NEFSC/PEMAD-ESB-IchthystickII/Documentation/WorkingDrafts/ManufacturingManual/pics/20210115_140601.jpg

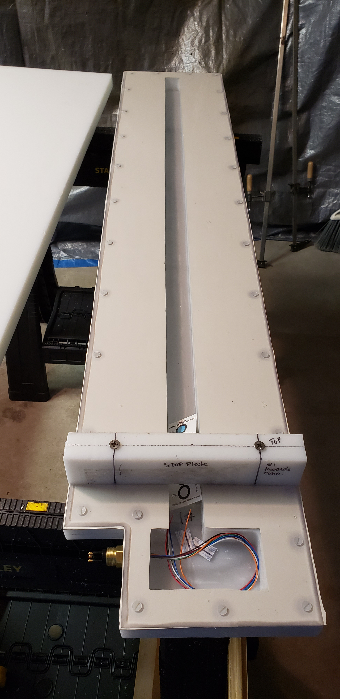
Documentation/WorkingDrafts/ManufacturingManual/pics/20210115_140601.jpg
