NEFSC/PEMAD-ESB-IchthystickII/Documentation/WorkingDrafts/ManufacturingManual/pics/20201014_175649.jpg

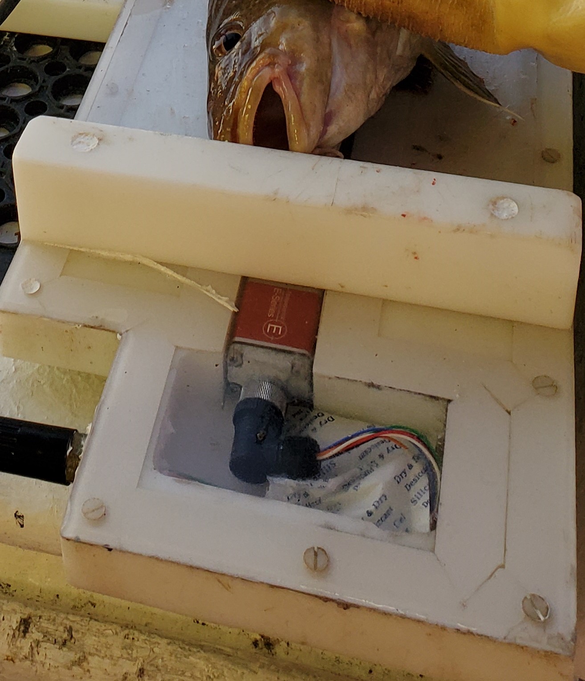
Documentation/WorkingDrafts/ManufacturingManual/pics/20201014_175649.jpg
