NEFSC/PEMAD-ESB-IchthystickII/Schematics/CircuitBoard_Design/!readme1st.md

These designs were done with ExpressPCB Plus Layout and Schematic software.
https://www.expresspcb.com/
