NEFSC/PEMAD-ESB-IchthystickII/Schematics/DisplayDesign_files/CableAssy_IFMB-10406RevB.pdf

# CABLE ASSY IFMB-10406

# Ichthystick II Electronic Fish Measuring Board Case

### D (Generation 3) linear utput connector to onnector. Revision B es the mating connector P-FW07-R connector M12 (D84) receptacle

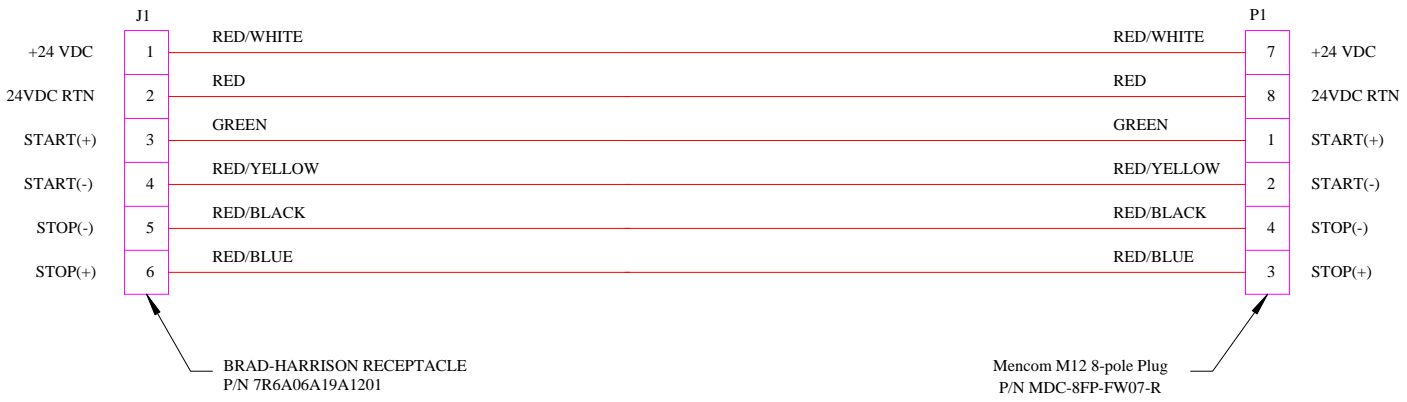
[picture p3: figure]
BRAD-HARRISON RECEPTACLE P/N 7R6A06A19A1201; RED/WHITE; RED; +24 VDC; 24VDC RTN; GREEN; RED/YELLOW; RED/BLACK; RED/BLUE; STOP(-); STOP(+); START(-); START(+); Mencom M12 8-pole Plug P/N MDC-8FP-FW07-R
