NEFSC/PEMAD-ESB-IchthystickII/Schematics/FMB_Display_PartsList.xls

Icthystick Electronic Fish Measuring Board: Parts List
Part ID | Part Type | Description | Qty | Cost | Total | Source P/N | Part Source | Notes
FMB Circuit Board A1 Parts:
A1 |  | Lengthboard Circuit Card (PCB) | 1 | $67.28 | $67.28 |  | Express PCB | Production Service (Qty=4) = $269.11.. (Qty = 10, $308.50)
C1 | 0.01uF | Tantalum, +/- 10% | 1 | $0.17 | $0.17 | 490-3812-ND | Digikey
C2 | 1uF | Tantalum, +/- 10% | 1 | $0.46 | $0.46 | 478-1835-ND | Digikey
C3 | 0.1uF | Tantalum, +/- 10% | 1 | $0.46 | $0.46 | 478-1831-ND | Digikey
C4 | 0.1uF | Tantalum, +/- 10% | 1 | $0.46 | $0.46 | 478-1831-ND | Digikey
C5 | 0.1uF | Tantalum, +/- 10% | 1 | $0.46 | $0.46 | 478-1831-ND | Digikey
C6 | 0.1uF | Tantalum, +/- 10% | 1 | $0.46 | $0.46 | 478-1831-ND | Digikey
C7 | 100uF | Tantalum, +/- 10% | 1 | $2.59 | $2.59 | 478-1844-ND | Digikey
C8 | 10uF | Tantalum, +/- 10% | 1 | $0.71 | $0.71 | 478-1841-ND | Digikey
D1 |  | Red LED, radial, 3 mm, T-1 | 1 | $0.53 | $0.53 | 511-1190-ND | Digikey
A1J1 |  | Molex P/N 22-23-2101 | 1 | $1.31 | $1.31 | WM4208-ND | Digikey | Power and RS-232 Input Header (10-Pin)
A1J2 |  | Molex P/N 22-23-2031 | 1 | $0.66 | $0.66 | WM4201-ND | Digikey | LCD Display Header (3-Pin)
A1J3 |  | Molex P/N 22-23-2101 | 1 | $1.31 | $1.31 | WM4208-ND | Digikey | Interface Control (10-Pin)
A1J4 |  | Sullins P/N PPTC071LFBN-RC, (Single Row, 7 Pins) | 1 | $0.63 | $0.63 | S7005-ND |  | SparkFun Micro SD Header
A1J5 |  | Molex P/N 22-23-2061 | 1 | $1.03 | $1.03 | WM4204-ND | Digikey | Length Sensor Header (6-Pin)
A1J6 |  | Sullins P/N PPTC062LFBN-RC, (Dual Row, 12 Pins) | 1 | $1.14 | $1.14 | S7074-ND | Digikey | Mate for Sena Parani ESD110 12-Pin connector
A1P1 |  | Molex P/N 22-01-3107 | 1 | $0.73 | $0.73 | WM2008-ND | Digikey | Input Power and RS 232 10-Pin Connector.
A1P2 |  | Molex P/N 22-01-3037 | 1 | $0.22 | $0.22 | WM2001-ND | Digikey | LCD Display 3-Pin Connector
A1P3 |  | Molex P/N 22-01-3107 | 1 | $0.73 | $0.73 | WM2008-ND | Digikey | Interface Control 10-Pin Connector
A1P4 |  | optional | 0 |  |  |  |  | SparkFun Micro SD Connector
A1P5 |  | Molex P/N 22-01-3067 | 1 | $0.44 | $0.44 | WM2004-ND | Digikey | Length Sensor 6-Pin Connector.
 | Sockets | Molex P/N 08-55-0102 | 100 | $0.28 | $28.00 | WM2312-ND | Digikey | Contact terminals (female) for connectors.
R1 | 10K | 0.25 W, carbon composite resistor, +/- 5% | 1 | $0.42 | $0.42 | OD103JE-ND | Digikey
R2 | 10K | 0.25 W, carbon composite resistor, +/- 5% | 1 | $0.42 | $0.42 | OD103JE-ND | Digikey
R3 | 10K | 0.25 W, carbon composite resistor, +/- 5% | 1 | $0.42 | $0.42 | OD103JE-ND | Digikey
R4 | 4.7K | 0.25 W, carbon composite resistor, +/- 5% | 1 | $0.42 | $0.42 | OD472JE-ND | Digikey
R5 | 4.7K | 0.25 W, carbon composite resistor, +/- 5% | 1 | $0.42 | $0.42 | OD472JE-ND | Digikey
R6 | 4.7K | 0.25 W, carbon composite resistor, +/- 5% | 1 | $0.42 | $0.42 | OD472JE-ND | Digikey
R7 | 4.7K | 0.25 W, carbon composite resistor, +/- 5% | 1 | $0.42 | $0.42 | OD472JE-ND | Digikey
R8 | 1.2k | 0.25 W, carbon composite resistor, +/- 5% | 1 | $0.42 | $0.42 | OD122JE-ND | Digikey
R11 | 100 | 0.25 W, carbon composite resistor, +/- 5% | 1 | $0.42 | $0.42 | OD101JE-ND | Digikey
R12 | 20K | 0.25 W, carbon composite resistor, +/- 5% | 1 | $0.42 | $0.42 | OD203JE-ND | Digikey
R13 | 20K | 0.25 W, carbon composite resistor, +/- 5% | 1 | $0.42 | $0.42 | OD203JE-ND | Digikey
R14 | 100 | 0.25 W, carbon composite resistor, +/- 5% | 1 | $0.42 | $0.42 | OD101JE-ND | Digikey
R15 | 20K | 0.25 W, carbon composite resistor, +/- 5% | 1 | $0.42 | $0.42 | OD203JE-ND | Digikey
R16 | 20K | 0.25 W, carbon composite resistor, +/- 5% | 1 | $0.42 | $0.42 | OD203JE-ND | Digikey
R18 | 20K | 0.25 W, carbon composite resistor, +/- 5% | 1 | $0.42 | $0.42 | OD203JE-ND | Digikey
R19 | 20K | 0.25 W, carbon composite resistor, +/- 5% | 1 | $0.42 | $0.42 | OD203JE-ND | Digikey
R20 | 20K | 0.25 W, carbon composite resistor, +/- 5% | 1 | $0.42 | $0.42 | OD203JE-ND | Digikey
R21 | 20K | 0.25 W, carbon composite resistor, +/- 5% | 1 | $0.42 | $0.42 | OD203JE-ND | Digikey
U1 | P8X32A-D40 | Parallax Propeller Microcontroller | 1 | $12.95 | $12.95 |  | Parallax | www.parallax.com
U2 | MAX3232 | MAX3232ECPE+-ND, RS232 Driver by MAXIM | 1 | $3.87 | $3.87 | 99K3240 | Newark
U3 | 24LC256 | 24LC256-E/P 256K EEPROM by MICROCHIP | 1 | $1.02 | $1.02 | 54K2864 | Newark | Newark only sells -I/P Type. I indicates Temp range -45 to 85 C. E = -45 to 125 C.
U4 | 24LC256 | 24LC256-E/P 256K EEPROM by MICROCHIP | 1 | $1.02 | $1.02 | 54K2864 | Newark | Newark only sells -I/P Type. I indicates Temp range -45 to 85 C. E = -45 to 125 C.
U5 | LM1086-3.3 | LM1086CT-3.3-NOPB by National Semiconductor | 1 | $2.44 | $2.44 | 41K3395 | Newark
U6 | PT78H205 | PT78HT205H-ND by Texas Instruments | 1 | $13.45 | $13.45 | 75C7141 | Newark | Integrated Switching Regulator, Vin=9V min.
U7 | SN75179B | RS 422 Line Driver by Texas Instruments | 1 | $1.29 | $1.29 | 60K6930 | Newark | Have 4 already…
U9 | CC3-1212DFE | Lambda Ultra Compact 3W Dual-Output DC-DC converter | 1 | $11.10 | $11.10 | 05M6992 | Newark
 | ESD110V2 | ESD110V2 Bluetooth Transceiver, Sena Technologies | 1 | $62.00 | $62.00 | ESD110V2-01 | Sena Tech | www.lemosint.com
SP1 | BRP1408 | ICC Inc. Audio Alarm P/N BRP1408P-12-CS | 1 | $0.50 | $0.50 | 623-2004 | Allied | Audio Alarm
Q1 | 2N3904 | 2N3904G Bipolar Transistor NPN, ON Semiconductor | 10 | $0.05 | $0.50 | 45J2473 | Newark
X1 | 5MHz | ECS-50-20-4 5.0 MHz Crystal Oscillator by ECS | 1 | $0.58 | $0.58 | X410-ND | Digikey | This is a 5.0000 MHz crystal
 |  | DIP Socket, 8-Pin, SPC P/N SPC15494 | 2 | $0.06 | $0.12 | 82K7786 | Newark
 |  | DIP Socket, 16-Pin, SPC P/N SPC15498 | 1 | $0.12 | $0.12 | 82K7788 | Newark
 |  | DIP Socket, 40-Pin, SPC P/N SPC15505 | 1 | $0.30 | $0.30 | 82K7793 | Newark
Display Case Parts:
 | LCD | Parallax Serial LCD display, 4 x 20 | 1 | $39.99 | $39.99 | 27979 | Parallax | www.parallax.com
 |  | Display Case (P/O Fiberglass Display Case price..) | 1 | $50.79 | $50.79 | 39C8379 | Newark
S1 | Power Switch | SAIA-Burgess TH25 Push button P/N 511015 | 1 | $6.63 | $6.63 | 804-4504 | Allied | IP67 Rated Switch, Maintained
S2 | Menu Switch | Bulgin P/N MP0042/3 | 1 | $4.72 | $4.72 | 95M9941 | Newark | IP67 Rated Switch, Momentary
S3 | Prev Switch | Bulgin P/N MP0042/3 | 1 | $4.72 | $4.72 | 95M9941 | Newark | IP67 Rated Switch, Momentary
S4 | Next Switch | Bulgin P/N MP0042/3 | 1 | $4.72 | $4.72 | 95M9941 | Newark | IP67 Rated Switch, Momentary
S5 | Enter Switch | Bulgin P/N MP0042/3 | 1 | $4.72 | $4.72 | 95M9941 | Newark | IP67 Rated Switch, Momentary
 | Green Lens | SAIA-Burgess TH25 Flat Lens P/N 561211 | 1 | $1.22 | $1.22 | 804-4522 | Allied | Green lens for Power push button
 | Contact Blocks | SAIA-Burgess TH25 Contact Blocks P/N 593566-000 | 2 | $6.57 | $13.14 | 804-1100 | Allied | Contact Blocks, 1N.O./N.C. quick connect
 | Lamp/LED | T 1-3/4 " Midget Groove Green LED, P/N 1512135UG3 | 1 | $4.45 | $4.45 | 234-3125 | Allied | 24 VDC LED for Power Switch S1
 | LED Indicator | SloanLED 5/16" Low-Profile Water Resistant LED Ind, P/N 253-21 | 1 | $15.43 | $15.43 | 265-1611 | Allied | 2 VDC LED, panel mounted, for Display Assy.
 | Receptacle | Brad-Harrison P/N 7R6A06A19A1201, Micro-Change 6 Pin Male | 1 | $21.33 | $21.33 |  | Brad-Harrison | Receptacle for Fishboard Case
 | Receptacle | Brad-Harrison P/N 7R6A00A19A1201, Micro-Change 6 Pole Female | 1 | $22.64 | $22.64 |  | Brad-Harrison | Receptacle for Display Case
 | Cable Assy | Brad-Harrison P/N 776030D02F1201, Micro-Change 6 Pole Male/Female | 1 | $44.25 | $44.25 |  | Brad-Harrison | Cable Assy between Fishboard and Display (12 foot.)
 | Closure Cap | Brad-Harrison P/N 70015, Micro-Change Male Thread Cap | 2 | $5.85 | $11.70 |  | Brad-Harrison
 | Closure Cap | Brad-Harrison P/N 70010, Micro-Change Female Thread Cap | 2 | $6.06 | $12.12 |  | Brad-Harrison
 | Receptacle | Bulgin Circular Connector P/N PX0738/S | 1 | $14.83 | $14.83 | 48F2460 | Newark | Receptacle for Display Case
 |  |  | TOTAL: |  | $506.00
S1 | PowerSwitch Alternate | NKK P/N YB16WRKW01-5F24-JF-R0 |  | $21.96 |  | YB16WRKW01-5F24-JF-ND | Digikey
 | Menu - Alternate | NKK P/N YB15WRKW01-GB-R0 |  | $13.66 |  | YB15WRKW01-GB-ND | Digikey
