NEFSC/PEMAD-ESB-IchthystickII/Documentation/WorkingDrafts/ManufacturingManual/pics/20201223_102427.jpg

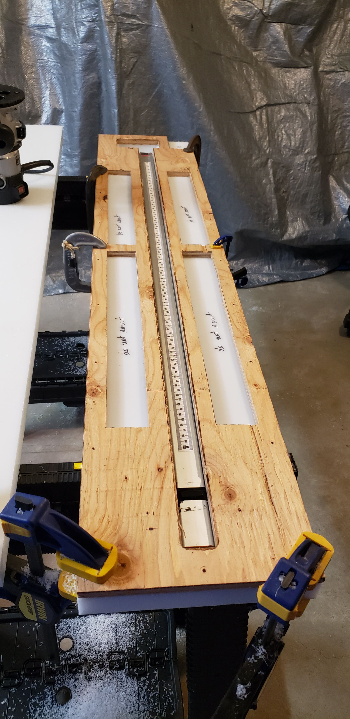
Documentation/WorkingDrafts/ManufacturingManual/pics/20201223_102427.jpg
