NEFSC/PEMAD-ESB-IchthystickII/Documentation/WorkingDrafts/ManufacturingManual/pics/20201223_102439.jpg

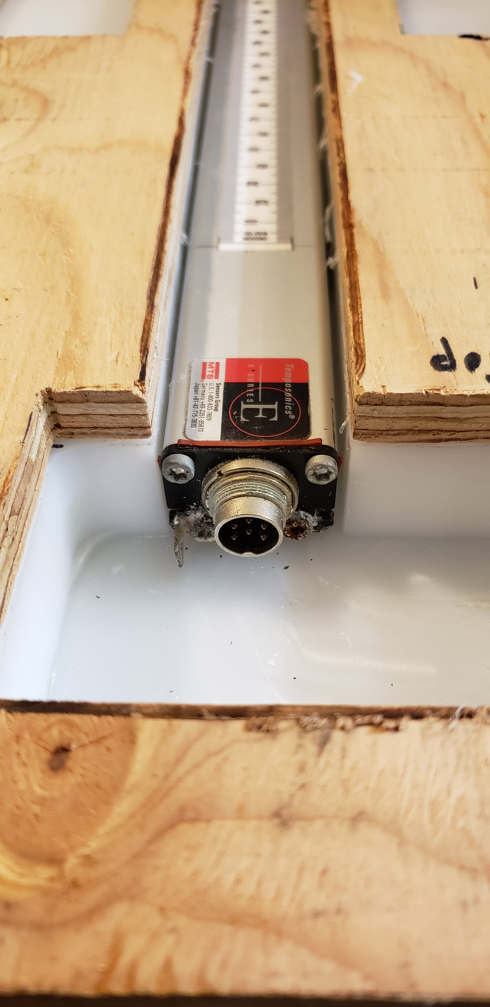
Documentation/WorkingDrafts/ManufacturingManual/pics/20201223_102439.jpg
