NEFSC/PEMAD-ESB-IchthystickII/Documentation/WorkingDrafts/ManufacturingManual/pics/20201223_105548.jpg

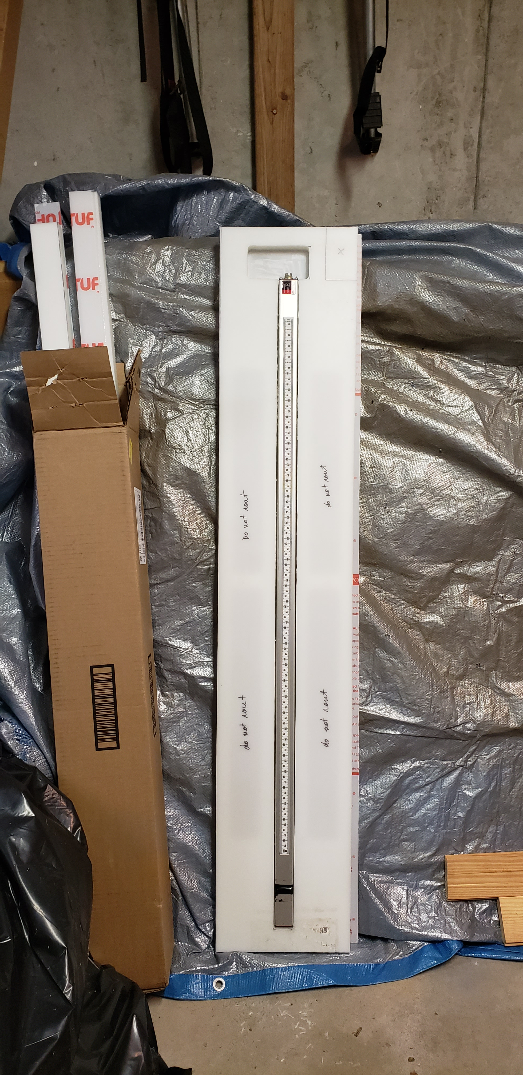
Documentation/WorkingDrafts/ManufacturingManual/pics/20201223_105548.jpg
