NEFSC/PEMAD-ESB-IchthystickII/Documentation/WorkingDrafts/ManufacturingManual/pics/20210114_083233.jpg

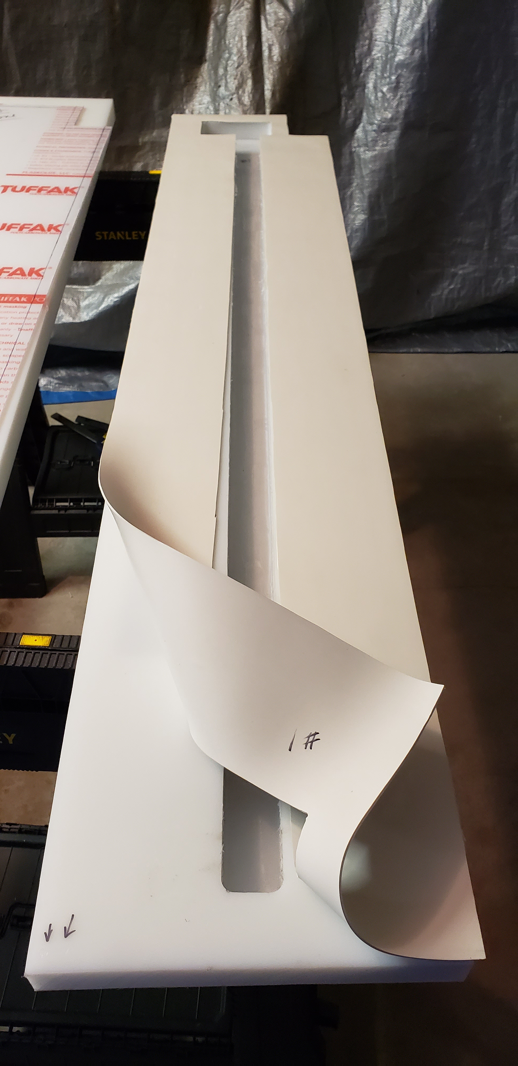
Documentation/WorkingDrafts/ManufacturingManual/pics/20210114_083233.jpg
