NEFSC/PEMAD-ESB-IchthystickII/Documentation/WorkingDrafts/ManufacturingManual/pics/20210114_083544.jpg

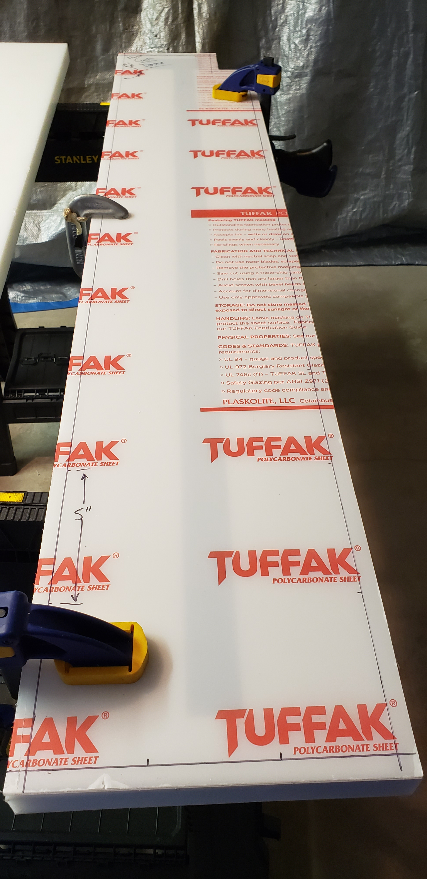
Documentation/WorkingDrafts/ManufacturingManual/pics/20210114_083544.jpg
