NEFSC/PEMAD-ESB-IchthystickII/Documentation/WorkingDrafts/ManufacturingManual/pics/20210114_085543.jpg

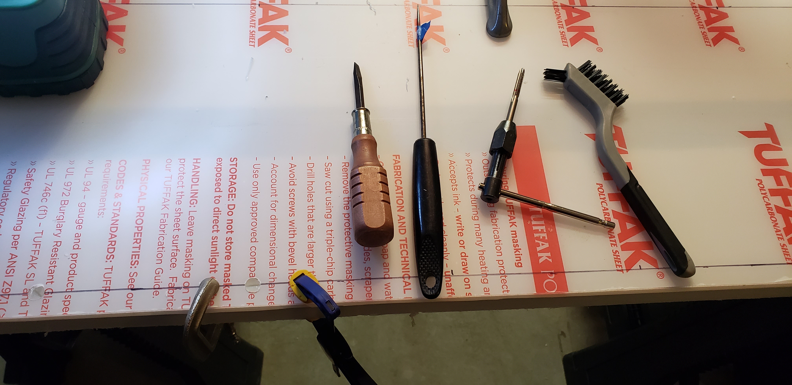
Documentation/WorkingDrafts/ManufacturingManual/pics/20210114_085543.jpg
