NEFSC/PEMAD-ESB-IchthystickII/Documentation/WorkingDrafts/ManufacturingManual/pics/20210115_090856.jpg

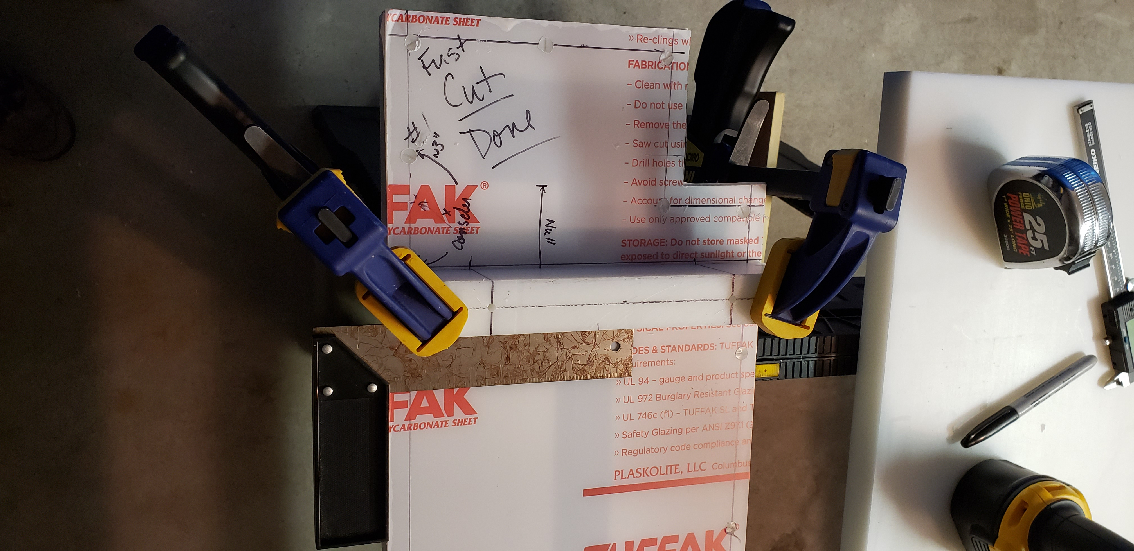
Documentation/WorkingDrafts/ManufacturingManual/pics/20210115_090856.jpg
