NEFSC/PEMAD-ESB-IchthystickII/Documentation/WorkingDrafts/ManufacturingManual/pics/20210115_140612.jpg

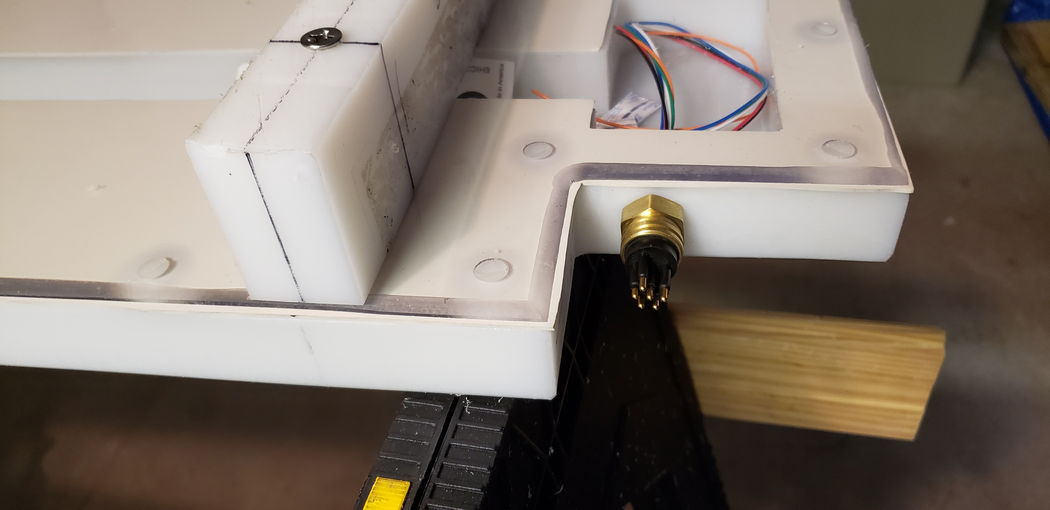
Documentation/WorkingDrafts/ManufacturingManual/pics/20210115_140612.jpg
