NEFSC/PEMAD-ESB-IchthystickII/Documentation/WorkingDrafts/ManufacturingManual/pics/20210115_141240.jpg

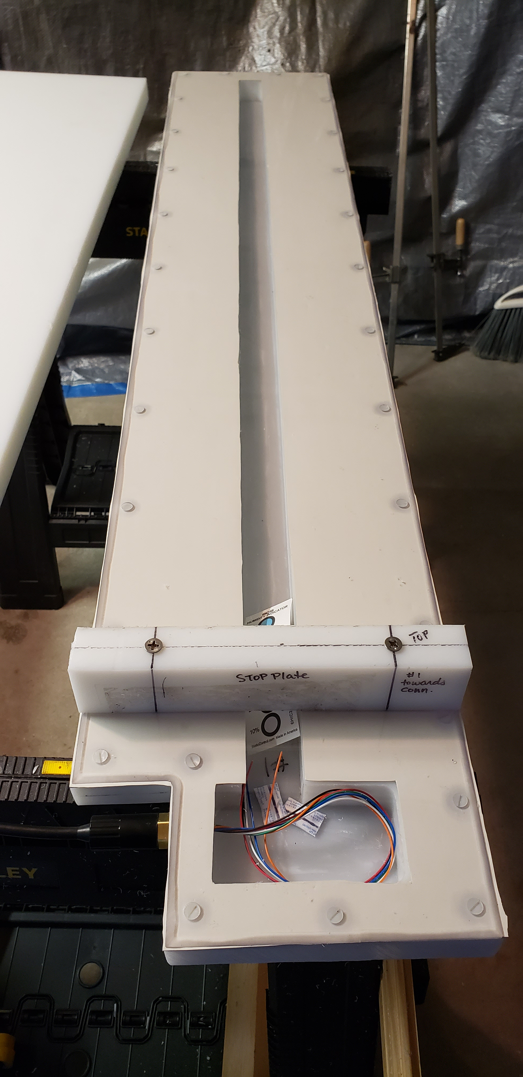
Documentation/WorkingDrafts/ManufacturingManual/pics/20210115_141240.jpg
