NEFSC/PEMAD-ESB-IchthystickII/Documentation/WorkingDrafts/ManufacturingManual/pics/20210115_141254.jpg

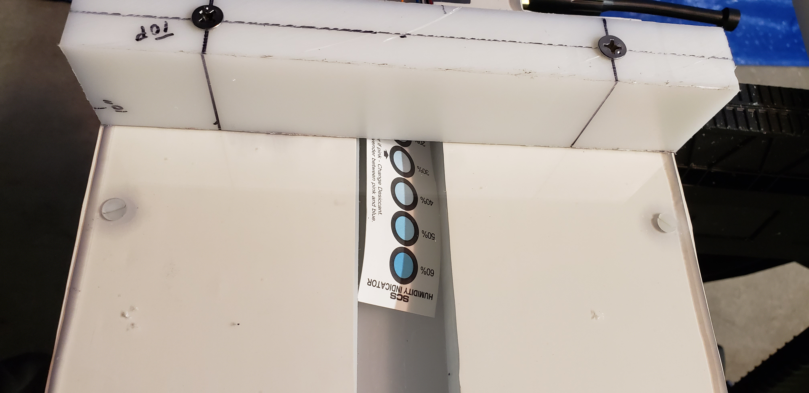
Documentation/WorkingDrafts/ManufacturingManual/pics/20210115_141254.jpg
