NEFSC/PEMAD-ESB-IchthystickII/Documentation/WorkingDrafts/ManufacturingManual/pics/20210115_141303.jpg

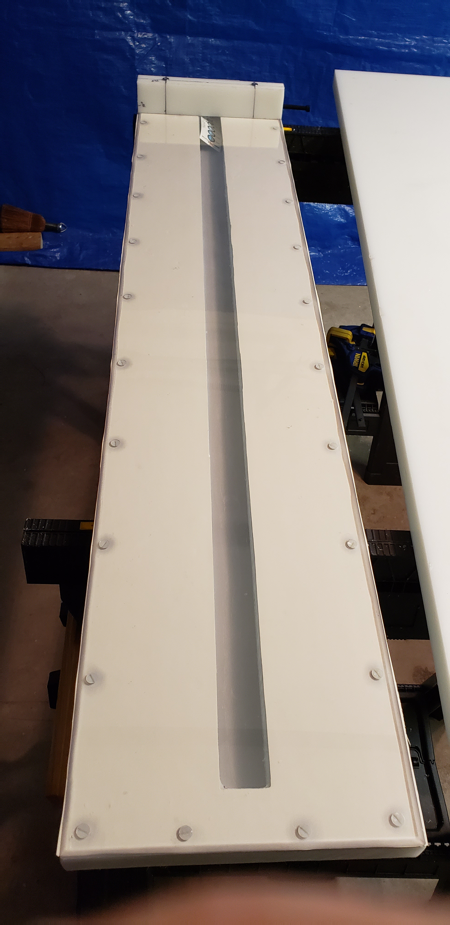
Documentation/WorkingDrafts/ManufacturingManual/pics/20210115_141303.jpg
