NEFSC/PEMAD-ESB-IchthystickII/Documentation/WorkingDrafts/ManufacturingManual/pics/20210115_141323.jpg

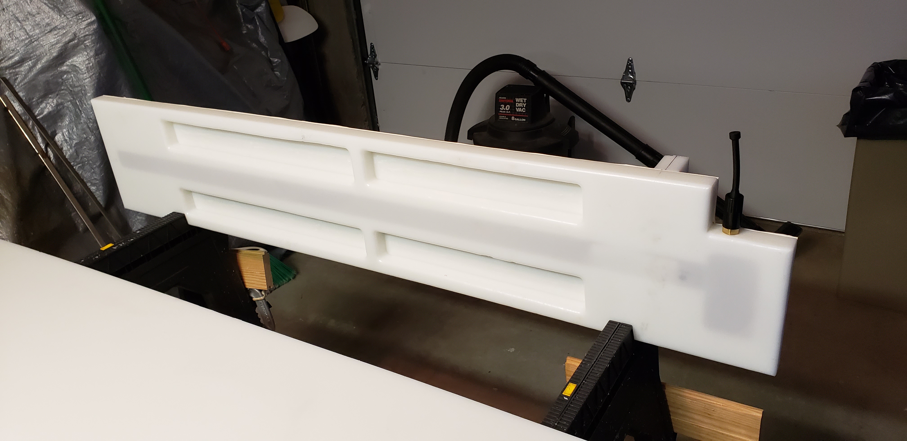
Documentation/WorkingDrafts/ManufacturingManual/pics/20210115_141323.jpg
