NEFSC/PEMAD-ESB-IchthystickII/Documentation/WorkingDrafts/ManufacturingManual/pics/20210115_142032.jpg

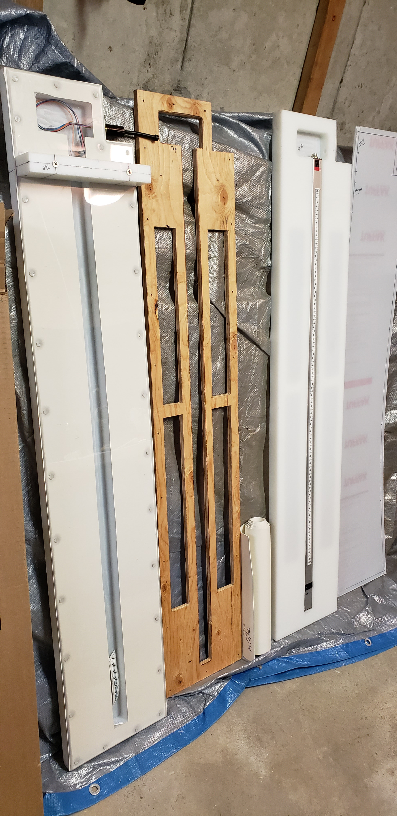
Documentation/WorkingDrafts/ManufacturingManual/pics/20210115_142032.jpg
