NEFSC/PEMAD-ESB-IchthystickII/Documentation/WorkingDrafts/ManufacturingManual/pics/20210115_144513.jpg

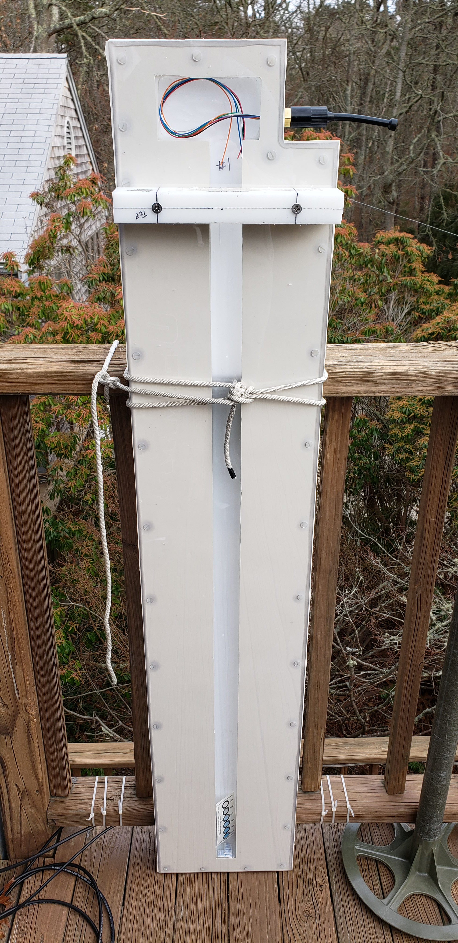
Documentation/WorkingDrafts/ManufacturingManual/pics/20210115_144513.jpg
