NEFSC/PEMAD-ESB-IchthystickII/Documentation/WorkingDrafts/ManufacturingManual/pics/20210115_144519.jpg

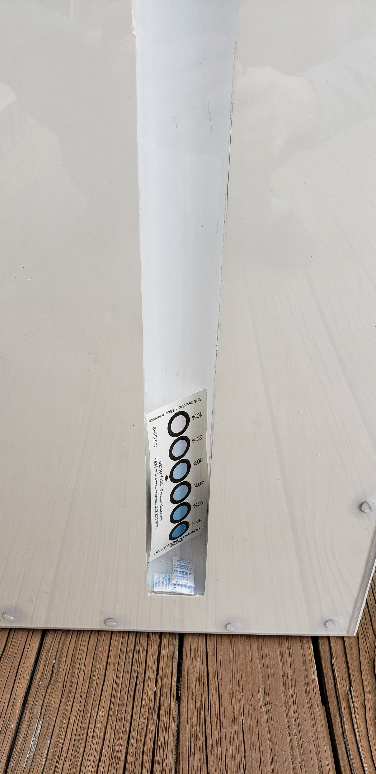
Documentation/WorkingDrafts/ManufacturingManual/pics/20210115_144519.jpg
