NEFSC/PEMAD-ESB-IchthystickII/Documentation/WorkingDrafts/ManufacturingManual/pics/20210116_084024.jpg

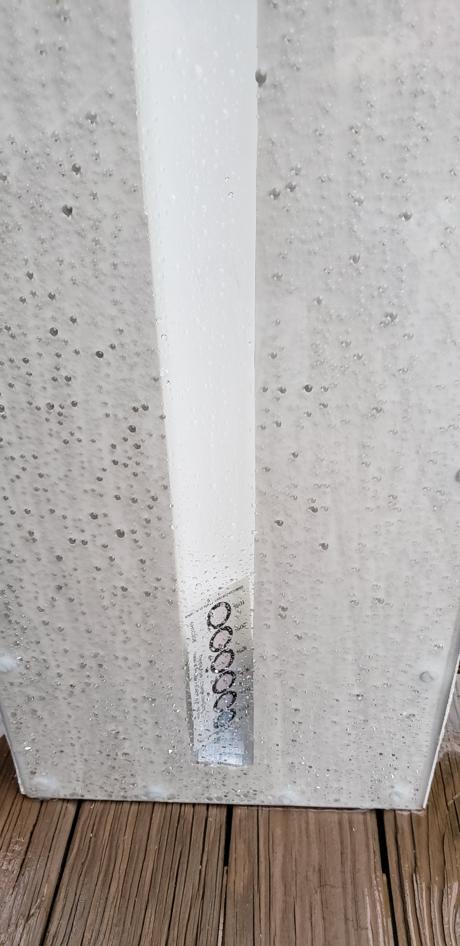
Documentation/WorkingDrafts/ManufacturingManual/pics/20210116_084024.jpg
