NEFSC/PEMAD-ESB-IchthystickII/Documentation/WorkingDrafts/ManufacturingManual/pics/20210116_084037.jpg

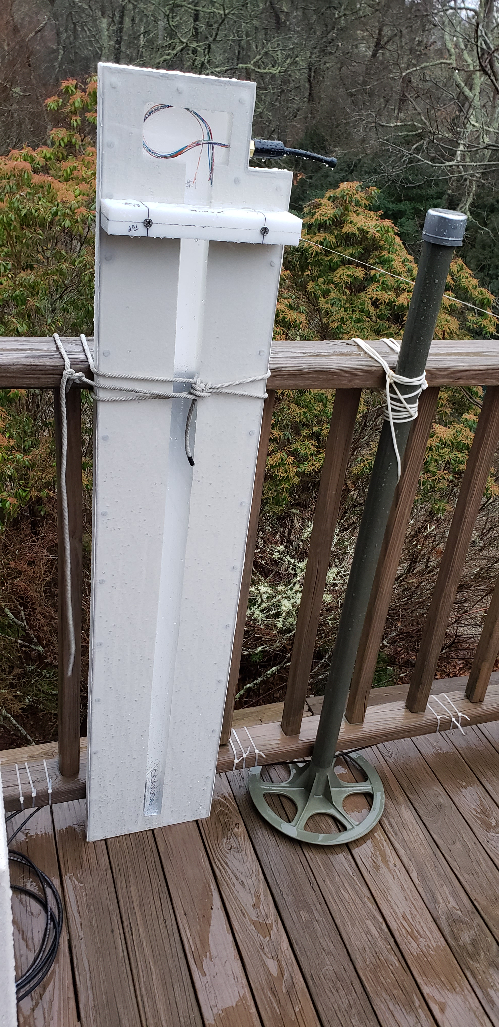
Documentation/WorkingDrafts/ManufacturingManual/pics/20210116_084037.jpg
