NEFSC/PEMAD-ESB-IchthystickII/Documentation/WorkingDrafts/ManufacturingManual/pics/20210116_132902.jpg

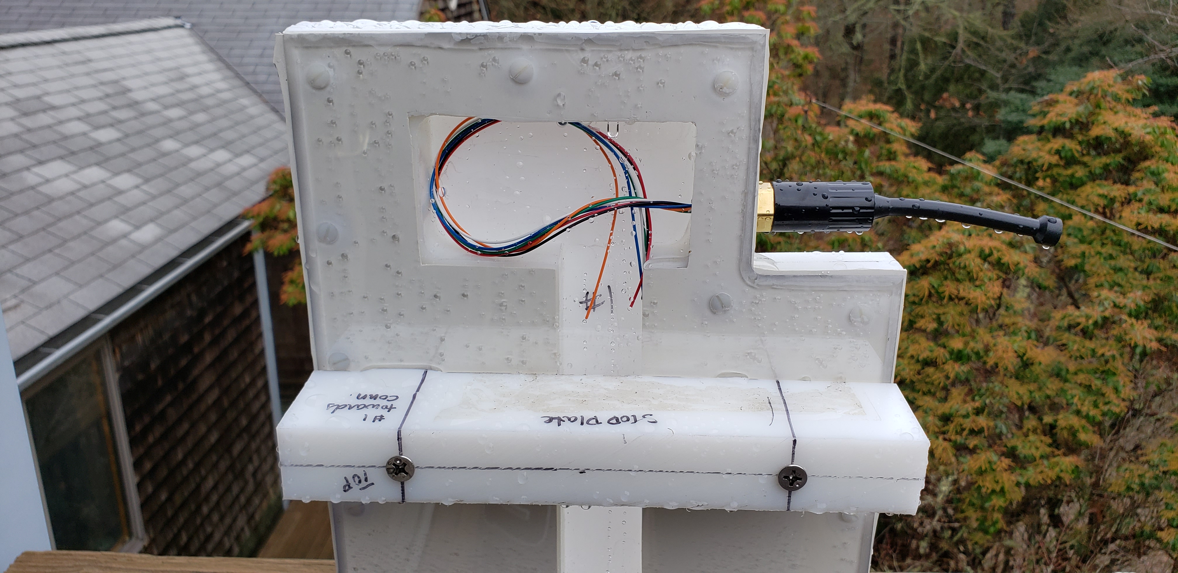
Documentation/WorkingDrafts/ManufacturingManual/pics/20210116_132902.jpg
