NEFSC/PEMAD-ESB-IchthystickII/Documentation/WorkingDrafts/ManufacturingManual/pics/20210116_132914.jpg

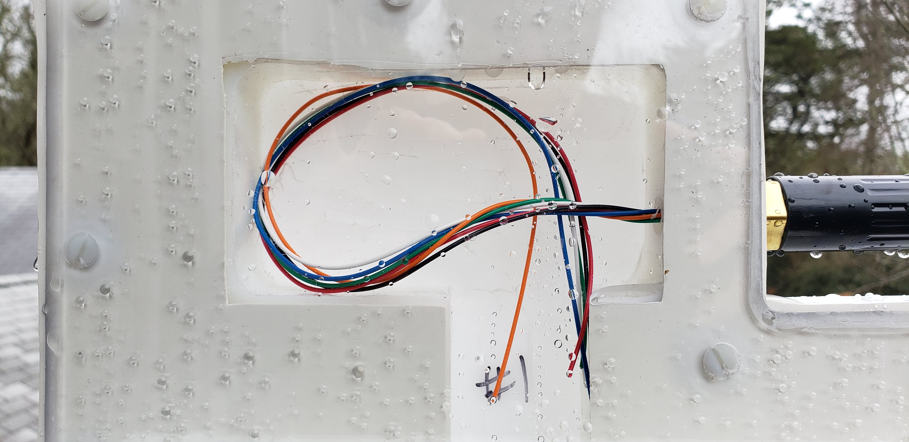
Documentation/WorkingDrafts/ManufacturingManual/pics/20210116_132914.jpg
