NEFSC/PEMAD-ESB-IchthystickII/Documentation/WorkingDrafts/ManufacturingManual/pics/20210122_075511.jpg

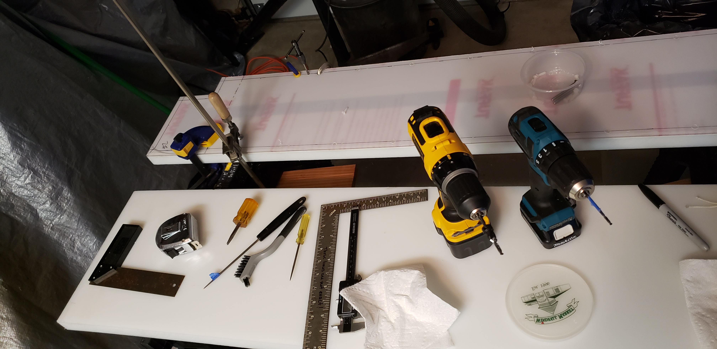
Documentation/WorkingDrafts/ManufacturingManual/pics/20210122_075511.jpg
