NEFSC/PEMAD-ESB-IchthystickII/Documentation/WorkingDrafts/ManufacturingManual/pics/20210125_084636.jpg

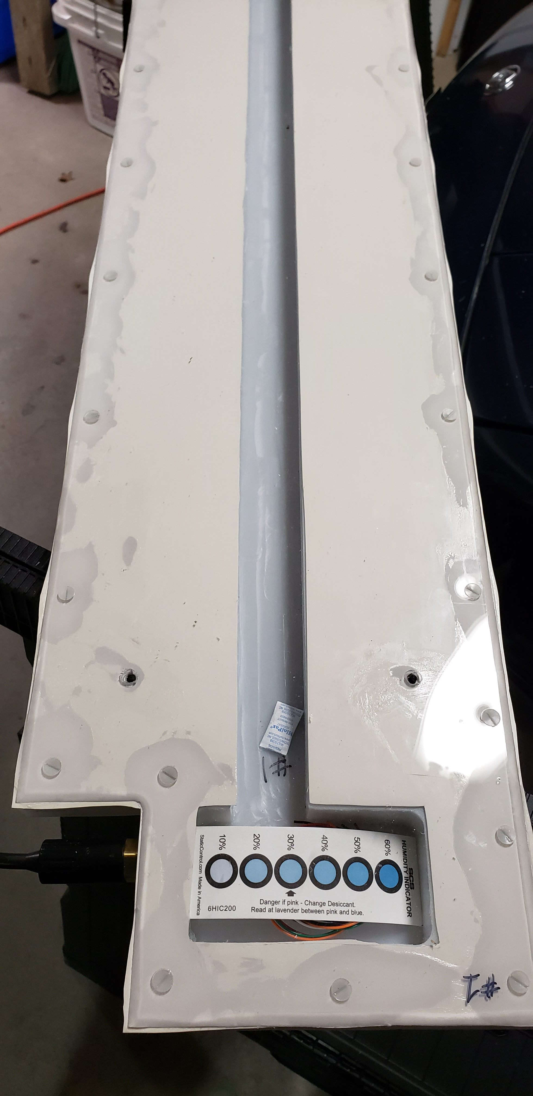
Documentation/WorkingDrafts/ManufacturingManual/pics/20210125_084636.jpg
