NEFSC/PEMAD-ESB-IchthystickII/Documentation/WorkingDrafts/ManufacturingManual/pics/20210125_084650.jpg

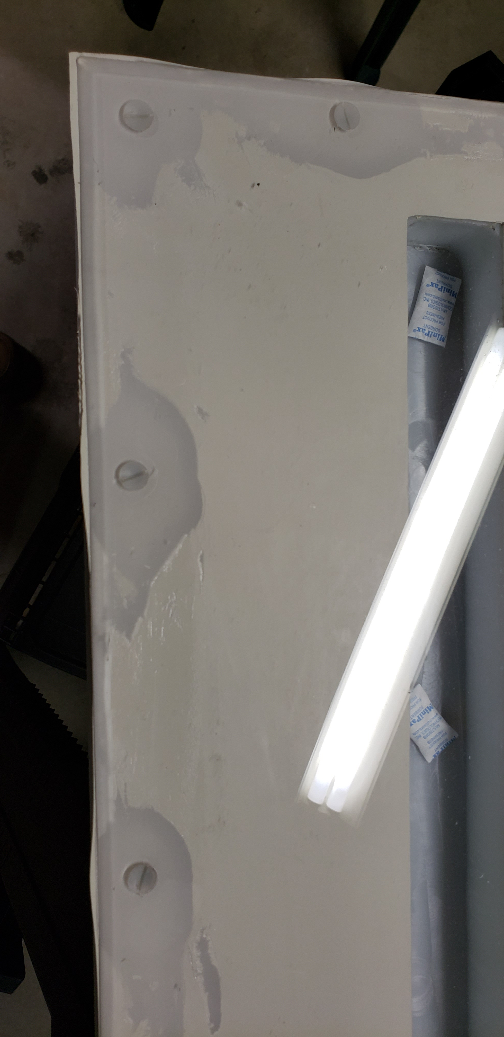
Documentation/WorkingDrafts/ManufacturingManual/pics/20210125_084650.jpg
