NEFSC/PEMAD-ESB-IchthystickII/Documentation/WorkingDrafts/ManufacturingManual/pics/20210125_084740.jpg

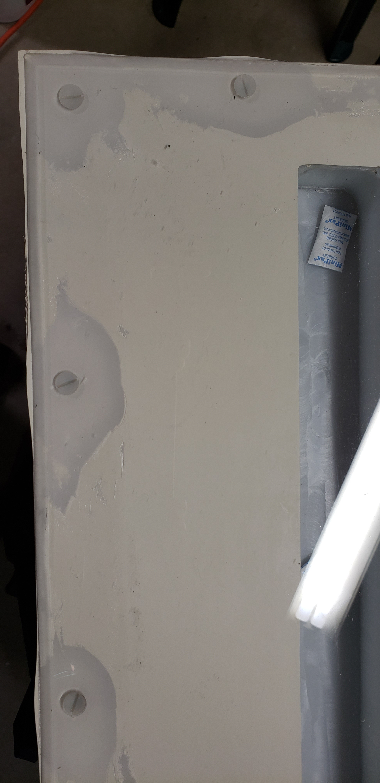
Documentation/WorkingDrafts/ManufacturingManual/pics/20210125_084740.jpg
