NEFSC/PEMAD-ESB-IchthystickII/Documentation/WorkingDrafts/ManufacturingManual/pics/20210125_084823.jpg

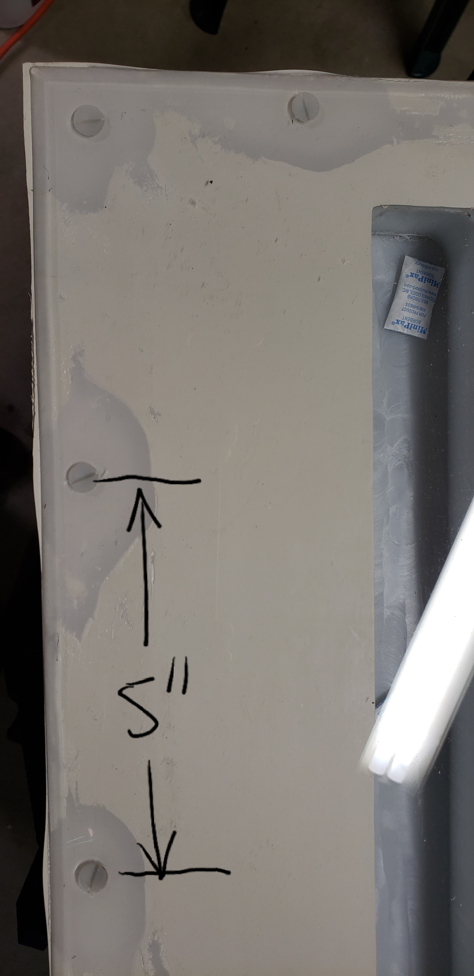
Documentation/WorkingDrafts/ManufacturingManual/pics/20210125_084823.jpg
