NEFSC/PEMAD-ESB-IchthystickII/Documentation/WorkingDrafts/ManufacturingManual/pics/FB001-000Assy-20210114.png

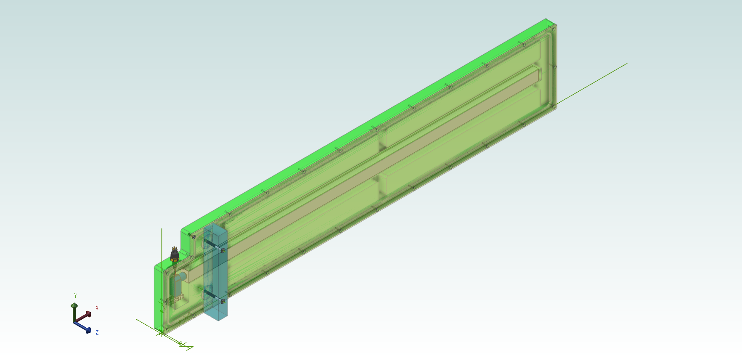
Documentation/WorkingDrafts/ManufacturingManual/pics/FB001-000Assy-20210114.png
