NEFSC/PEMAD-ESB-IchthystickII/Schematics/IFMB_PowerCable.pdf

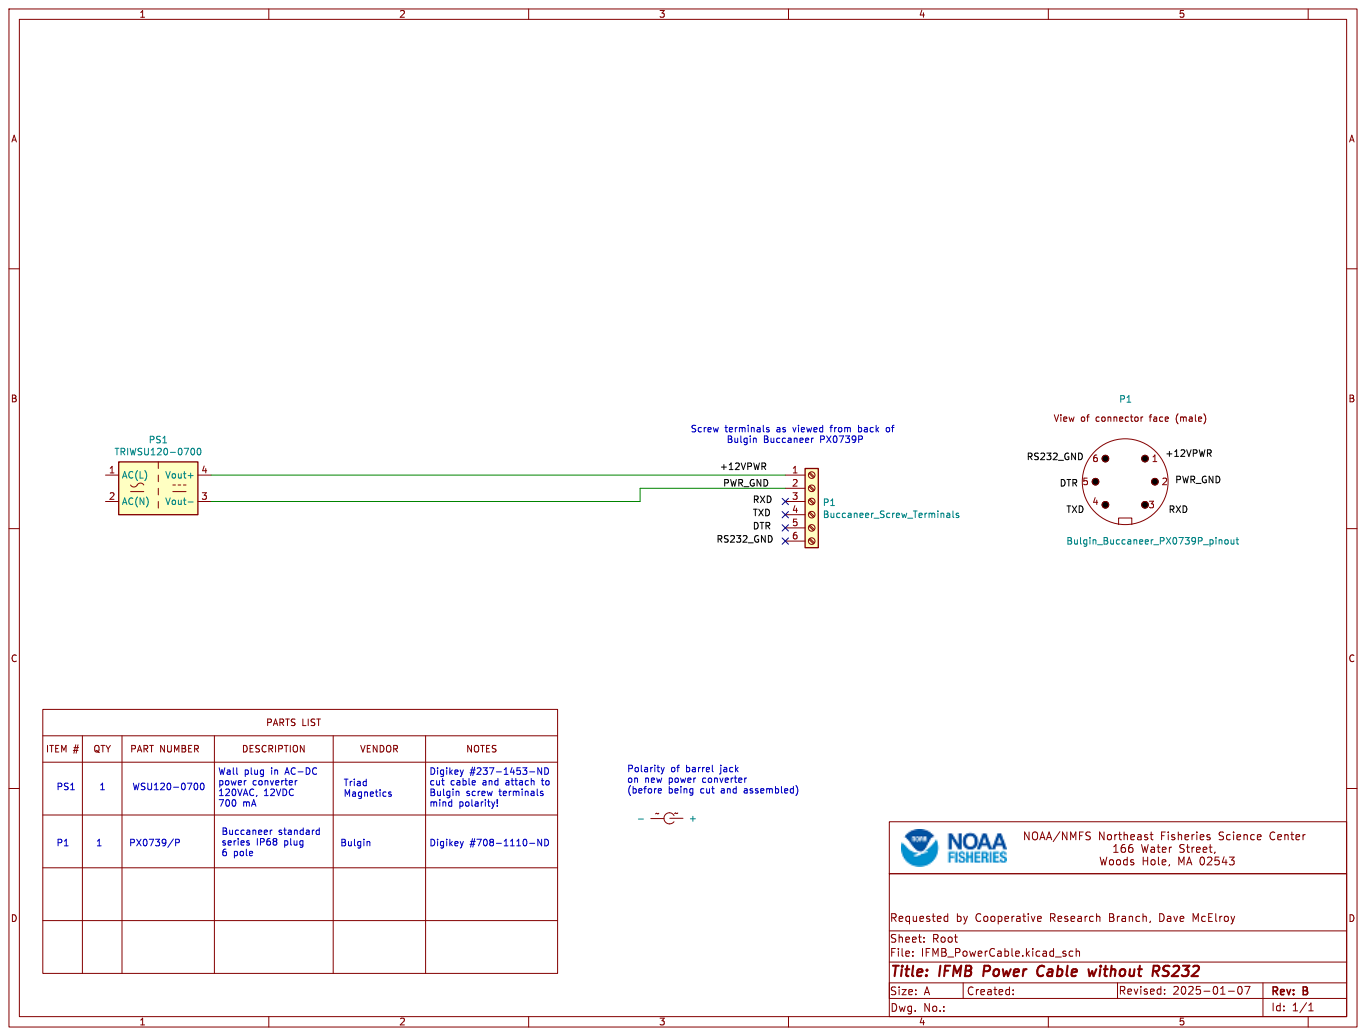
[picture p72: page 1]

RS232_GND Wall plug in AC-DC

ITEM # | | PART NUMBER | DESCRIPTION | | NOTES

1 | | power converter 120VAC, 12VDC 700 mA | Triad Magnetics Bulgin WSU120-0700 | Digikey #237-1453-ND cut cable and attach to Bulgin screw terminals mind polarity! P1PS1 Digikey #708-1110-ND

1 | PX0739/P | Buccaneer standard series IP68 plug 6 pole

Id: 1/1 Title: IFMB Power Cable without RS232
