NEFSC/PEMAD-ESB-IchthystickII/Schematics/CircuitBoard_Design/NEFSC_FMB_RevF_schematic.pdf

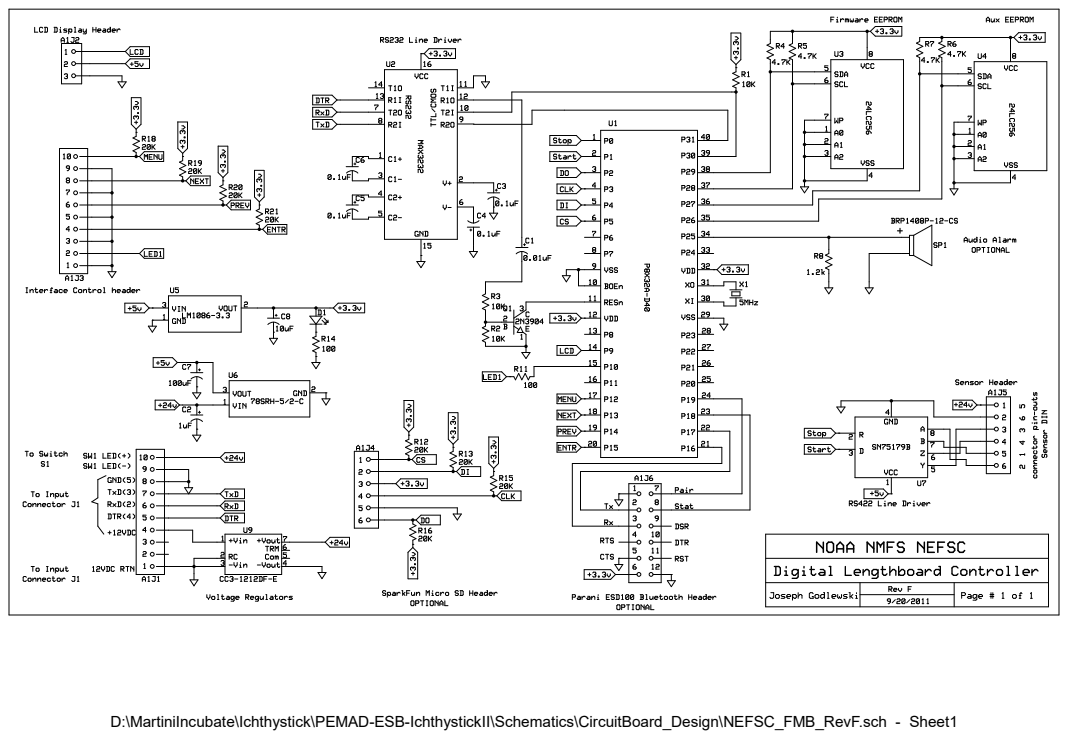
[picture p73: page 1]

D:\MartiniIncubate\Ichthystick\PEMAD-ESB-IchthystickII\Schematics\CircuitBoard_Design\NEFSC_FMB_RevF.sch - Sheet1
