NEFSC/PEMAD-ESB-IchthystickII/Schematics/DisplayDesign_files/BACK_PLANE.pdf

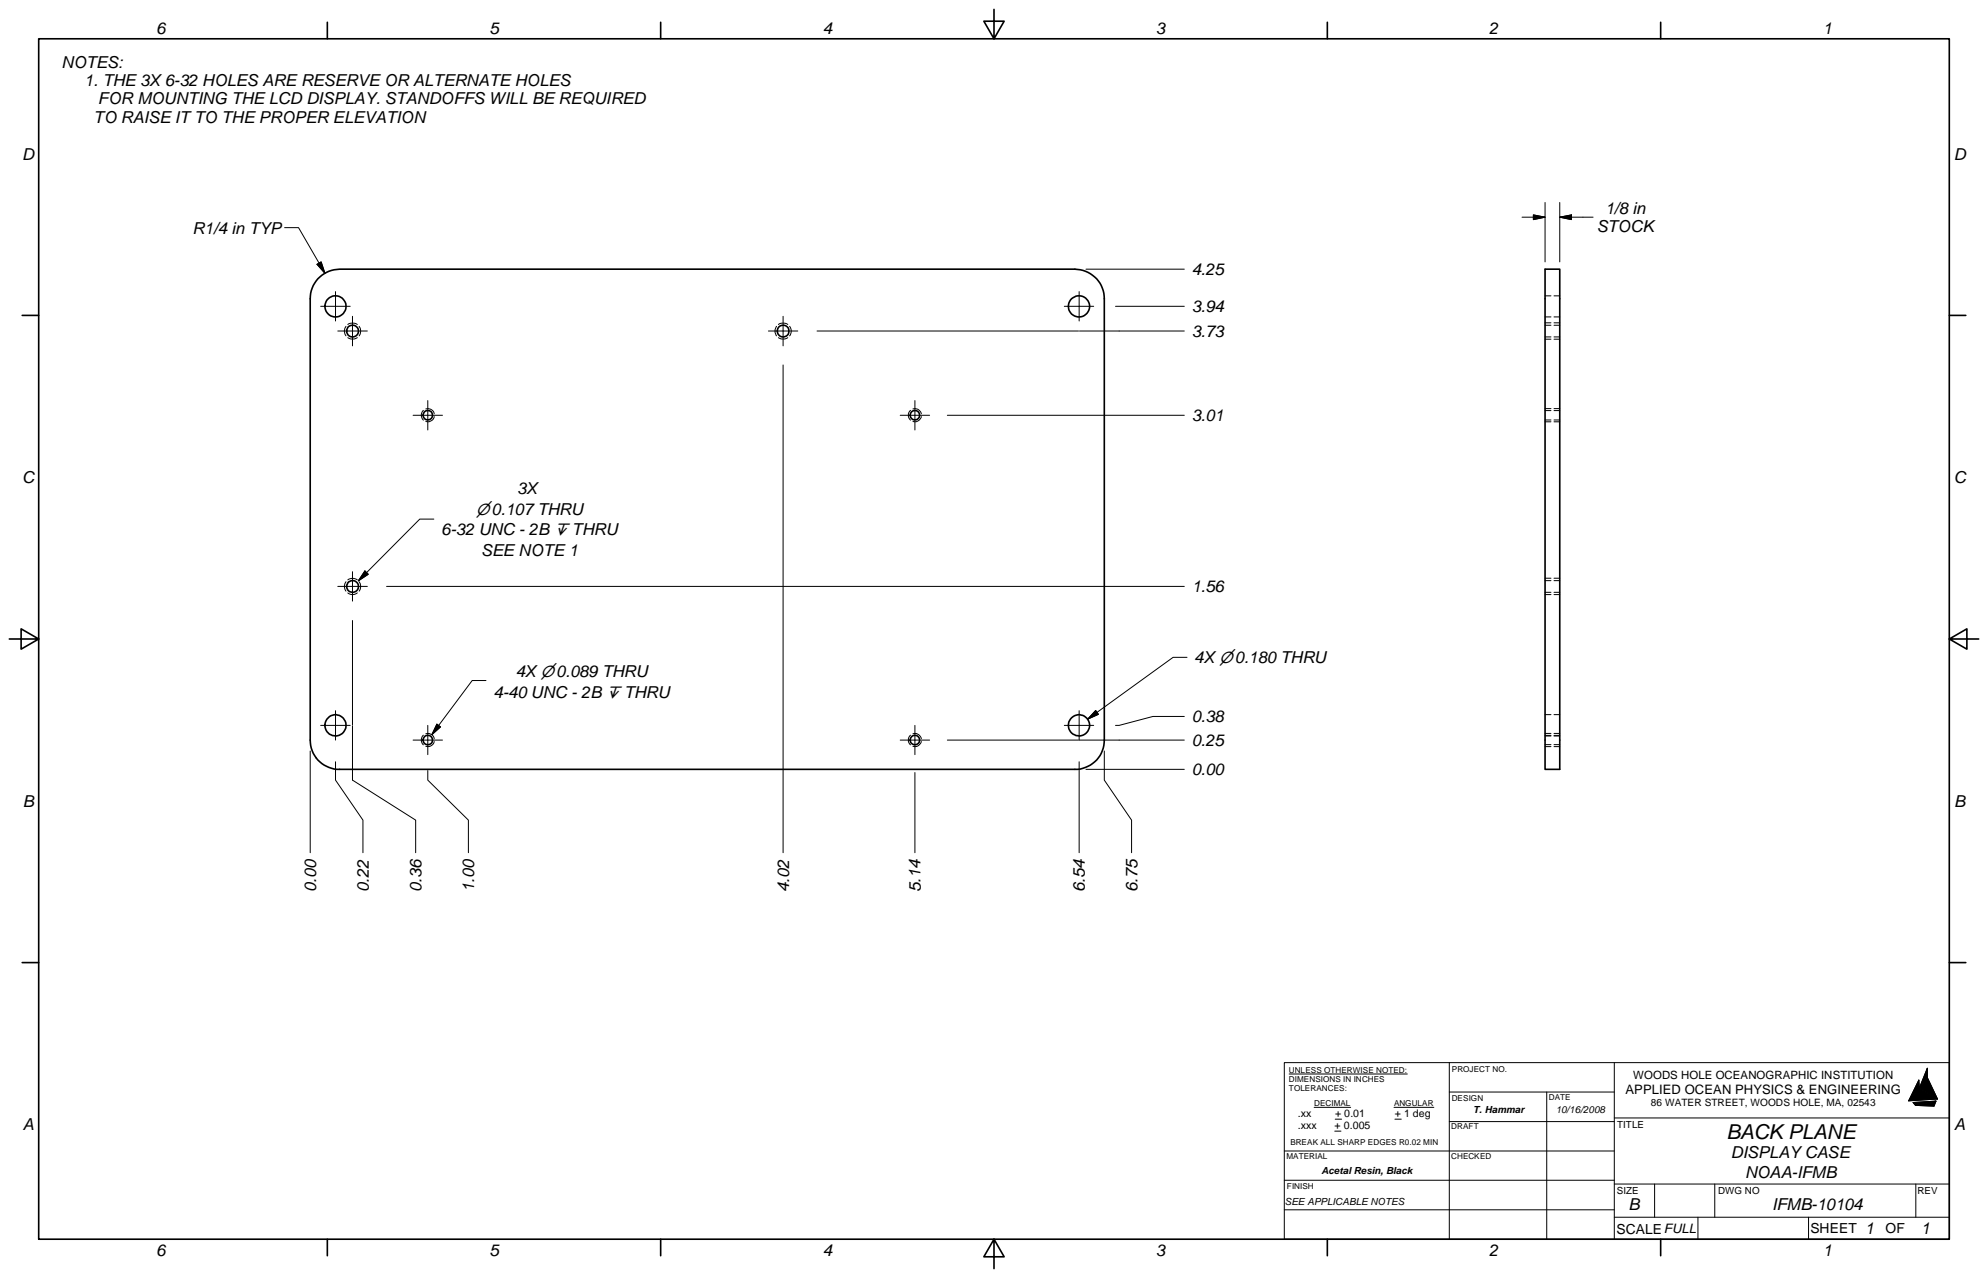
[picture p74: page 1]
SIZE; DWG NO; REV; SCALE; SHEET; CHECKED; DRAFT; TITLE; DECIMAL; ANGULAR; + 1 deg; .xxx; BACK PLANE; IFMB-10104; Acetal Resin, Black; NOAA-IFMB; DISPLAY CASE; FULL; 1/8 in STOCK; 3X 0.107 THRU 6-32 UNC - 2B THRU SEE NOTE 1; 4X 0.180 THRU; R1/4 in TYP; 4X 0.089 THRU 4-40 UNC - 2B THRU

NOTES:
1. THE 3X 6-32 HOLES ARE RESERVE OR ALTERNATE HOLES
FOR MOUNTING THE LCD DISPLAY. STANDOFFS WILL BE REQUIRED
TO RAISE IT TO THE PROPER ELEVATION

UNLESS OTHERWISE NOTED:
DIMENSIONS IN INCHES
TOLERANCES:

PROJECT NO. | WOODS HOLE OCEANOGRAPHIC INSTITUTION APPLIED OCEAN PHYSICS & ENGINEERING

DESIGN T. Hammar | 10/16/2008 | 86 WATER STREET, WOODS HOLE, MA, 02543 DATE

BREAK ALL SHARP EDGES R0.02 MIN
MATERIAL

FINISH
SEE APPLICABLE NOTES
