NEFSC/PEMAD-ESB-IchthystickII/Schematics/DisplayDesign_files/CableAssy_IFMB-10406RevA.pdf

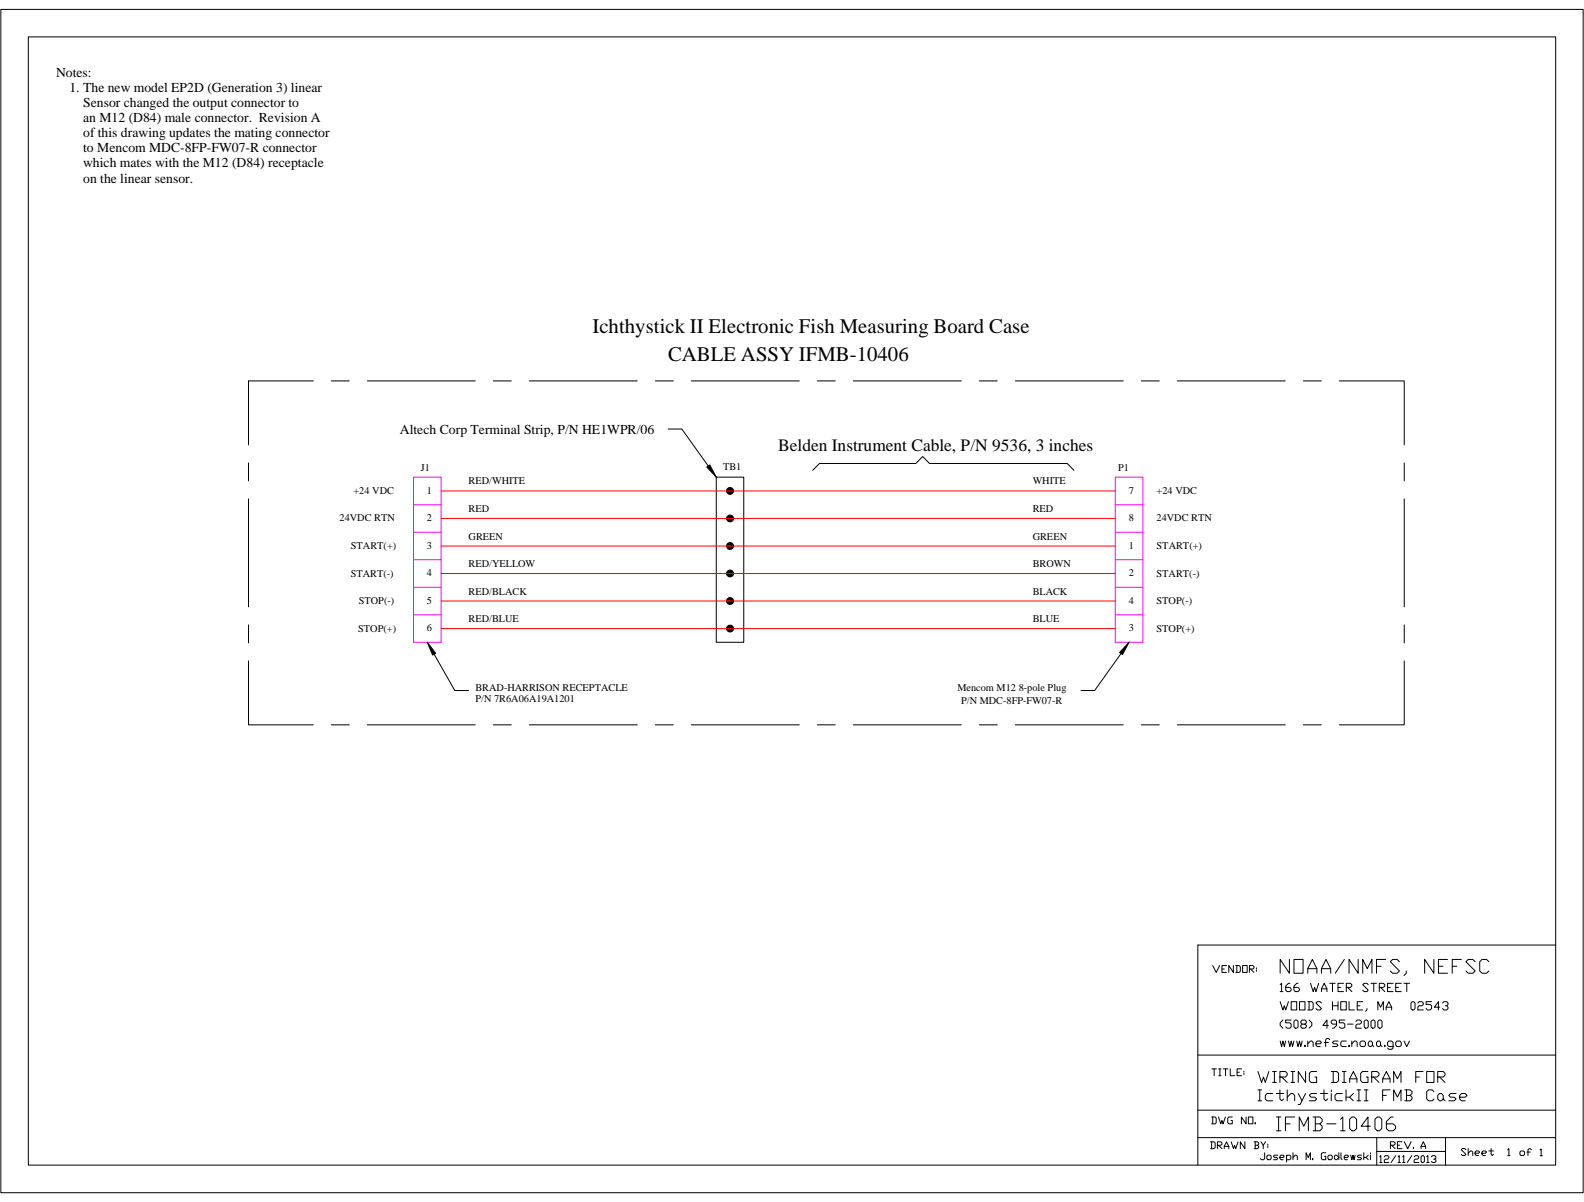
[picture p75: page 1]
RED/WHITE; RED; +24 VDC; 24VDC RTN; GREEN; RED/YELLOW; RED/BLACK; RED/BLUE; STOP(-); STOP(+); START(-); START(+); WHITE; BROWN; BLACK; BLUE

Notes:
1. The new model EP2D (Generation 3) linear
Sensor changed the output connector to
an M12 (D84) male connector. Revision A
of this drawing updates the mating connector
to Mencom MDC-8FP-FW07-R connector
which mates with the M12 (D84) receptacle
on the linear sensor.

Ichthystick II Electronic Fish Measuring Board Case

CABLE ASSY IFMB-10406

Altech Corp Terminal Strip, P/N HE1WPR/06

Belden Instrument Cable, P/N 9536, 3 inches

BRAD-HARRISON RECEPTACLE

Mencom M12 8-pole Plug
P/N MDC-8FP-FW07-R
