NEFSC/PEMAD-ESB-IchthystickII/Schematics/DisplayDesign_files/CableAssy_IFMB-10407.pdf

D

D

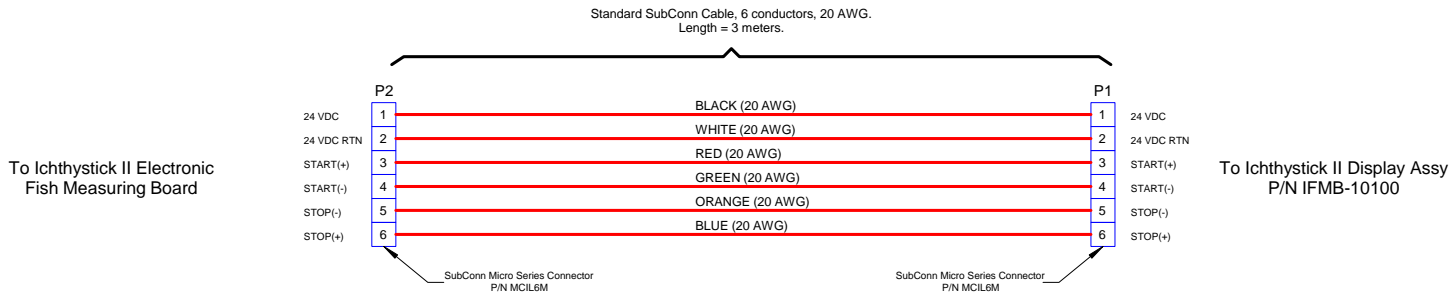
[picture p76: page 1]
SIZE; CAGE CODE; DWG NO; REV; IFMB-10407; Length = 3 meters.; BLACK (20 AWG); WHITE (20 AWG); RED (20 AWG); GREEN (20 AWG); ORANGE (20 AWG); BLUE (20 AWG); 24 VDC; 24 VDC RTN; START(+); START(-); STOP(-); STOP(+); P/N MCIL6M

Standard SubConn Cable, 6 conductors, 20 AWG.

To Ichthystick II Electronic
Fish Measuring Board

To Ichthystick II Display Assy
P/N IFMB-10100

SubConn Micro Series Connector

NOAA/NMFS, Northeast Fisheries Science Center

166 Water Street
Woods Hole, MA 02543

TITLE
Ichthystick II Electronic Fish Measuring Board
Downrigger Control Cable Wiring Diagram

SCALE N/A | SHEET 1 of 1
