NEFSC/PEMAD-ESB-IchthystickII/Schematics/DisplayDesign_files/display_adapter_plate.pdf

1

2

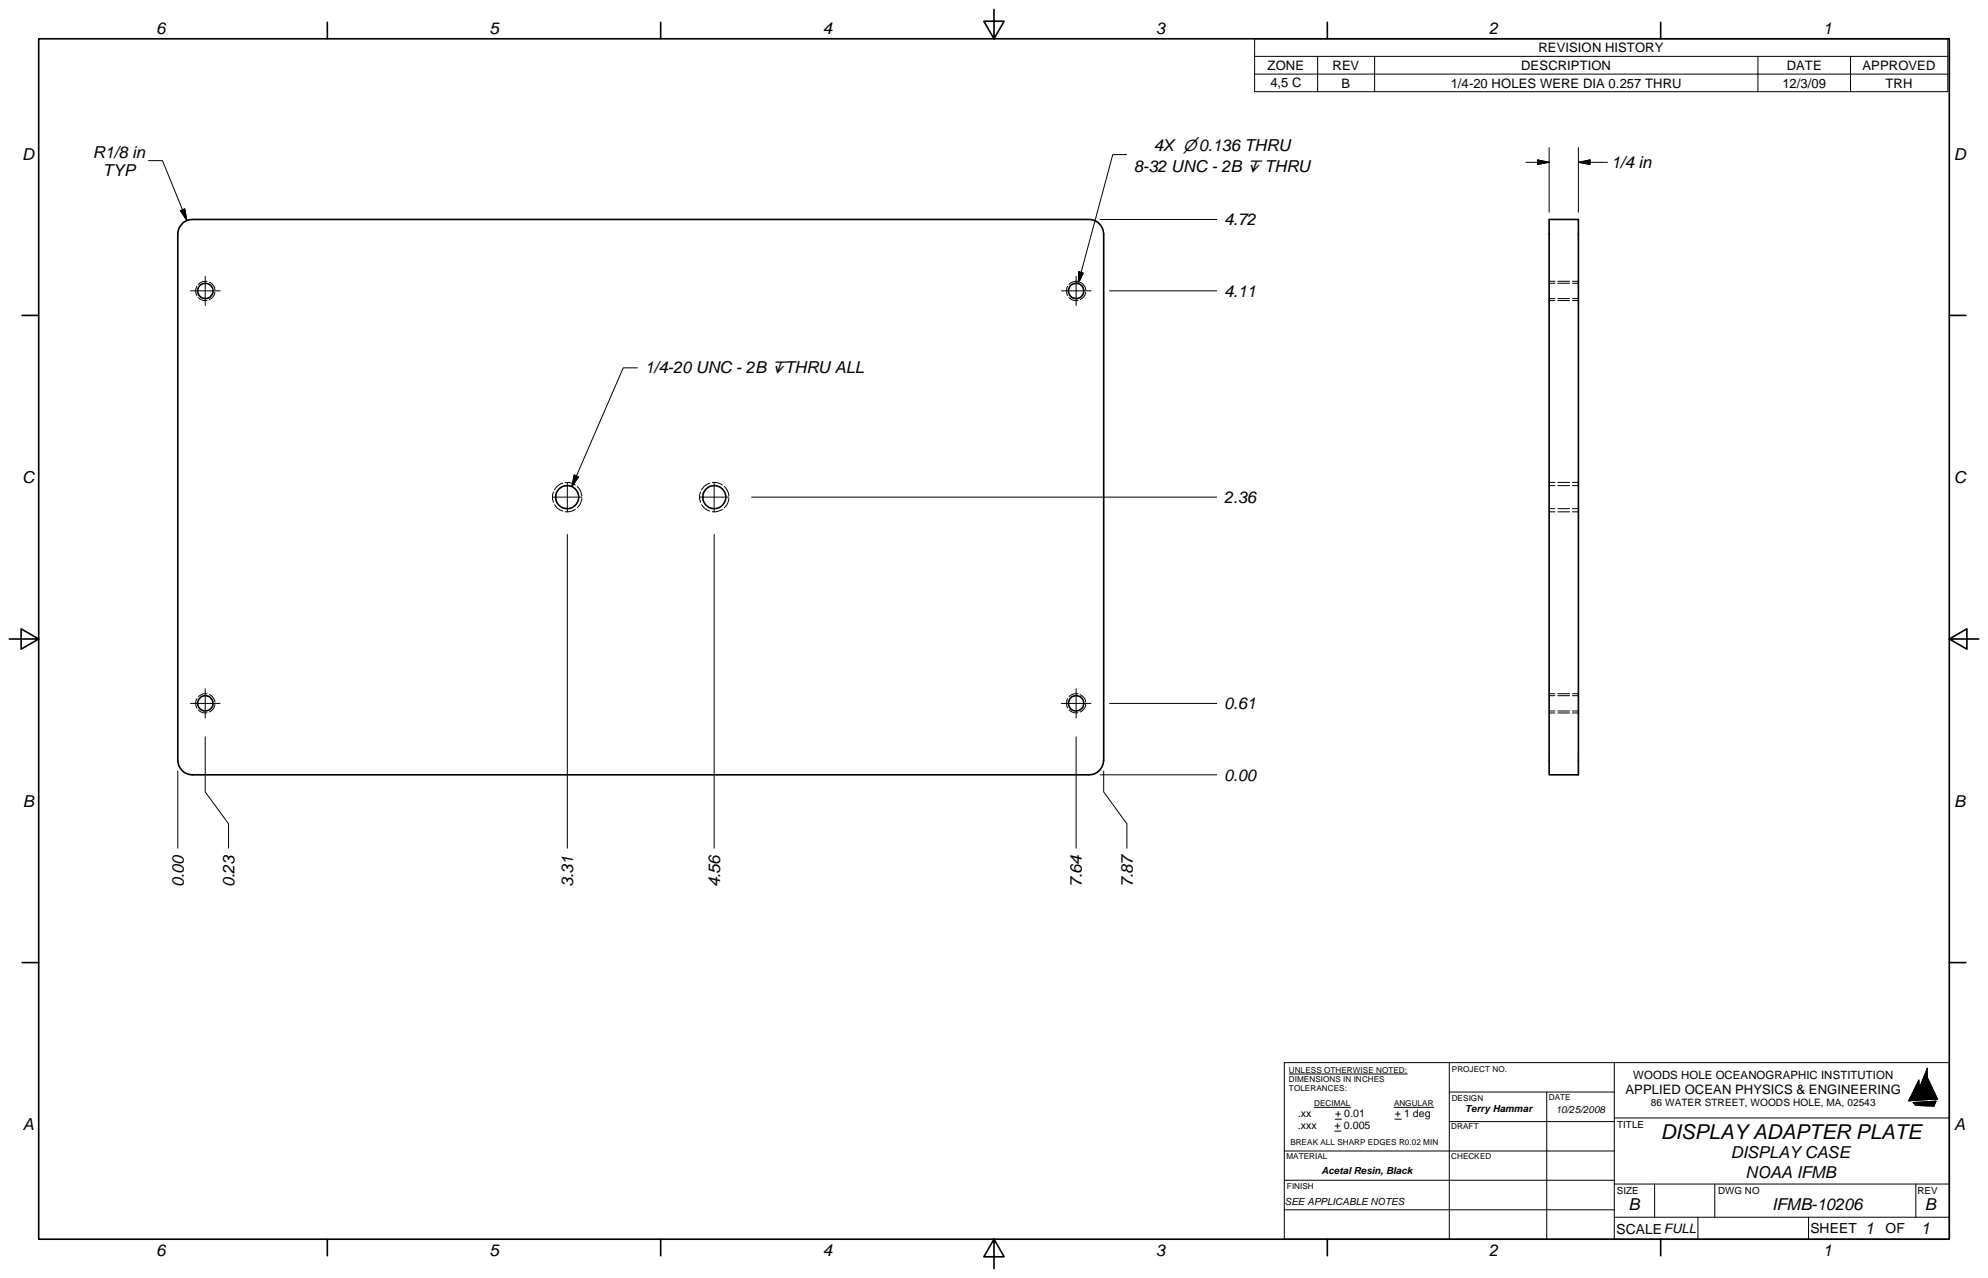
[picture p77: page 1]
SIZE; DWG NO; REV; SCALE; SHEET; CHECKED; DRAFT; TITLE; DECIMAL; ANGULAR; + 1 deg; .xxx; IFMB-10206; Acetal Resin, Black; NOAA IFMB; DISPLAY CASE; FULL; 4X 0.136 THRU 8-32 UNC - 2B THRU; REVISION HISTORY

ZONE | REV | DESCRIPTION | DATE | APPROVED
4,5 C | B | 1/4-20 HOLES WERE DIA 0.257 THRU | 12/3/09 | TRH

1/4 in R1/8 in TYP

1/4-20 UNC - 2B THRU ALL

UNLESS OTHERWISE NOTED:
DIMENSIONS IN INCHES
TOLERANCES:

PROJECT NO. | WOODS HOLE OCEANOGRAPHIC INSTITUTION APPLIED OCEAN PHYSICS & ENGINEERING

DESIGN Terry Hammar | 10/25/2008 | 86 WATER STREET, WOODS HOLE, MA, 02543 DATE

DISPLAY ADAPTER PLATE

BREAK ALL SHARP EDGES R0.02 MIN
MATERIAL

FINISH
SEE APPLICABLE NOTES
