NEFSC/PEMAD-ESB-IchthystickII/Schematics/DisplayDesign_files/display_base.pdf

1

2

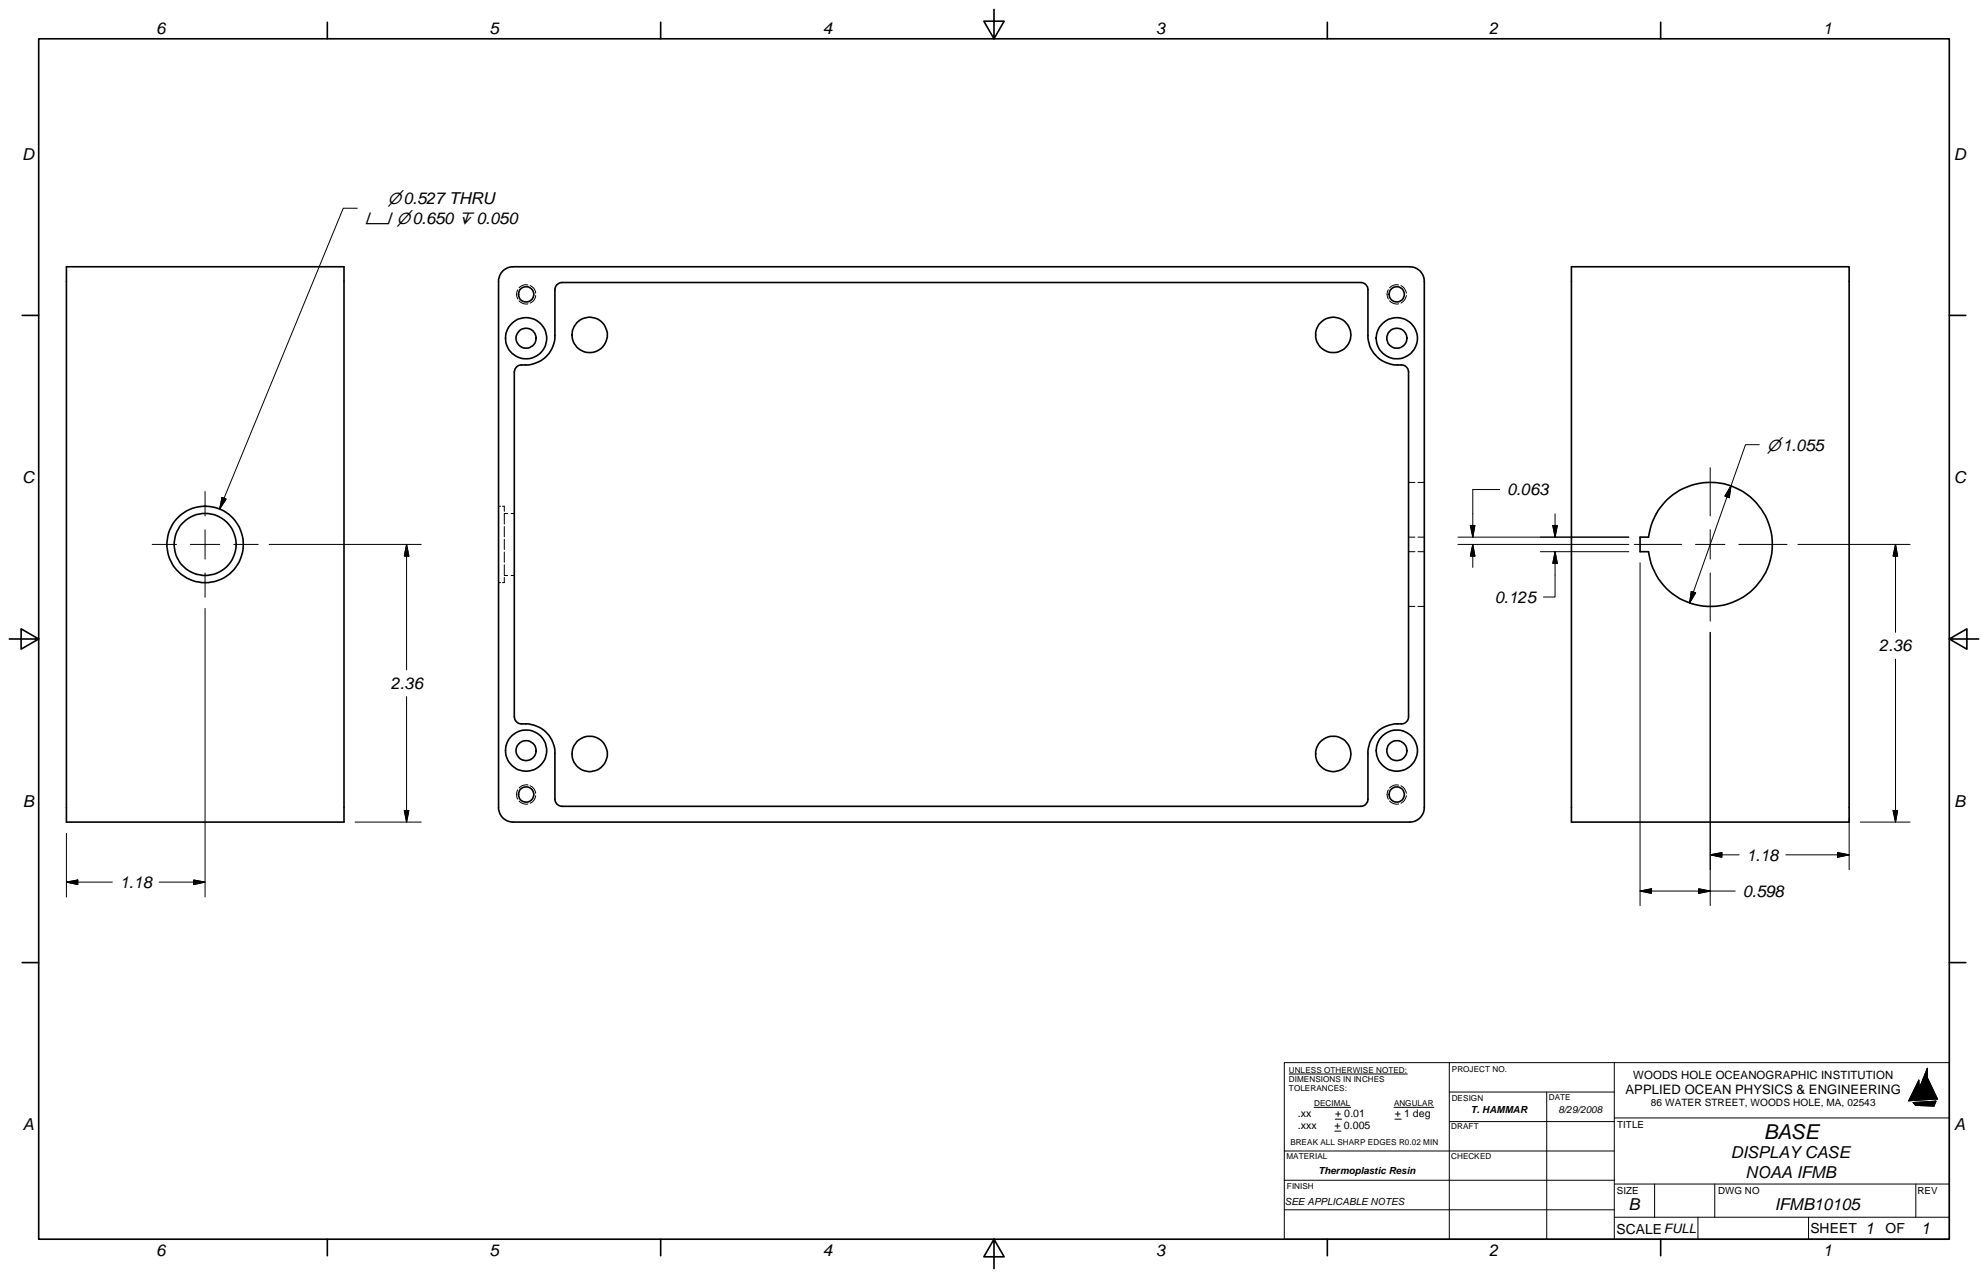
[picture p78: page 1]
SIZE; DWG NO; REV; SCALE; SHEET; CHECKED; DRAFT; TITLE; DECIMAL; ANGULAR; + 1 deg; .xxx; BASE; IFMB10105; Thermoplastic Resin; NOAA IFMB; DISPLAY CASE; FULL; 0.527 THRU 0.650 0.050

UNLESS OTHERWISE NOTED:
DIMENSIONS IN INCHES
TOLERANCES:

PROJECT NO. | WOODS HOLE OCEANOGRAPHIC INSTITUTION APPLIED OCEAN PHYSICS & ENGINEERING

DESIGN T. HAMMAR | 8/29/2008 | 86 WATER STREET, WOODS HOLE, MA, 02543 DATE

BREAK ALL SHARP EDGES R0.02 MIN
MATERIAL

FINISH
SEE APPLICABLE NOTES
