NEFSC/PEMAD-ESB-IchthystickII/Schematics/DisplayDesign_files/display_cover.pdf

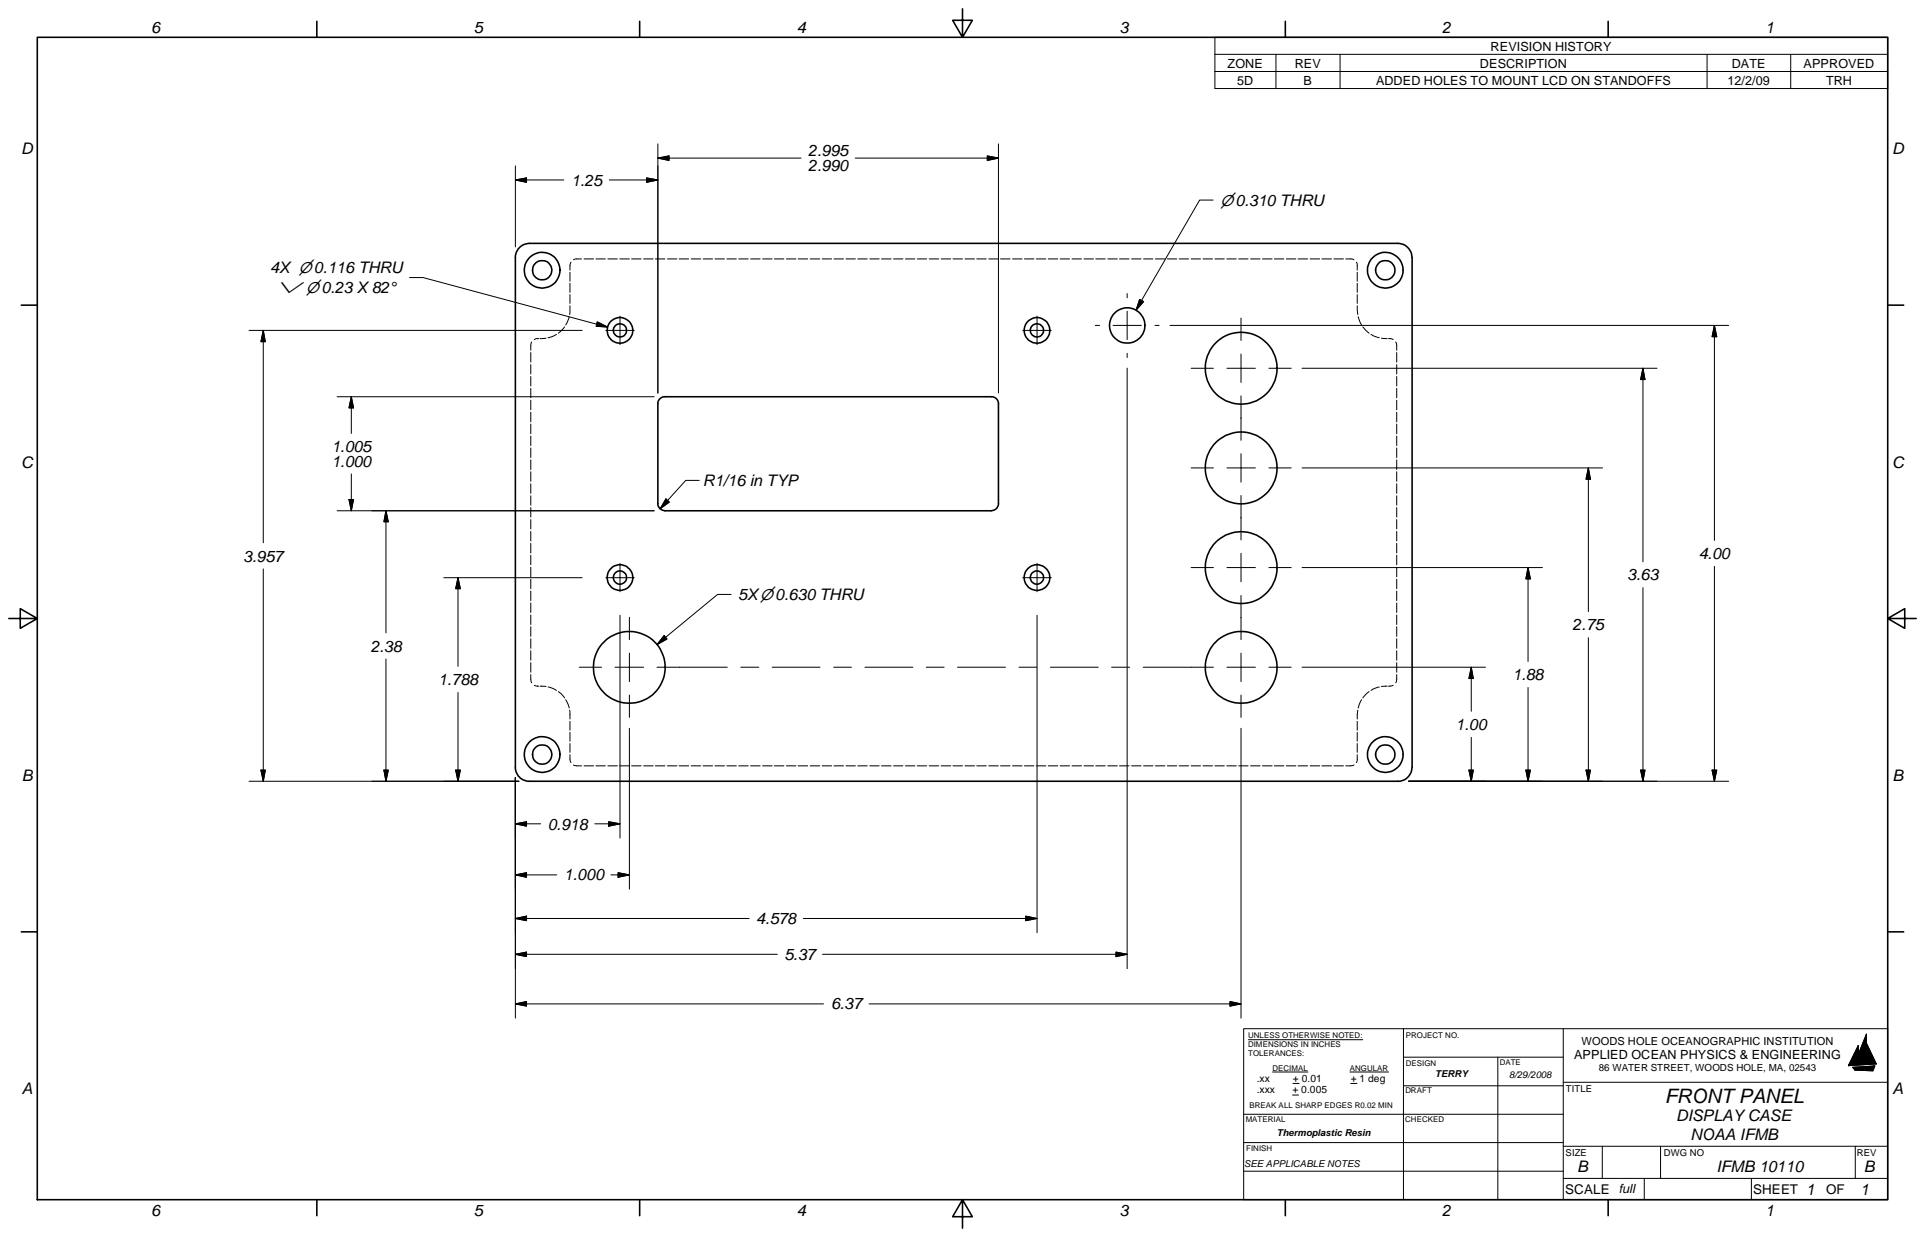
[picture p80: page 1]
DECIMAL; ANGULAR; + 1 deg; .xxx; Thermoplastic Resin; NOAA IFMB; R1/16 in TYP; 5X 0.630 THRU; 0.310 THRU; 4X 0.116 THRU 0.23 X 82°; REVISION HISTORY

ZONE | REV | DESCRIPTION | DATE | APPROVED
5D | B | ADDED HOLES TO MOUNT LCD ON STANDOFFS | 12/2/09 | TRH

UNLESS OTHERWISE NOTED:
DIMENSIONS IN INCHES
TOLERANCES:

PROJECT NO. | WOODS HOLE OCEANOGRAPHIC INSTITUTION APPLIED OCEAN PHYSICS & ENGINEERING

DESIGN TERRY | 8/29/2008 | 86 WATER STREET, WOODS HOLE, MA, 02543 DATE

DRAFT | | TITLE FRONT PANEL DISPLAY CASE

BREAK ALL SHARP EDGES R0.02 MIN
MATERIAL

CHECKED

FINISH
SEE APPLICABLE NOTES

SIZE B | | DWG NO IFMB 10110 | REV B

SCALE full | | SHEET 1 OF 1
