NEFSC/PEMAD-ESB-IchthystickII/Schematics/DisplayDesign_files/LCD_LENS.pdf

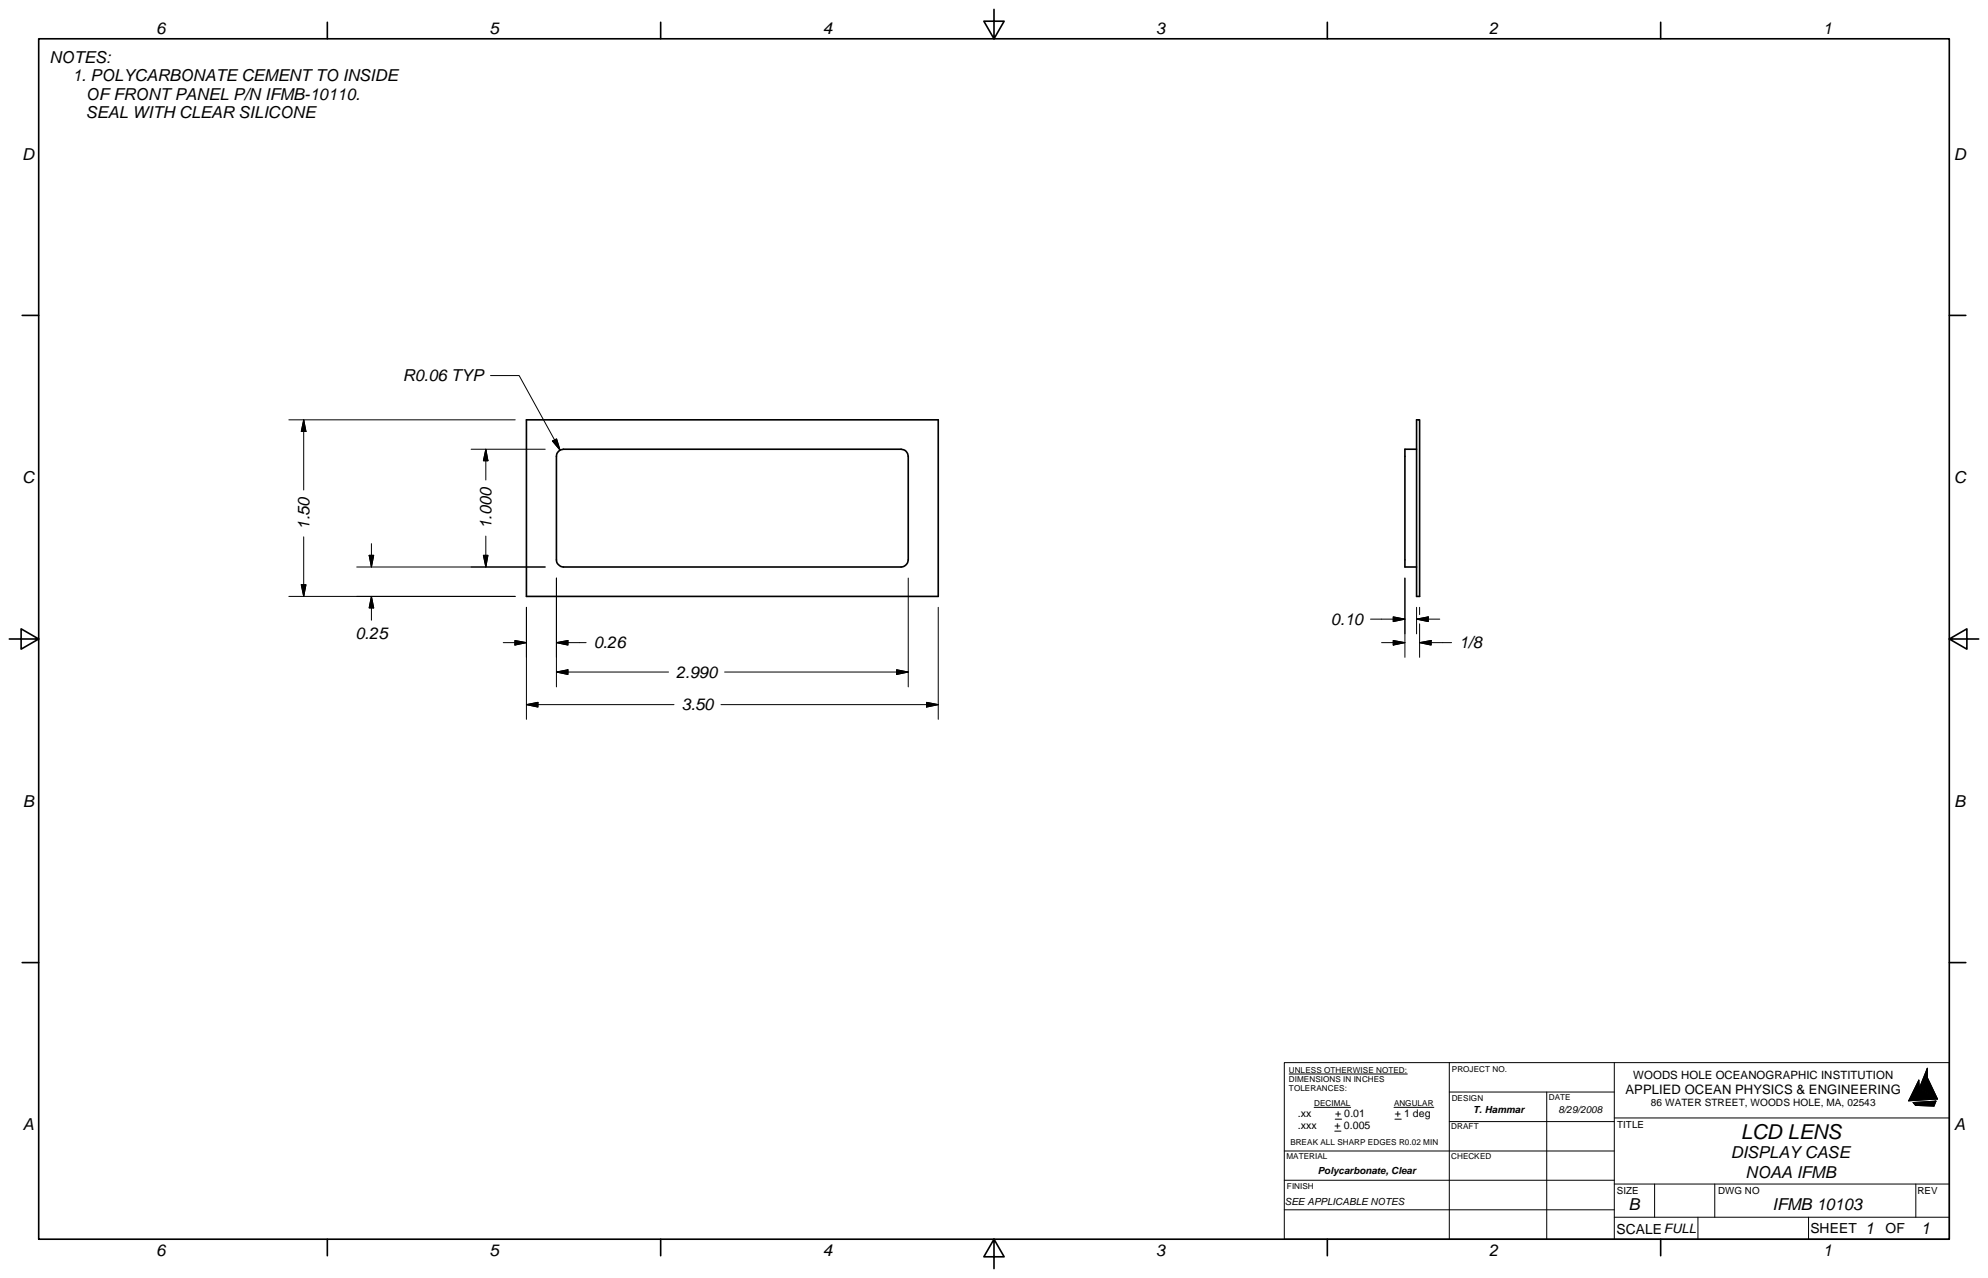
[picture p81: page 1]
SIZE; DWG NO; REV; SCALE; SHEET; CHECKED; DRAFT; TITLE; DECIMAL; ANGULAR; + 1 deg; .xxx; LCD LENS; IFMB 10103; Polycarbonate, Clear; NOAA IFMB; DISPLAY CASE; FULL; R0.06 TYP

NOTES:
1. POLYCARBONATE CEMENT TO INSIDE
OF FRONT PANEL P/N IFMB-10110.
SEAL WITH CLEAR SILICONE

UNLESS OTHERWISE NOTED:
DIMENSIONS IN INCHES
TOLERANCES:

PROJECT NO. | WOODS HOLE OCEANOGRAPHIC INSTITUTION APPLIED OCEAN PHYSICS & ENGINEERING

DESIGN T. Hammar | 8/29/2008 | 86 WATER STREET, WOODS HOLE, MA, 02543 DATE

BREAK ALL SHARP EDGES R0.02 MIN
MATERIAL

FINISH
SEE APPLICABLE NOTES
