NEFSC/PEMAD-ESB-IchthystickII/Schematics/DisplayDesign_files/NEFSC_FMB_RevE.pdf

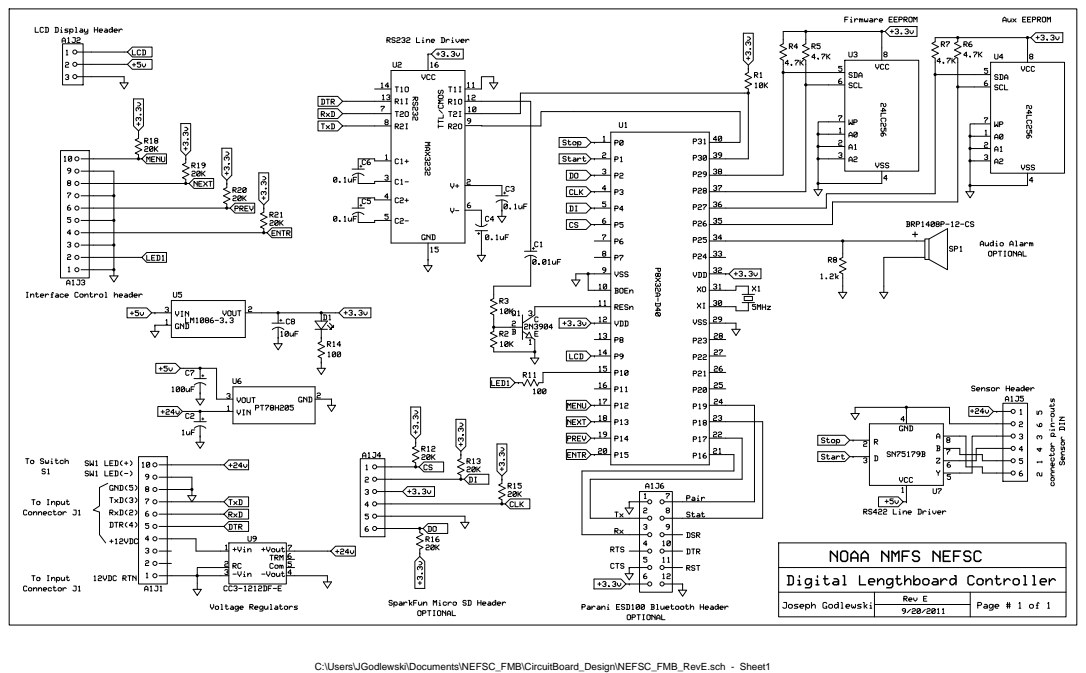
[picture p82: page 1]

C:\Users\JGodlewski\Documents\NEFSC_FMB\CircuitBoard_Design\NEFSC_FMB_RevE.sch - Sheet1
