NEFSC/PEMAD-ESB-IchthystickII/Documentation/WorkingDrafts/ManufacturingManual/Appendix 3.1.1 Fishboard_Case_withSensor.pdf

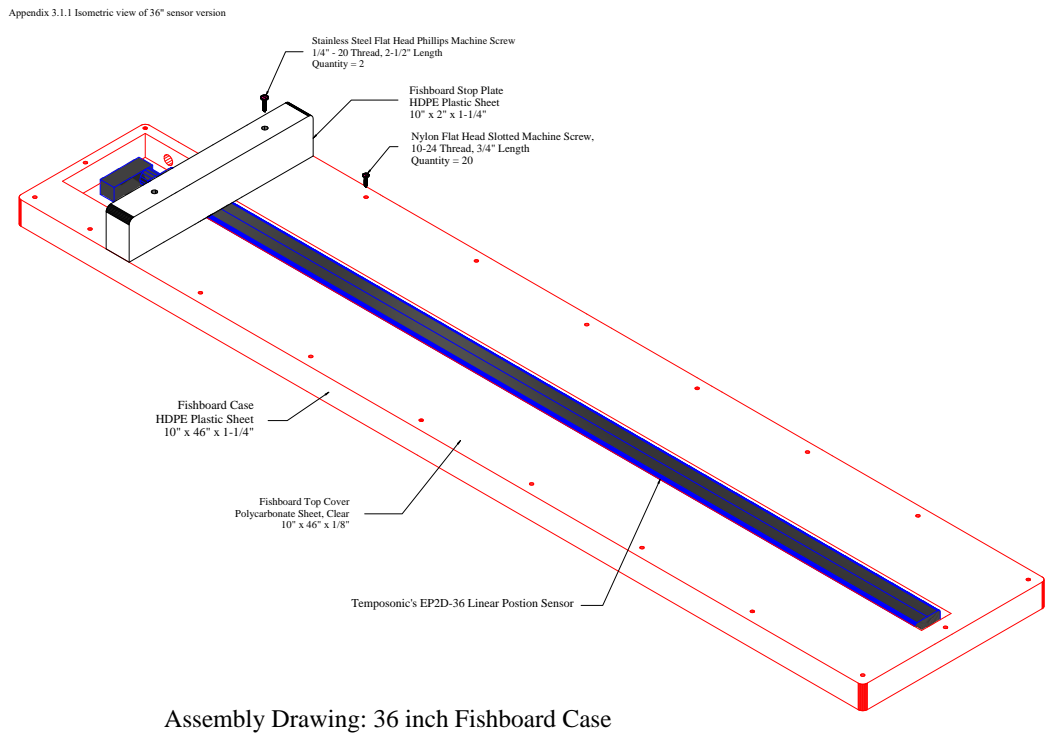
[picture p83: page 1]

Appendix 3.1.1 Isometric view of 36" sensor version

Stainless Steel Flat Head Phillips Machine Screw
1/4" - 20 Thread, 2-1/2" Length
Quantity = 2

Fishboard Stop Plate
HDPE Plastic Sheet
Nylon Flat Head Slotted Machine Screw,
10-24 Thread, 3/4" Length
Quantity = 20

Fishboard Case

Fishboard Top Cover
Polycarbonate Sheet, Clear

Temposonic's EP2D-36 Linear Postion Sensor

Assembly Drawing: 36 inch Fishboard Case
