NEFSC/PEMAD-ESB-IchthystickII/Documentation/WorkingDrafts/ManufacturingManual/Appendix 3.1.2 FB001-000Assy-002Iso.pdf

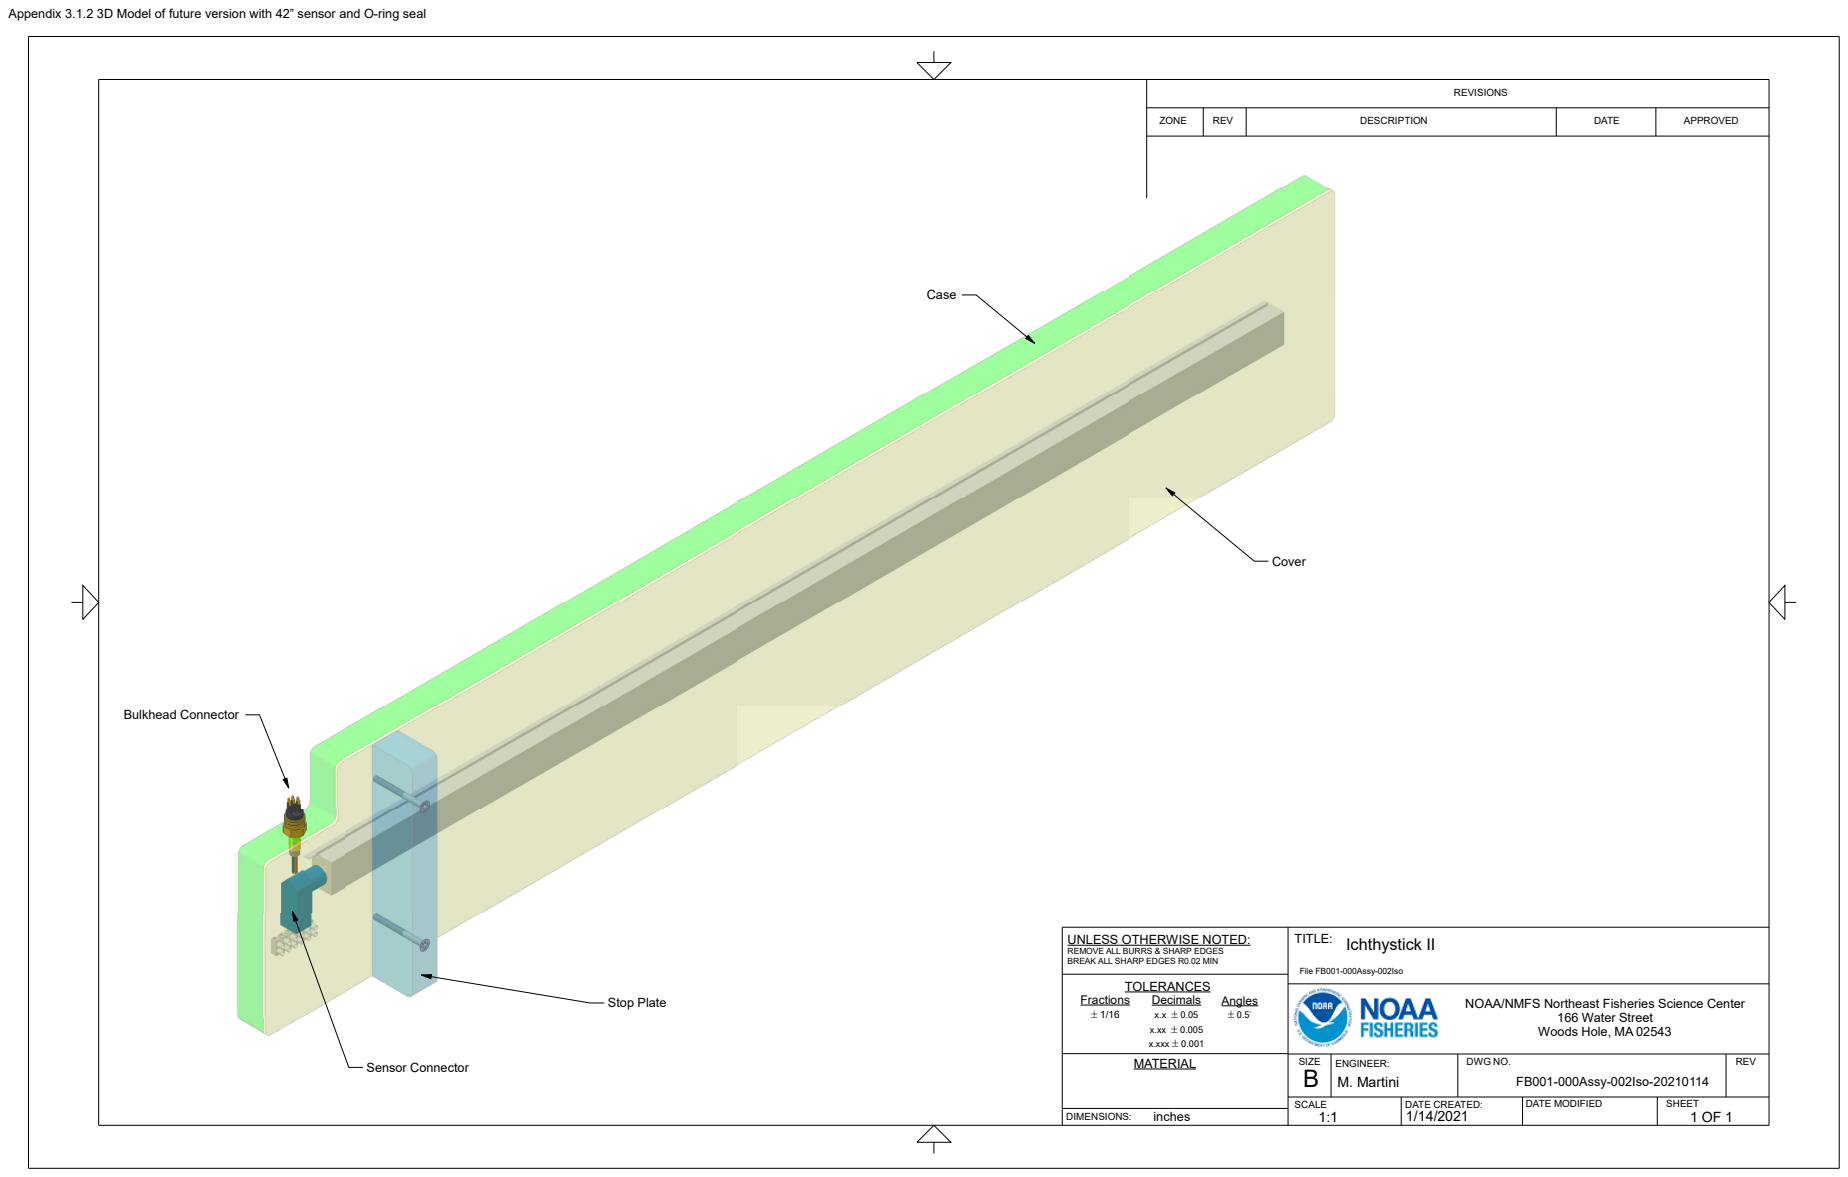
[picture p84: page 1]
Case; Cover; Stop Plate; Bulkhead Connector; Sensor Connector; Decimals x.x `0.05 x.xx `0.005 x.xxx `0.001; TOLERANCES; DIMENSIONS:; Fractions `1/16; File FB001-000Assy-002Iso; TITLE:; Angles `0.5_; inches; Ichthystick II

Appendix 3.1.2 3D Model of future version with 42” sensor and O-ring seal

REVISIONS

ZONE | REV | DESCRIPTION | DATE | APPROVED

UNLESS OTHERWISE NOTED:
REMOVE ALL BURRS & SHARP EDGES
BREAK ALL SHARP EDGES R0.02 MIN

NOAA/NMFS Northeast Fisheries Science Center

166 Water Street
Woods Hole, MA 02543

MATERIAL | SIZE | ENGINEER: M. Martini | DWG NO. FB001-000Assy-002Iso-20210114 | REV

SCALE 1:1 | DATE CREATED: 1/14/2021 | DATE MODIFIED | SHEET 1 OF 1
