NEFSC/PEMAD-ESB-IchthystickII/Documentation/WorkingDrafts/ManufacturingManual/Appendix 3.2.1 FB001-013Template-2021114.pdf

### Appendix 3.2.1 Template Drawing for 42" case

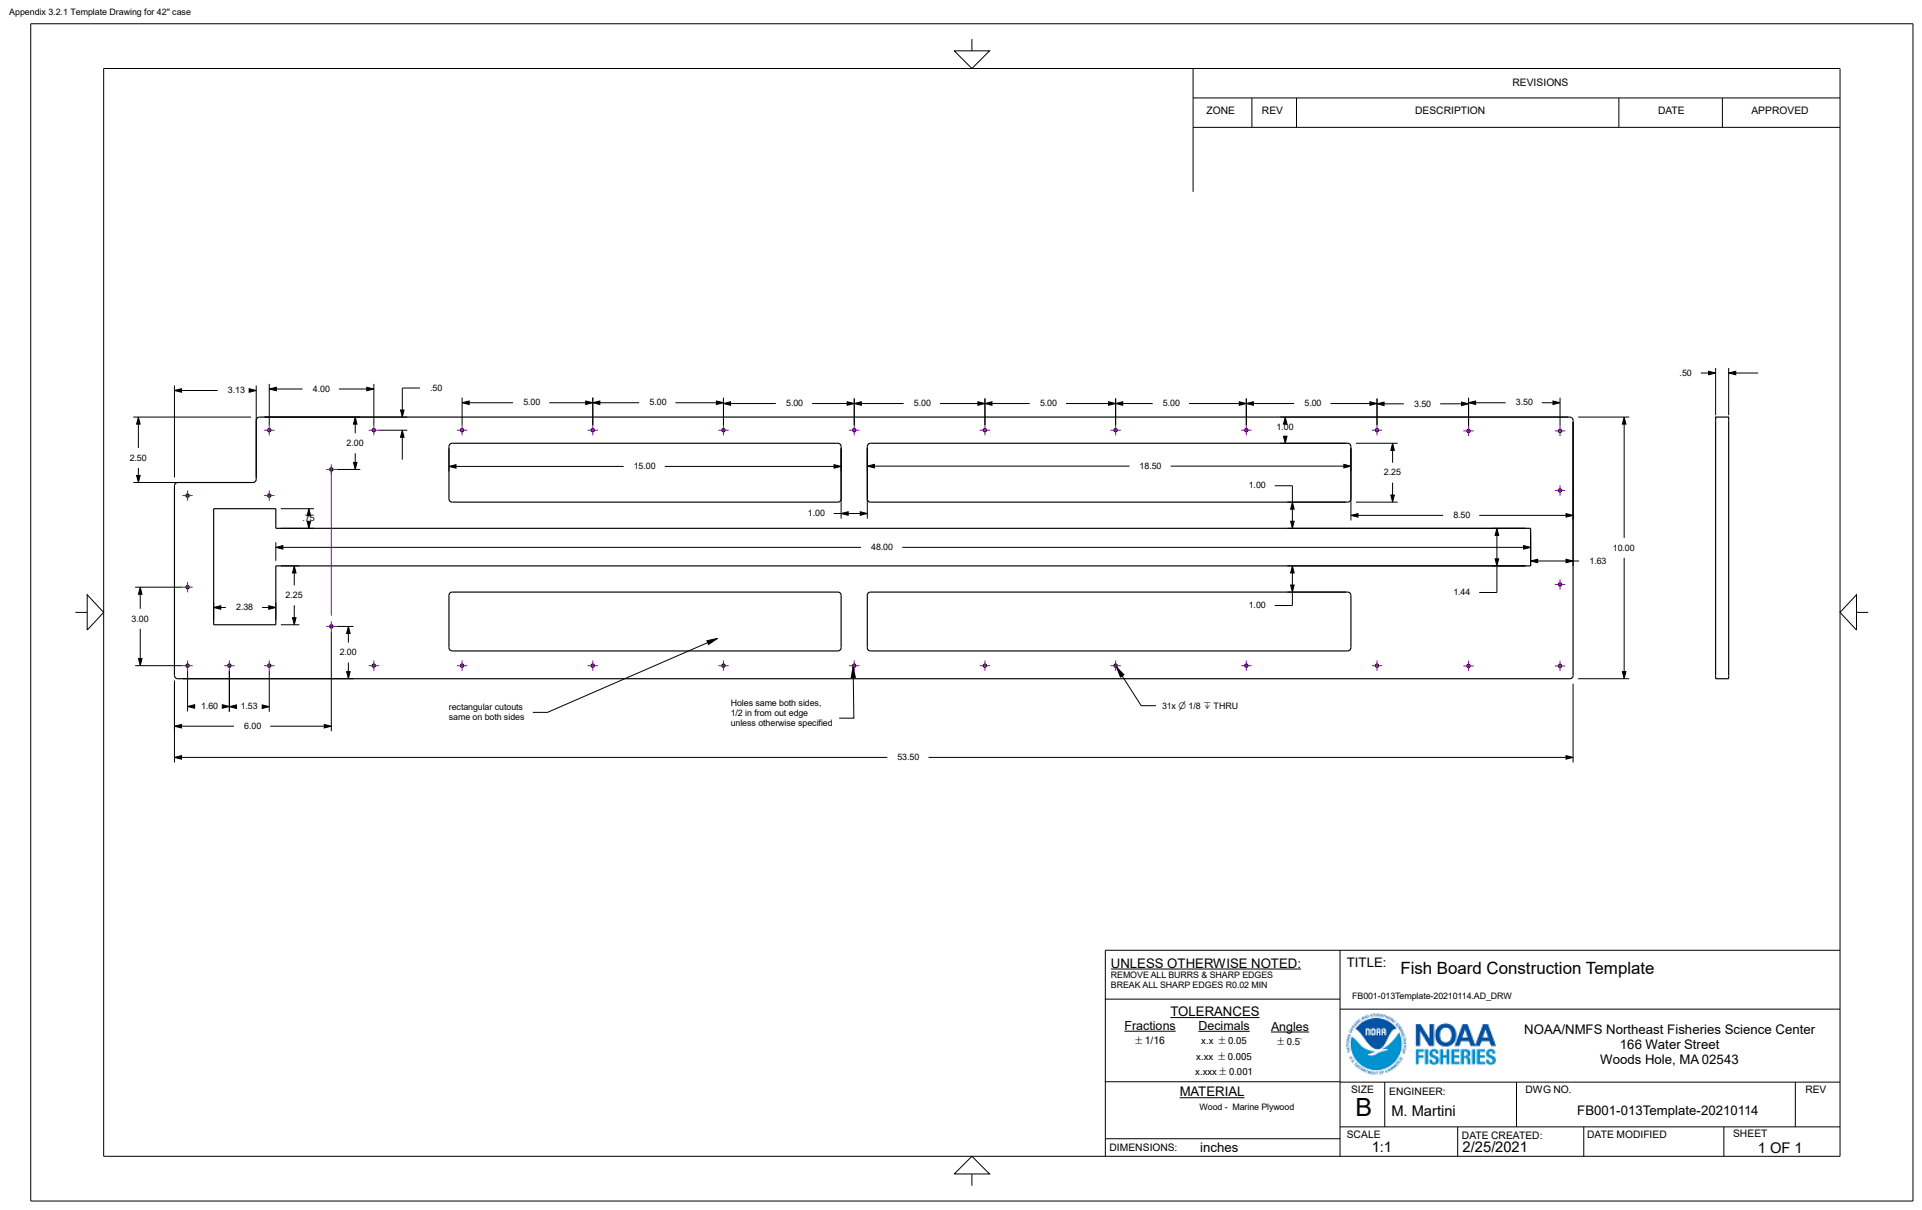
[picture p85: page 1]
rectangular cutouts; 31x n 1/8 x THRU; TOLERANCES Fractions `1/16; DIMENSIONS:; FB001-013Template-20210114.AD_DRW; Decimals x.x `0.05 x.xx `0.005 x.xxx `0.001; Angles `0.5_; inches

REVISIONS

ZONE | REV | DESCRIPTION | DATE | APPROVED

same on both sides

Holes same both sides,
1/2 in from out edge
unless otherwise specified

UNLESS OTHERWISE NOTED:
REMOVE ALL BURRS & SHARP EDGES
BREAK ALL SHARP EDGES R0.02 MIN

TITLE:
Fish Board Construction Template

NOAA/NMFS Northeast Fisheries Science Center

166 Water Street
Woods Hole, MA 02543

MATERIAL Wood - Marine Plywood | SIZE B | ENGINEER: M. Martini | DWG NO. FB001-013Template-20210114 | REV

SCALE 1:1 | DATE CREATED: 2/25/2021 | DATE MODIFIED | SHEET 1 OF 1
