NEFSC/PEMAD-ESB-IchthystickII/Documentation/WorkingDrafts/ManufacturingManual/Appendix 3.2.2 TemplateLayout.pdf

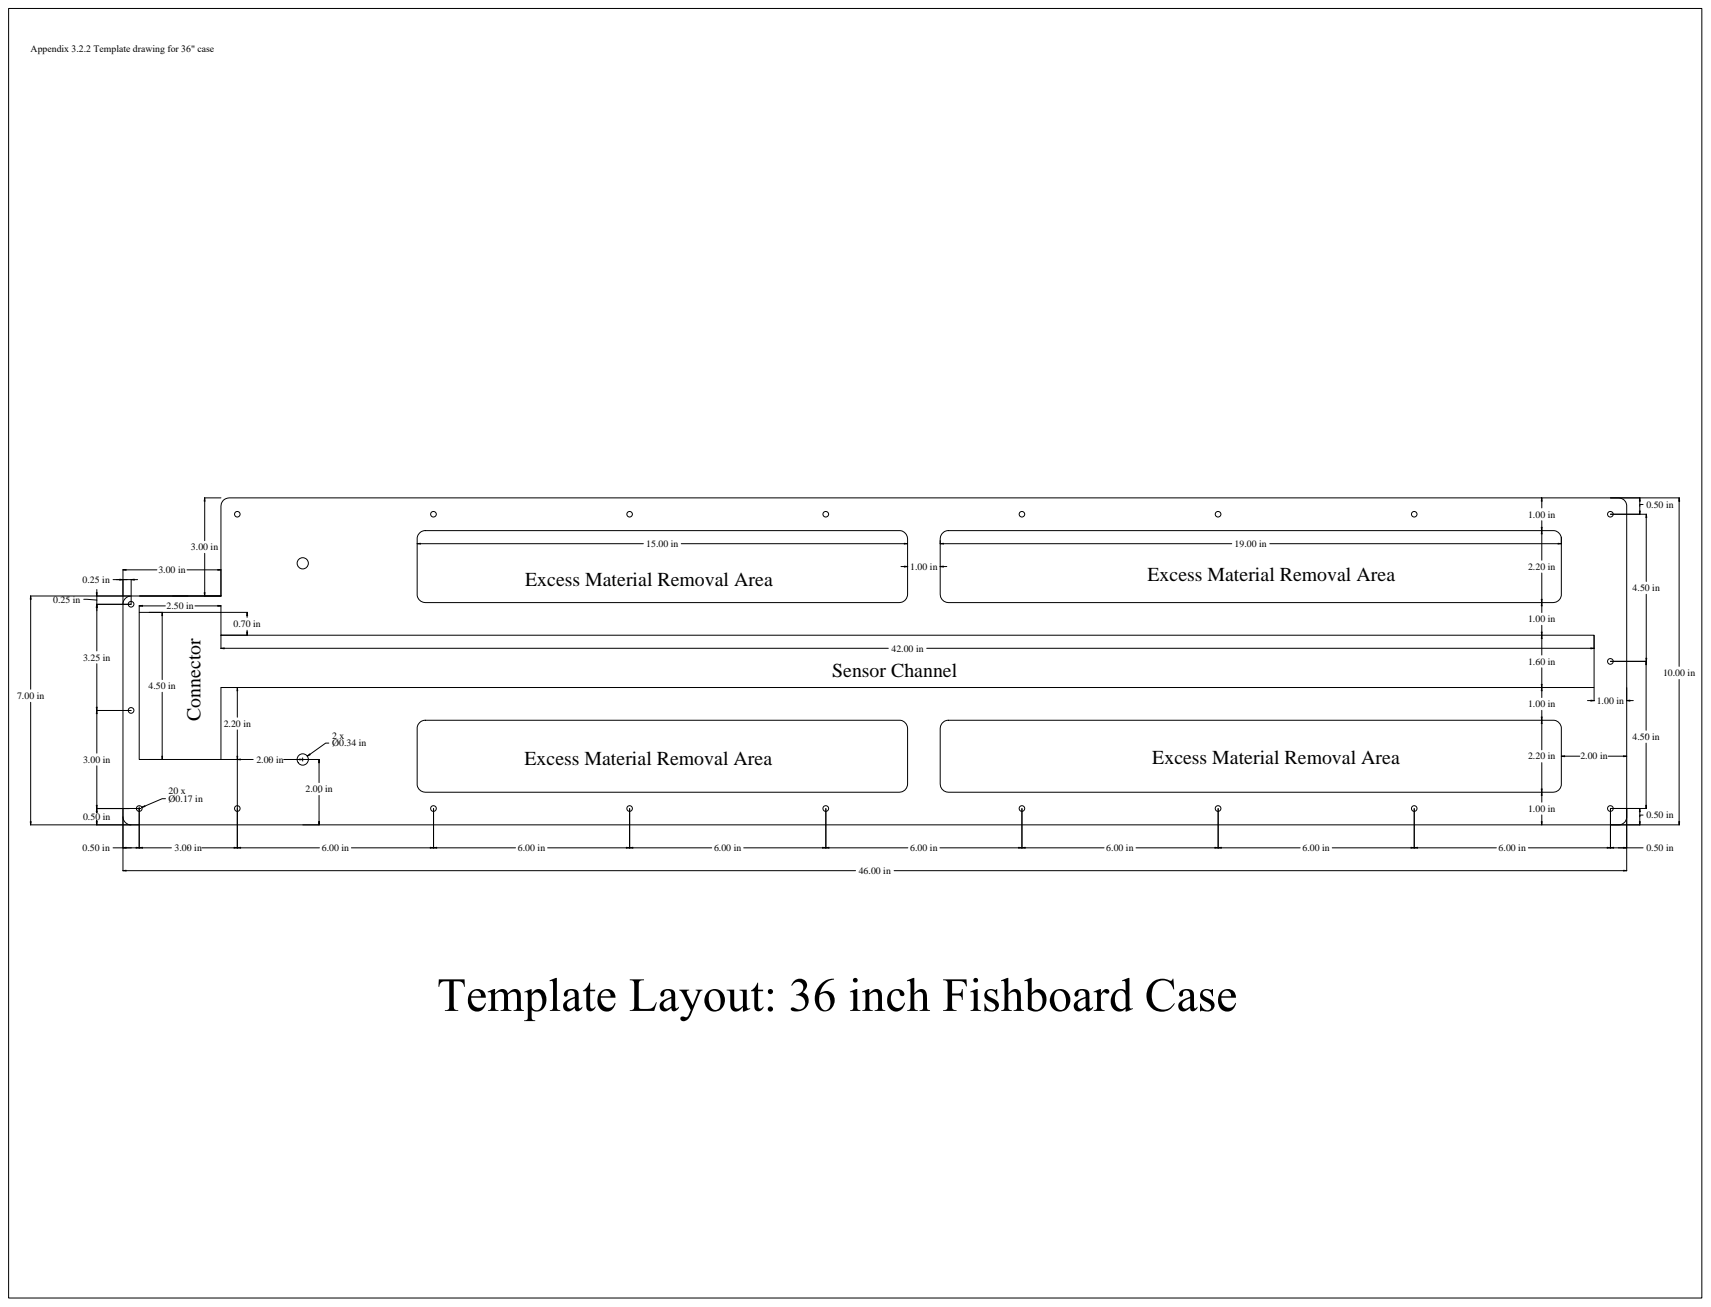
[picture p86: page 1]
Sensor Channel; Connector; Excess Material Removal Area

Appendix 3.2.2 Template drawing for 36" case

Excess Material Removal Area
