NEFSC/PEMAD-ESB-IchthystickII/Documentation/WorkingDrafts/ManufacturingManual/Appendix 3.2.3 FB001-012RoughCut-2021114.pdf

## Cut lines

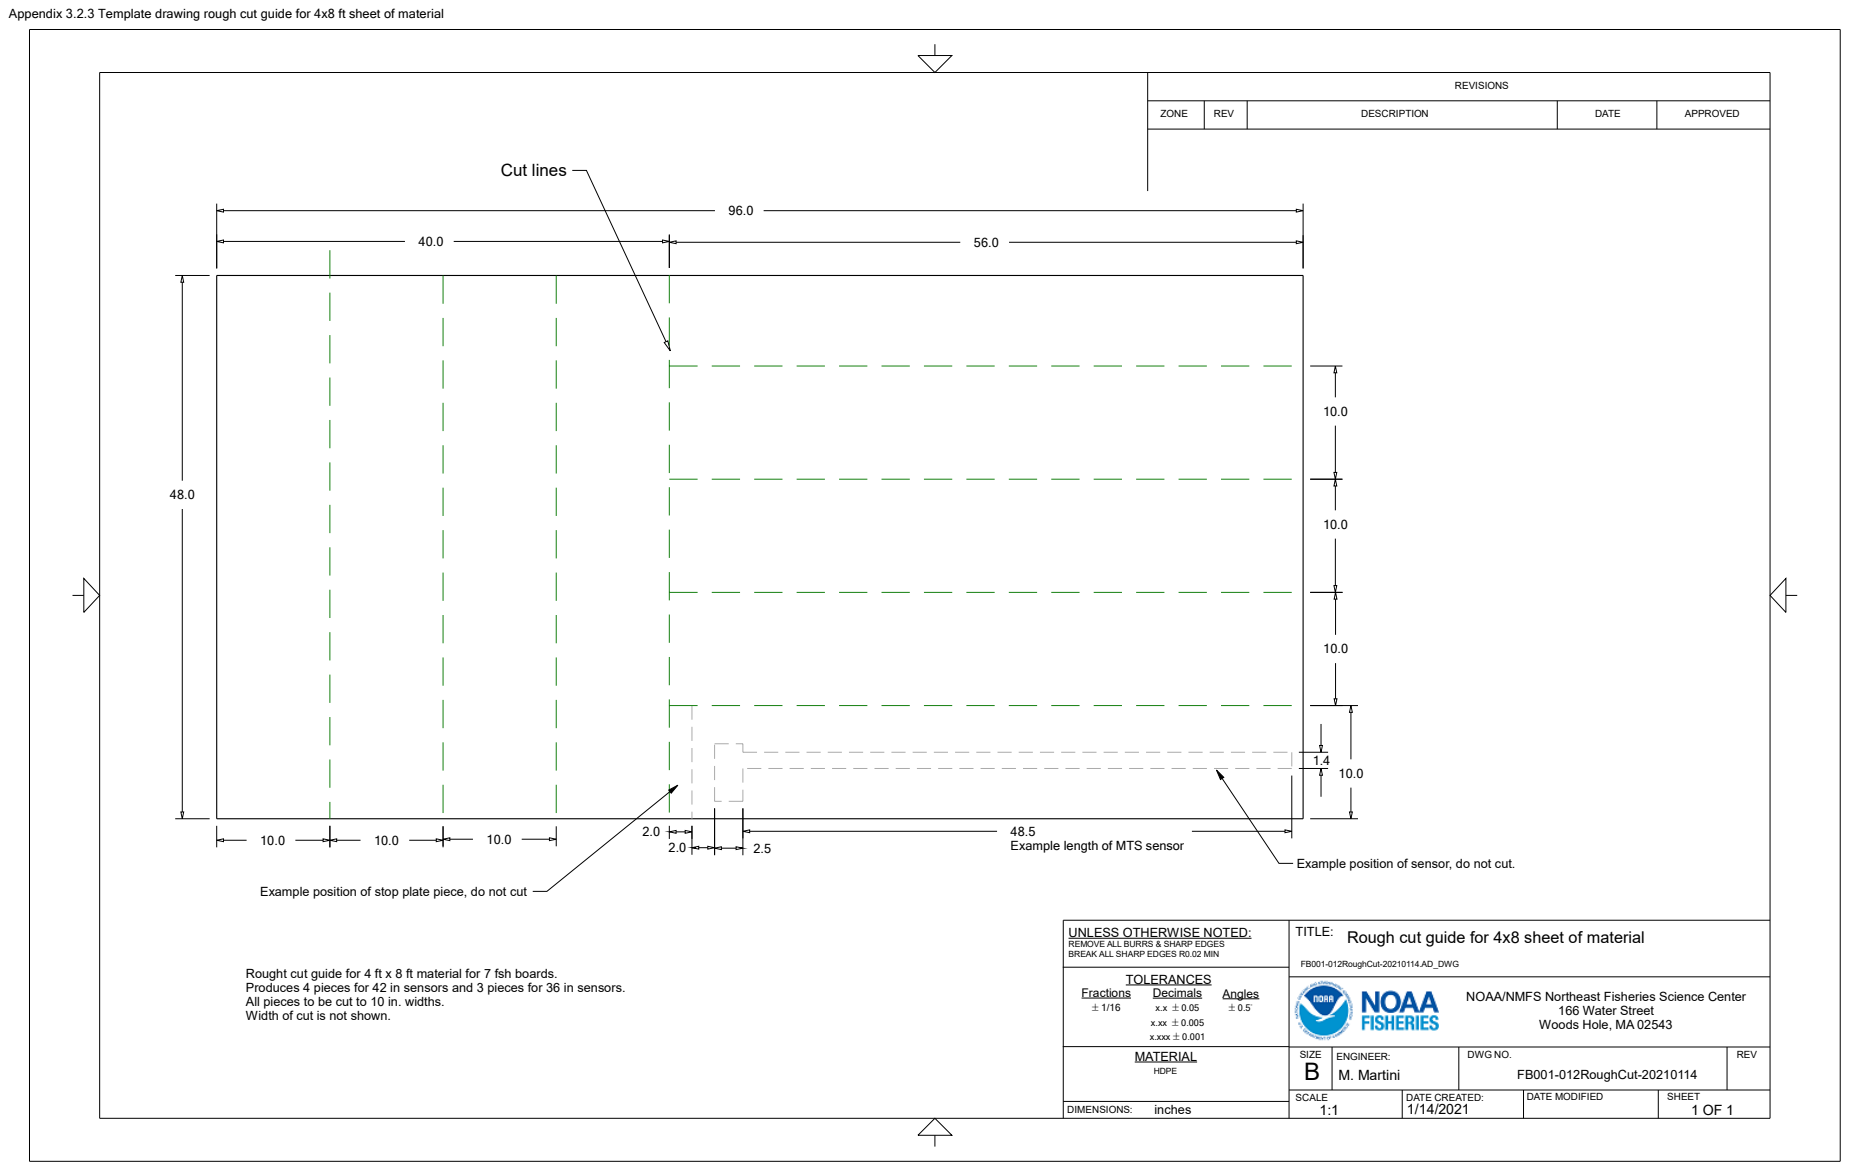
[picture p87: page 1]
Fractions `1/16; FB001-012RoughCut-20210114.AD_DWG; inches; Angles `0.5_; Decimals x.x `0.05 x.xx `0.005 x.xxx `0.001; DIMENSIONS:; TOLERANCES

Appendix 3.2.3 Template drawing rough cut guide for 4x8 ft sheet of material

REVISIONS

ZONE | REV | DESCRIPTION | DATE | APPROVED

Example length of MTS sensor

Example position of sensor, do not cut.

Example position of stop plate piece, do not cut

UNLESS OTHERWISE NOTED:
REMOVE ALL BURRS & SHARP EDGES
BREAK ALL SHARP EDGES R0.02 MIN

TITLE:
Rough cut guide for 4x8 sheet of material

Rought cut guide for 4 ft x 8 ft material for 7 fsh boards.
Produces 4 pieces for 42 in sensors and 3 pieces for 36 in sensors.
All pieces to be cut to 10 in. widths.
Width of cut is not shown.

NOAA/NMFS Northeast Fisheries Science Center

166 Water Street
Woods Hole, MA 02543

MATERIAL HDPE | SIZE B | ENGINEER: M. Martini | DWG NO. FB001-012RoughCut-20210114 | REV

SCALE 1:1 | DATE CREATED: 1/14/2021 | DATE MODIFIED | SHEET 1 OF 1
