NEFSC/PEMAD-ESB-IchthystickII/Documentation/WorkingDrafts/ManufacturingManual/Appendix 3.3.1 FB001-001Case-002-2021114.pdf

## Appendix 3.3.1 Detail of connector hole placement for Subconn MCBH

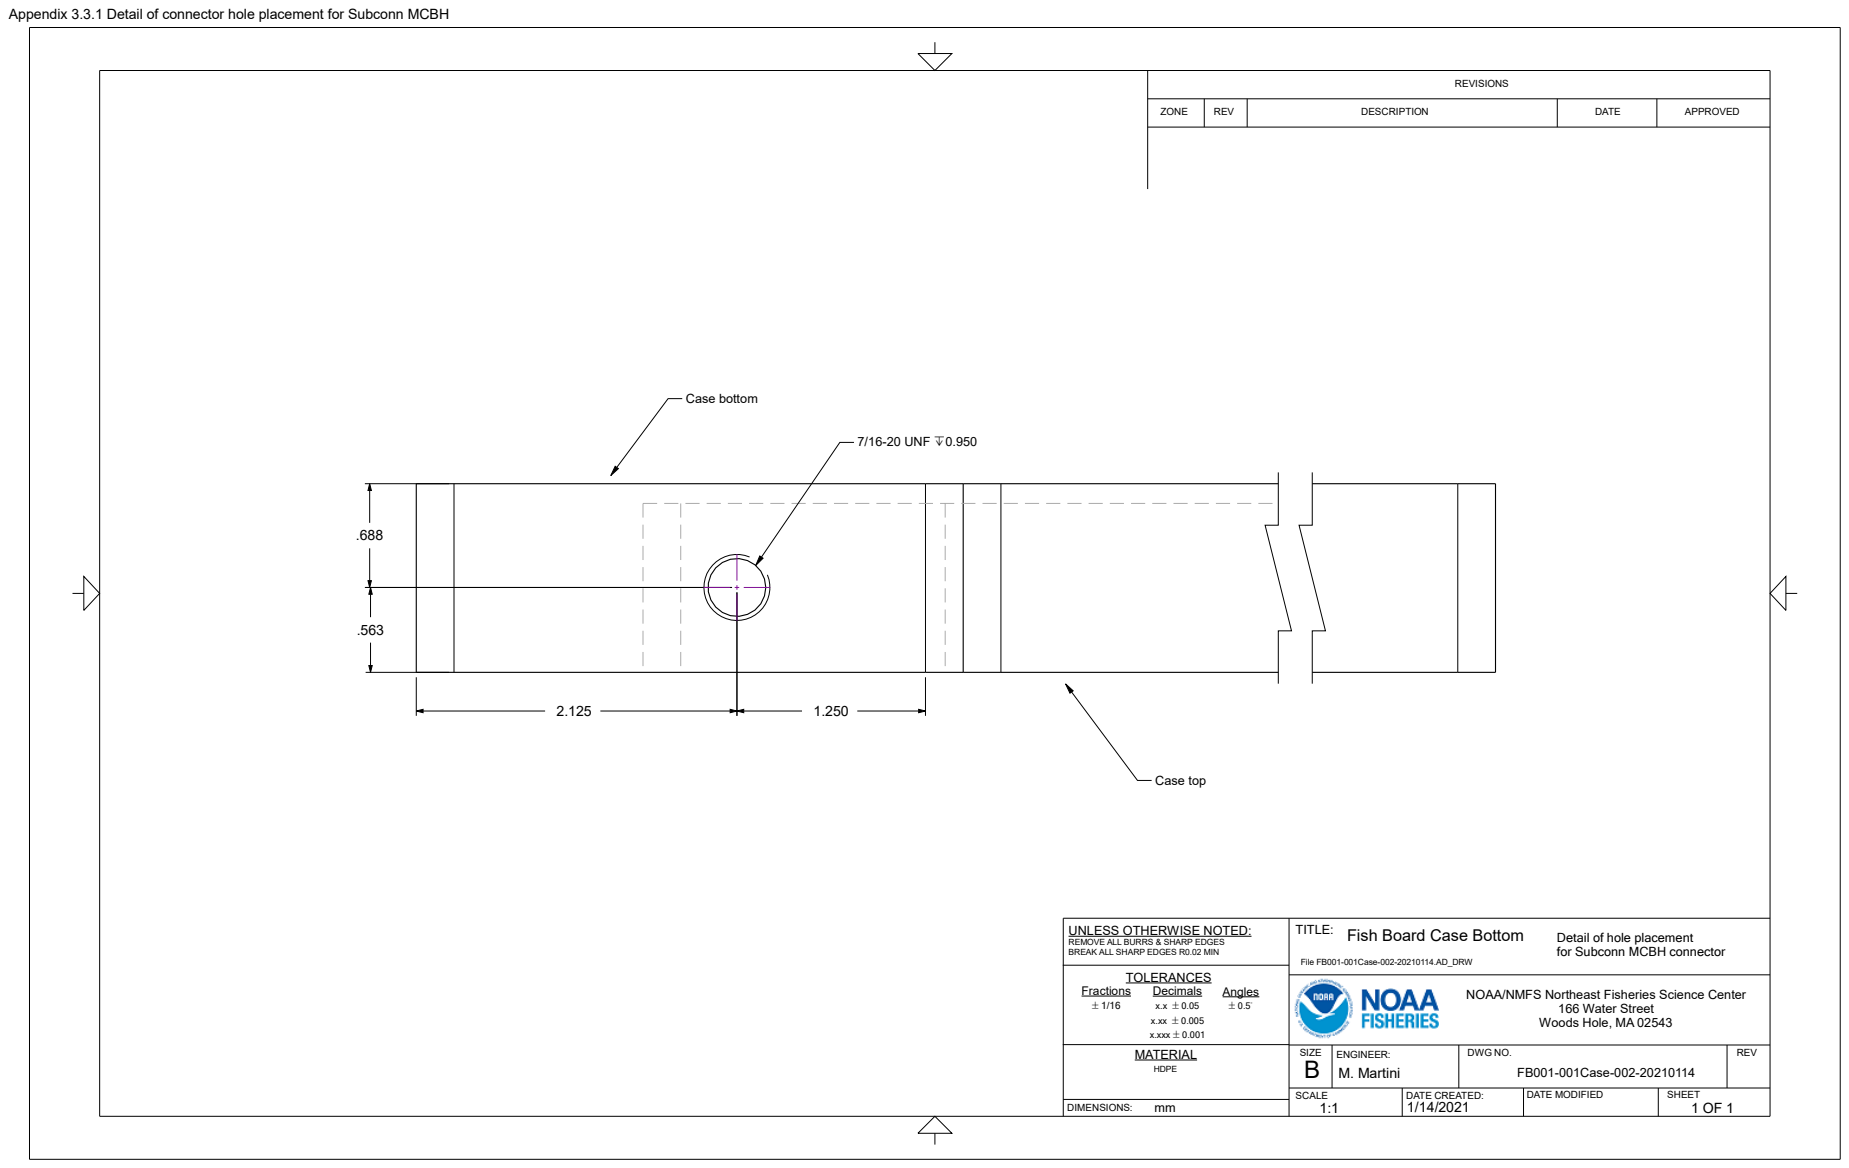
[picture p88: page 1]
7/16-20 UNF x0.950; Case bottom; Case top; TOLERANCES; DIMENSIONS:; Decimals x.x `0.05 x.xx `0.005 x.xxx `0.001; Fractions `1/16; Angles `0.5_; File FB001-001Case-002-20210114.AD_DRW

REVISIONS

ZONE | REV | DESCRIPTION | DATE | APPROVED

UNLESS OTHERWISE NOTED:
REMOVE ALL BURRS & SHARP EDGES
BREAK ALL SHARP EDGES R0.02 MIN

TITLE:
Fish Board Case Bottom

Detail of hole placement
for Subconn MCBH connector

NOAA/NMFS Northeast Fisheries Science Center

166 Water Street
Woods Hole, MA 02543

MATERIAL HDPE | SIZE B | ENGINEER: M. Martini | DWG NO. FB001-001Case-002-20210114 | REV

SCALE 1:1 | DATE CREATED: 1/14/2021 | DATE MODIFIED | SHEET 1 OF 1
