NEFSC/PEMAD-ESB-IchthystickII/Documentation/WorkingDrafts/ManufacturingManual/Appendix 3.3.2 Brad Harrison ConnectorHole.pdf

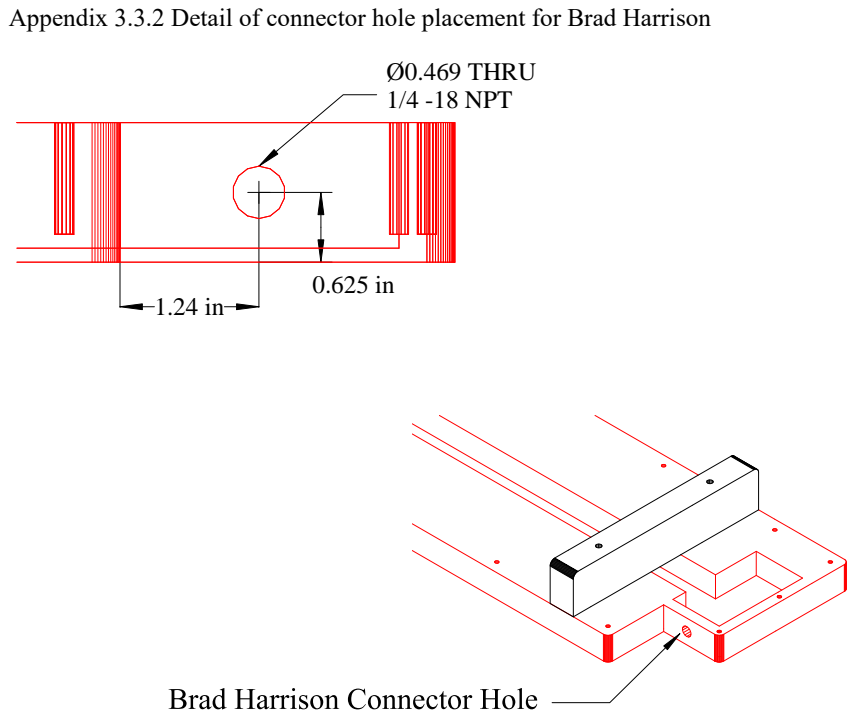
[picture p89: page 1]
Ø0.469 THRU 1/4 -18 NPT

Appendix 3.3.2 Detail of connector hole placement for Brad Harrison
