NEFSC/PEMAD-ESB-IchthystickII/Documentation/WorkingDrafts/ManufacturingManual/Appendix 3.4 FB001-000Assy-001Stop-20210114.pdf

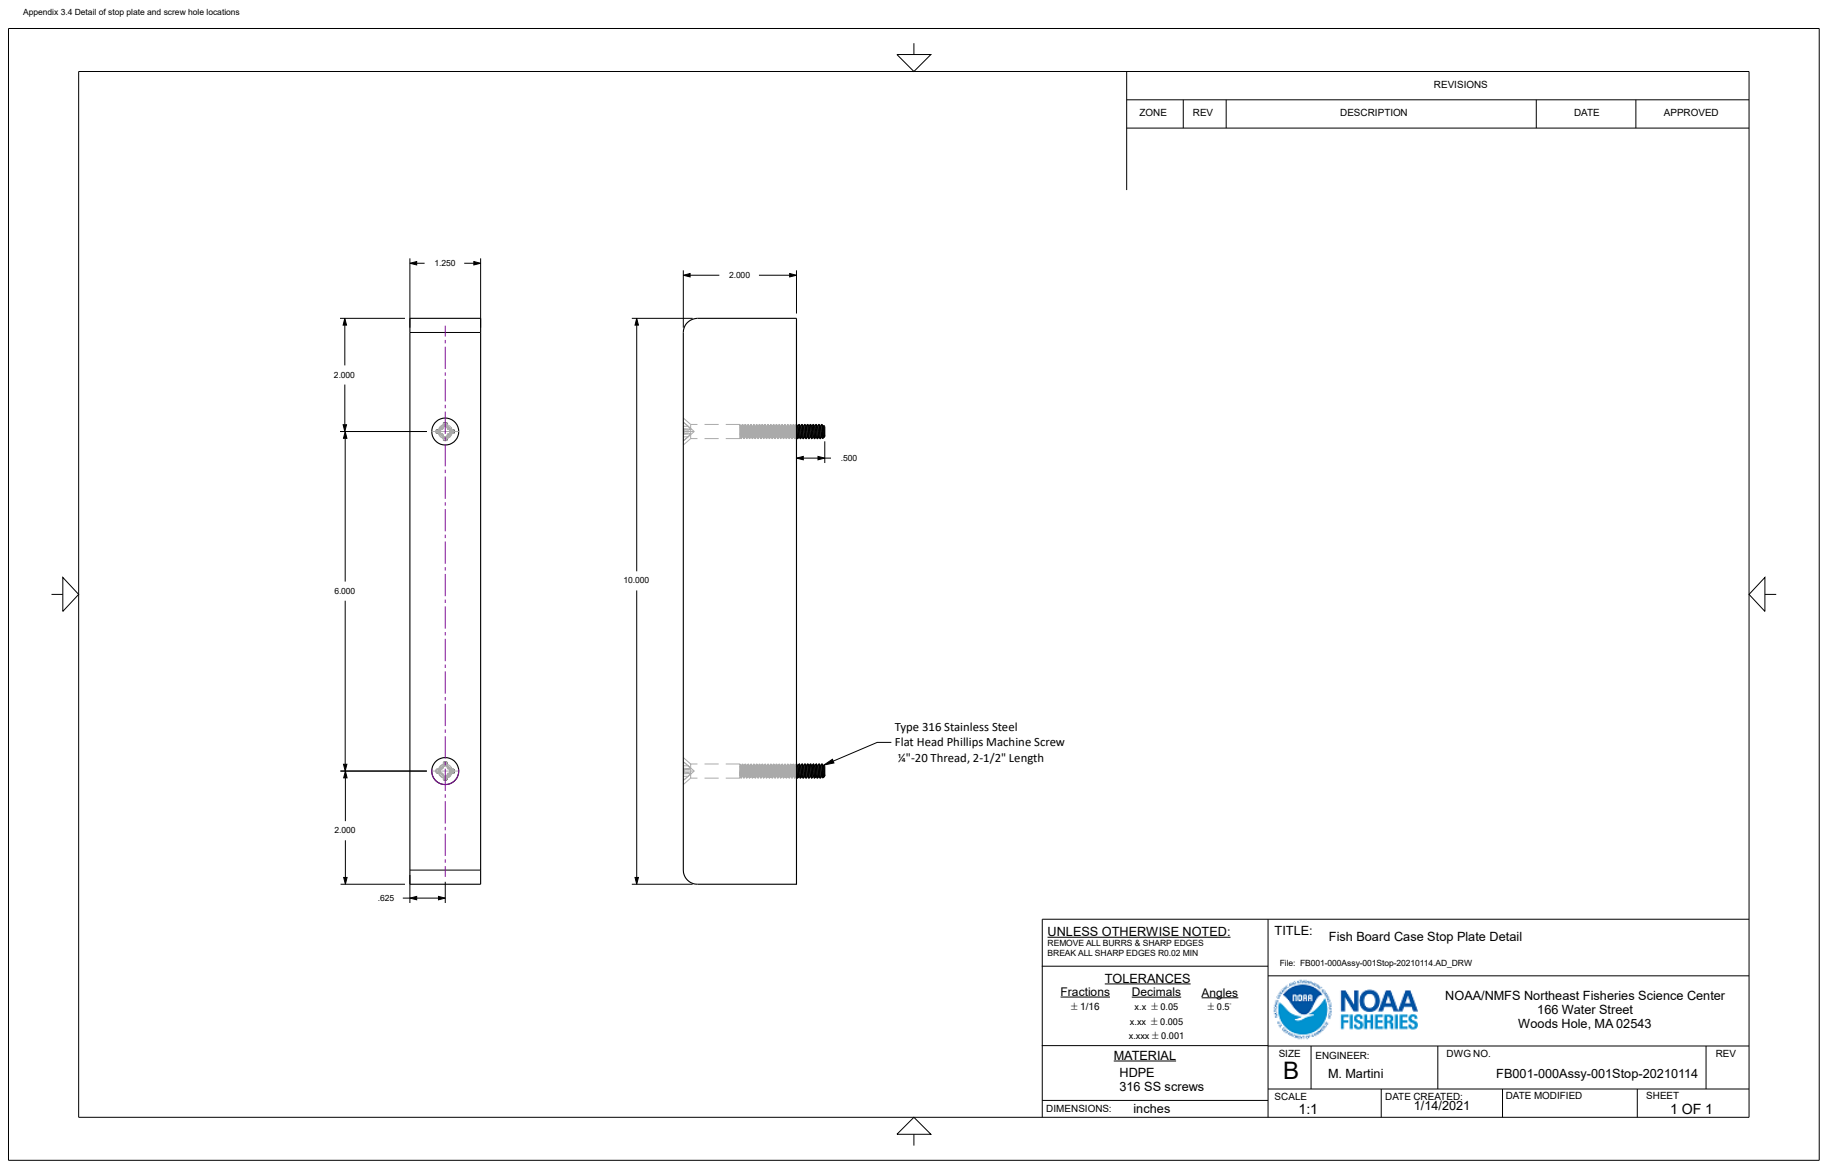
[picture p90: page 1]
DIMENSIONS:; Angles `0.5_; File: FB001-000Assy-001Stop-20210114.AD_DRW; Fractions `1/16; inches; TITLE:; Decimals x.x `0.05 x.xx `0.005 x.xxx `0.001; TOLERANCES

Appendix 3.4 Detail of stop plate and screw hole locations

REVISIONS

ZONE | REV | DESCRIPTION | DATE | APPROVED

Type 316 Stainless Steel
Flat Head Phillips Machine Screw
¼"‐20 Thread, 2‐1/2" Length

UNLESS OTHERWISE NOTED:
REMOVE ALL BURRS & SHARP EDGES
BREAK ALL SHARP EDGES R0.02 MIN

Fish Board Case Stop Plate Detail

NOAA/NMFS Northeast Fisheries Science Center

166 Water Street
Woods Hole, MA 02543

MATERIAL HDPE 316 SS screws | SIZE B | ENGINEER: M. Martini | DWG NO. FB001-000Assy-001Stop-20210114 | REV

SCALE 1:1 | DATE CREATED: 1/14/2021 | DATE MODIFIED | SHEET 1 OF 1
