NEFSC/PEMAD-ESB-IchthystickII/Documentation/WorkingDrafts/ManufacturingManual/Appendix 3.5.1 FishboardSubconnMod_IFMB-10407RevA.pdf

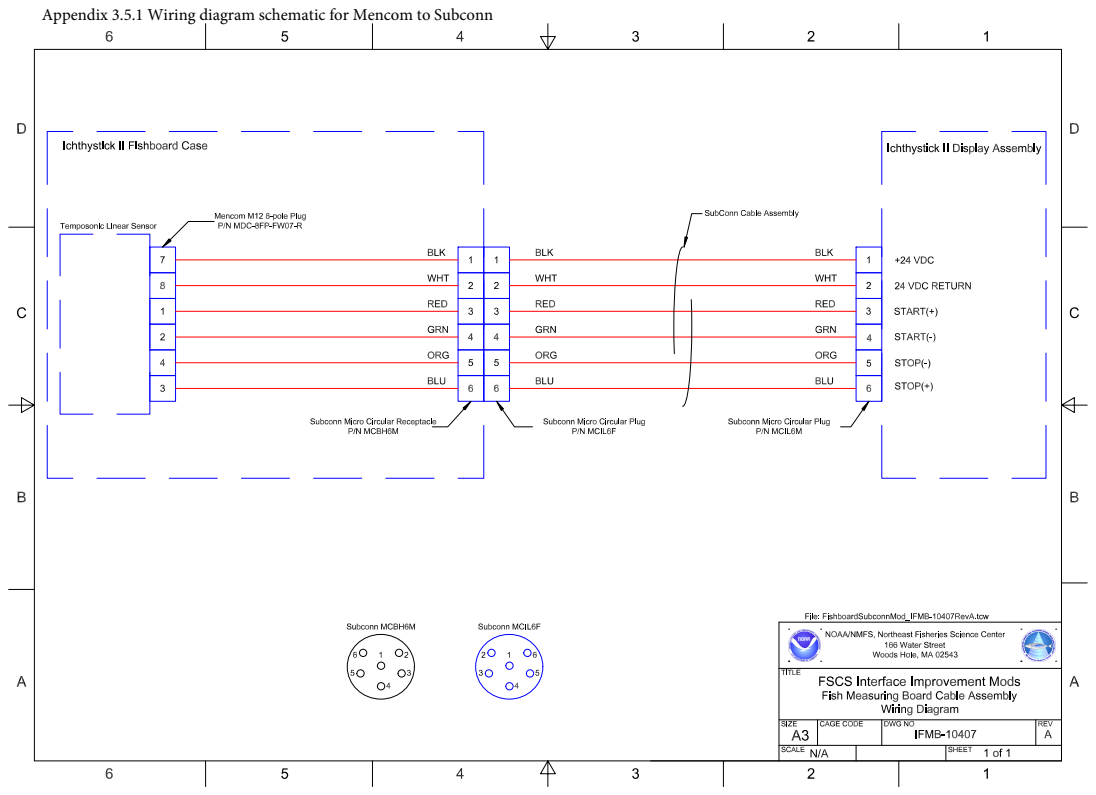
[picture p91: page 1]

Appendix 3.5.1 Wiring diagram schematic for Mencom to Subconn
