NEFSC/PEMAD-ESB-IchthystickII/Documentation/WorkingDrafts/ManufacturingManual/Appendix 3.5.3 FishboardSubconnMod_IFMB-10407.pdf

D

D

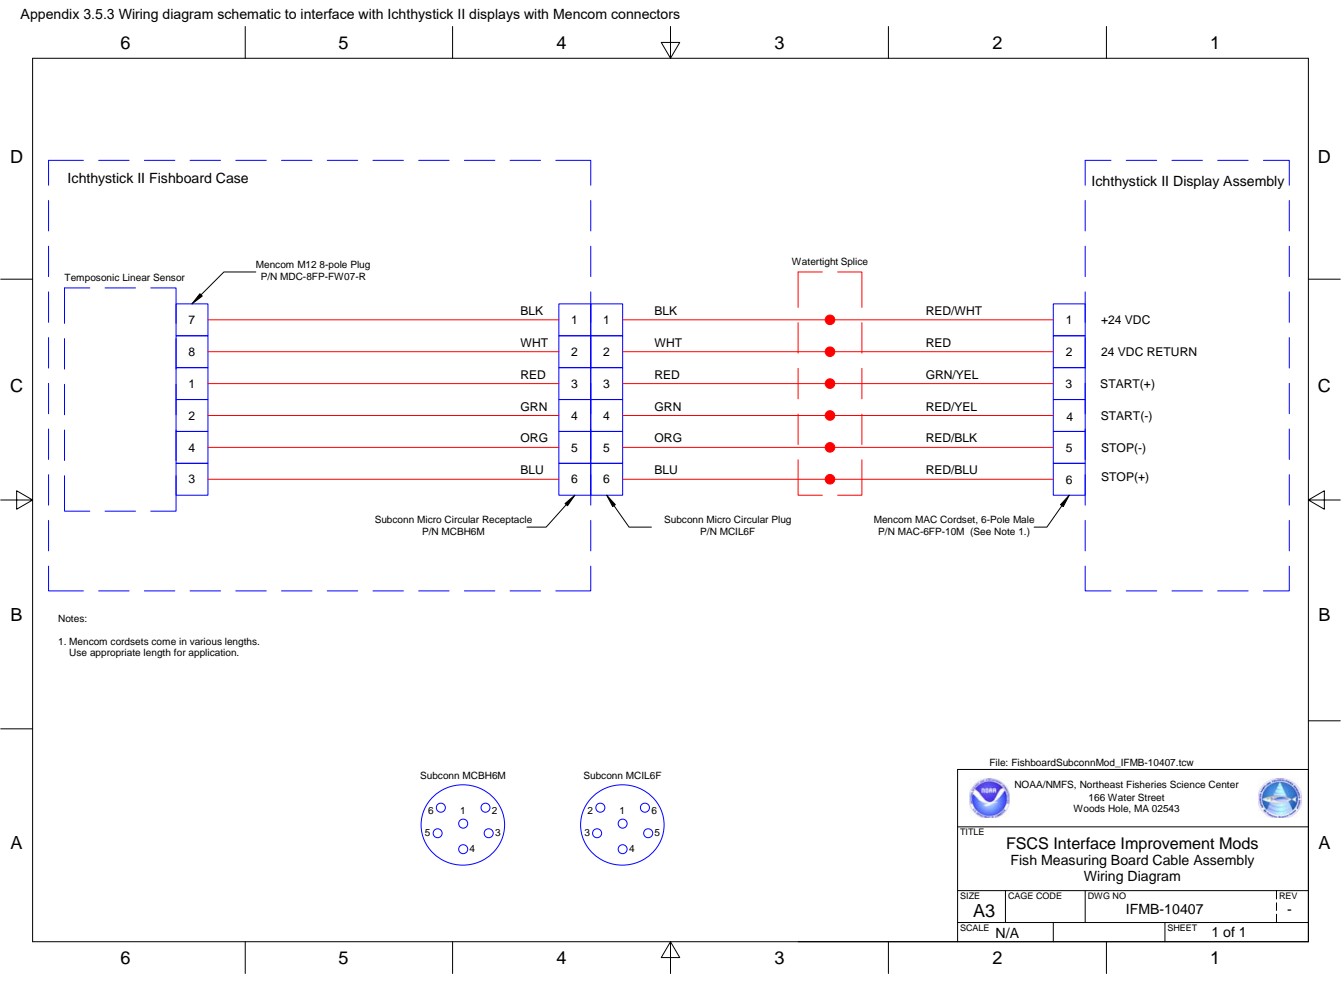
[picture p92: page 1]
SIZE; CAGE CODE; DWG NO; REV; IFMB-10407; Wiring Diagram; GRN/YEL; RED/YEL; RED/BLU; RED/BLK; START(+); START(-); STOP(+); STOP(-); Subconn MCBH6M; Notes:; File: FishboardSubconnMod_IFMB-10407.tcw; Subconn MCIL6F; +24 VDC; 24 VDC RETURN; RED/WHT; RED; BLK; WHT; GRN; ORG; BLU; P/N MCBH6M; P/N MCIL6F; Watertight Splice

Appendix 3.5.3 Wiring diagram schematic to interface with Ichthystick II displays with Mencom connectors

Ichthystick II Fishboard Case

Ichthystick II Display Assembly

Mencom M12 8-pole Plug
P/N MDC-8FP-FW07-R

Temposonic Linear Sensor

Subconn Micro Circular Receptacle

Subconn Micro Circular Plug

Mencom MAC Cordset, 6-Pole Male
P/N MAC-6FP-10M (See Note 1.)

1. Mencom cordsets come in various lengths.
Use appropriate length for application.

NOAA/NMFS, Northeast Fisheries Science Center

166 Water Street
Woods Hole, MA 02543

TITLE
FSCS Interface Improvement Mods
Fish Measuring Board Cable Assembly

SCALE N/A | SHEET 1 of 1
