NEFSC/PEMAD-ESB-IchthystickII/Documentation/WorkingDrafts/ManufacturingManual/Appendix 3.6.1 MeasuringWand_Circular.pdf

# Appendix 3.6.1 measurement wand, circular

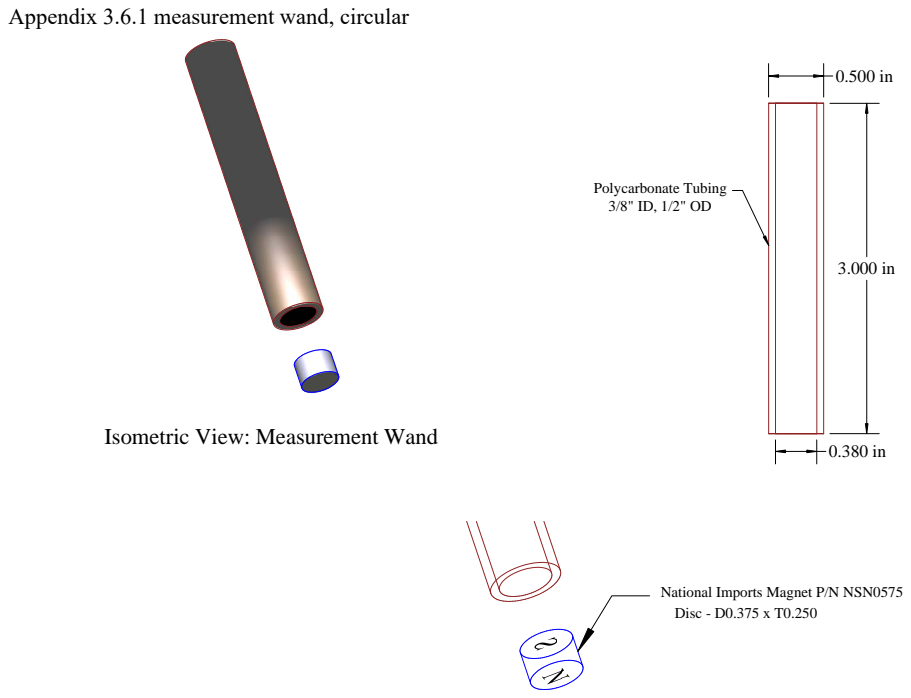
[picture p93: page 1]
Polycarbonate Tubing 3/8" ID, 1/2" OD

Isometric View: Measurement Wand

National Imports Magnet P/N NSN0575
Disc - D0.375 x T0.250
