NEFSC/PEMAD-ESB-IchthystickII/Documentation/WorkingDrafts/ManufacturingManual/StopPlate.pdf

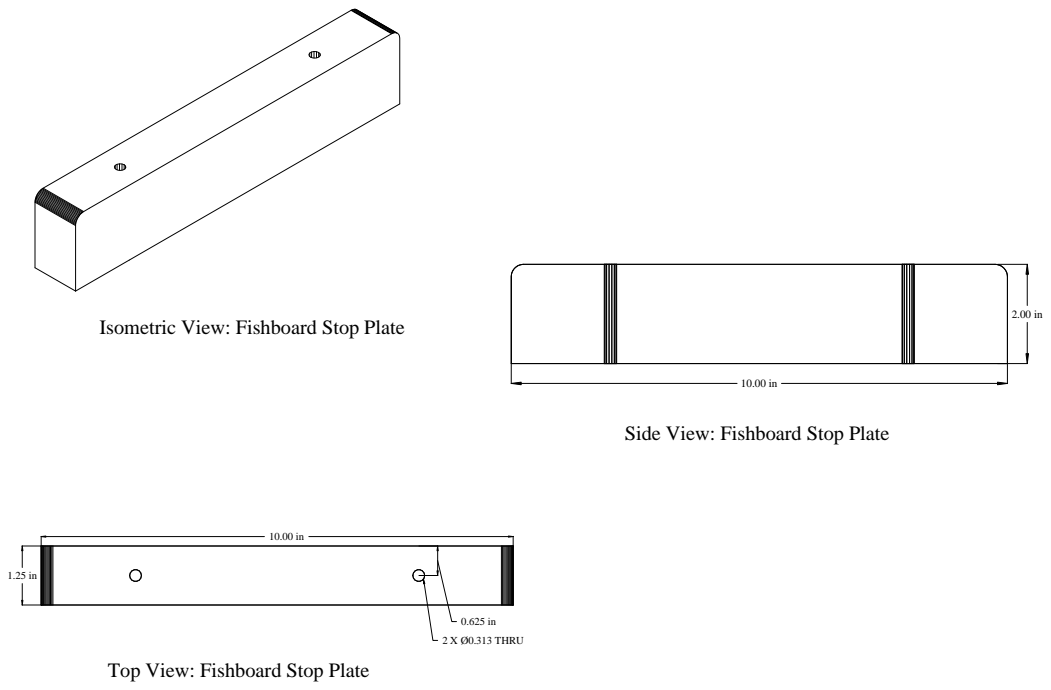
[picture p94: page 1]
2 X Ø0.313 THRU

Isometric View: Fishboard Stop Plate

Side View: Fishboard Stop Plate

Top View: Fishboard Stop Plate
