NEFSC/PEMAD-ESB-IchthystickII/Schematics/CircuitBoard_Design/NEFSC_FMB_RevF_board.pdf

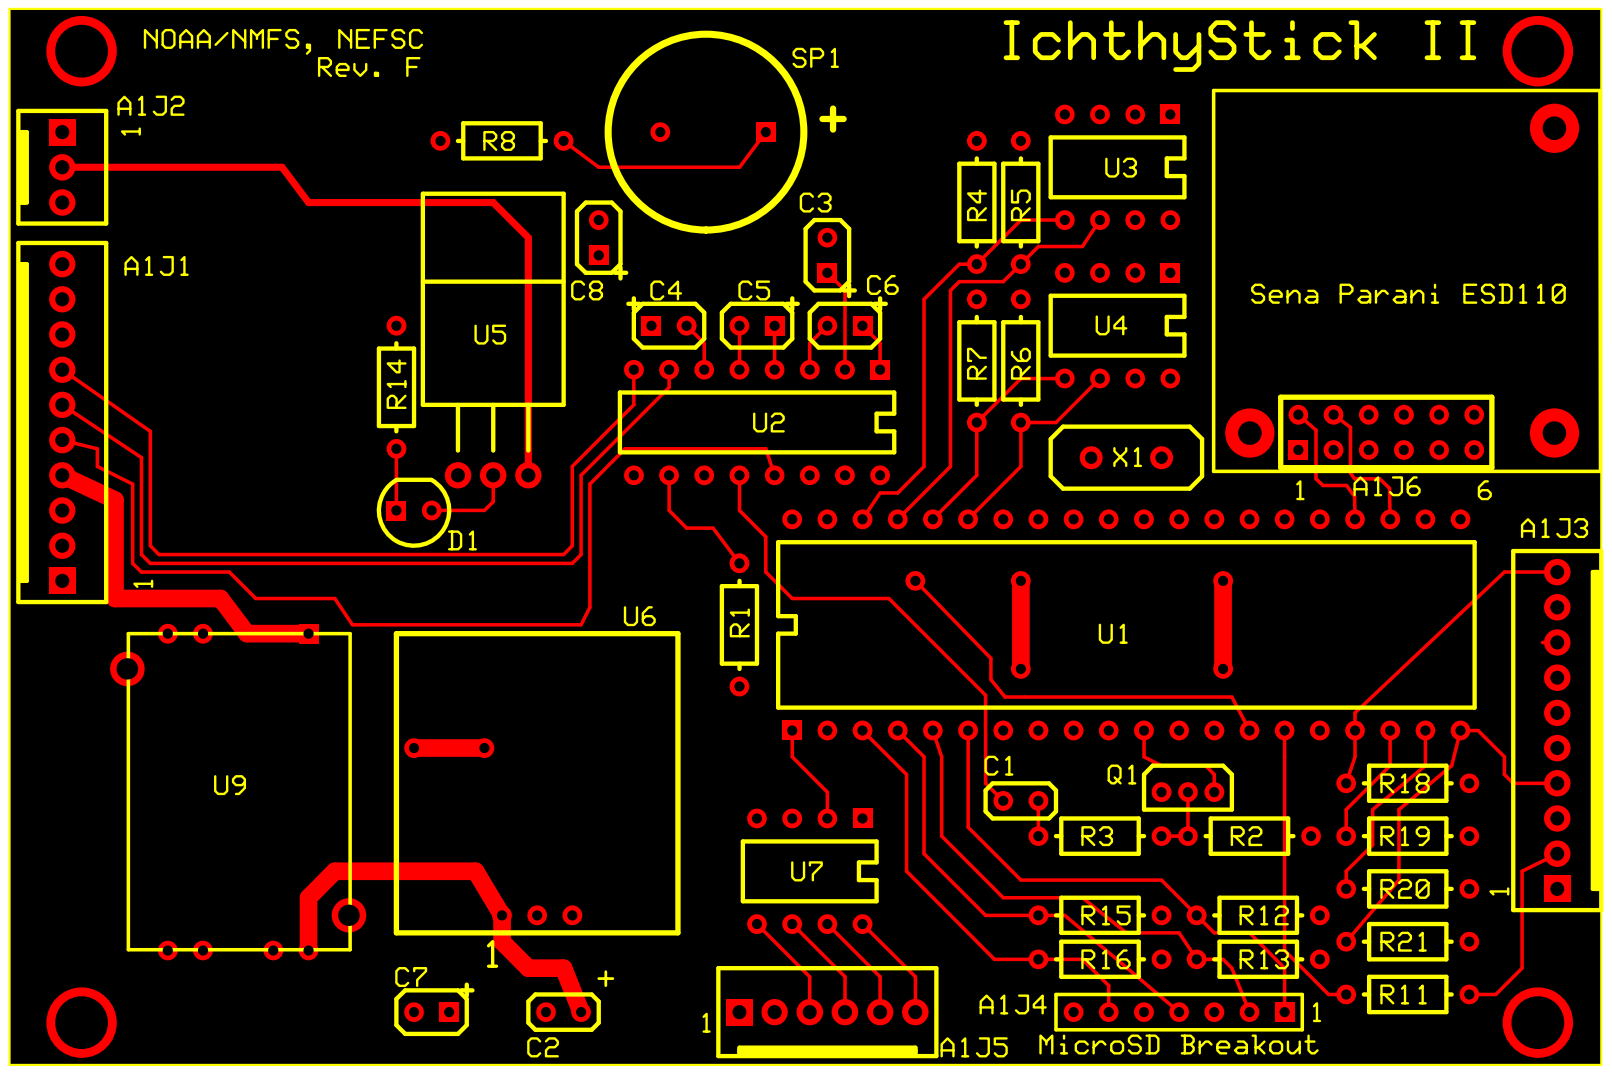
[picture p95: page 1]

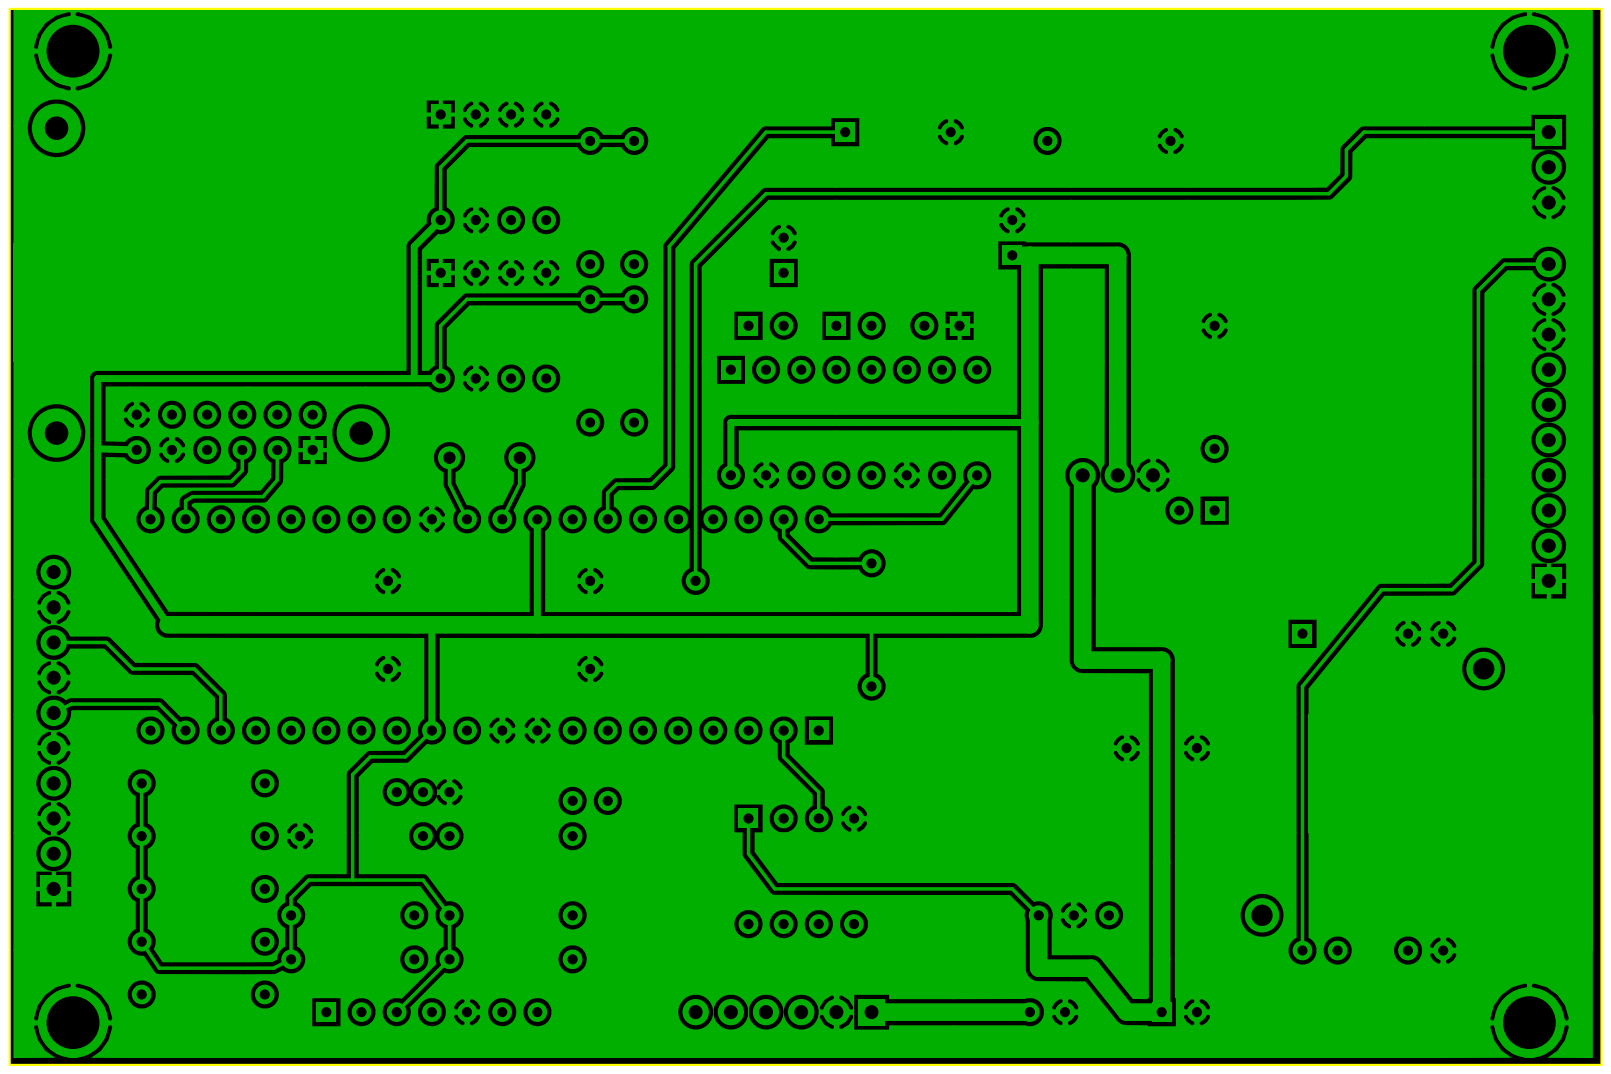
[picture p96: page 2]
