NEFSC/PEMAD-ESB-IchthystickII/Schematics/DisplayDesign_files/CableAssy_IFMB-10401.pdf

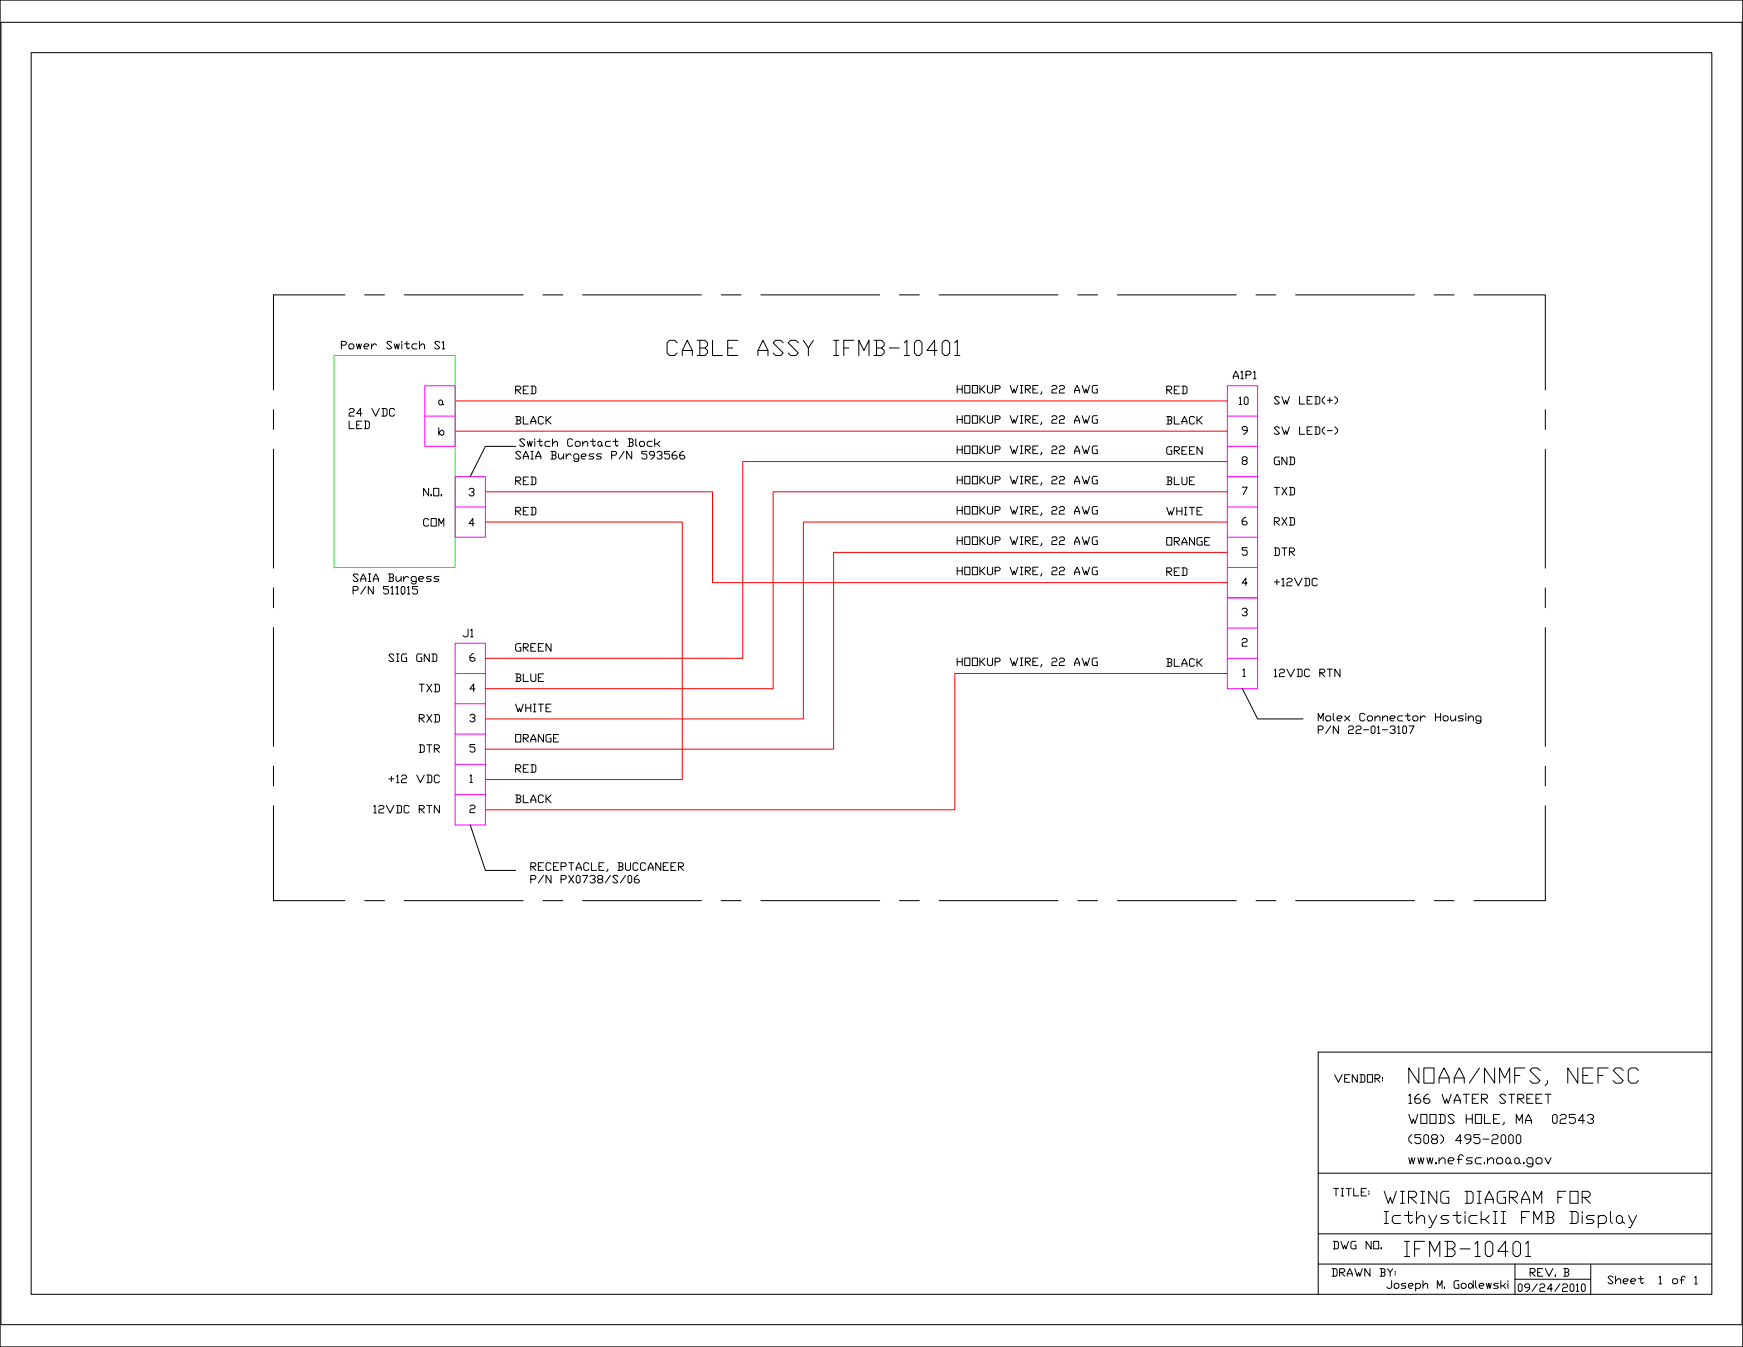
[picture p97: page 1]
