NEFSC/PEMAD-ESB-IchthystickII/Schematics/DisplayDesign_files/CableAssy_IFMB-10402.pdf

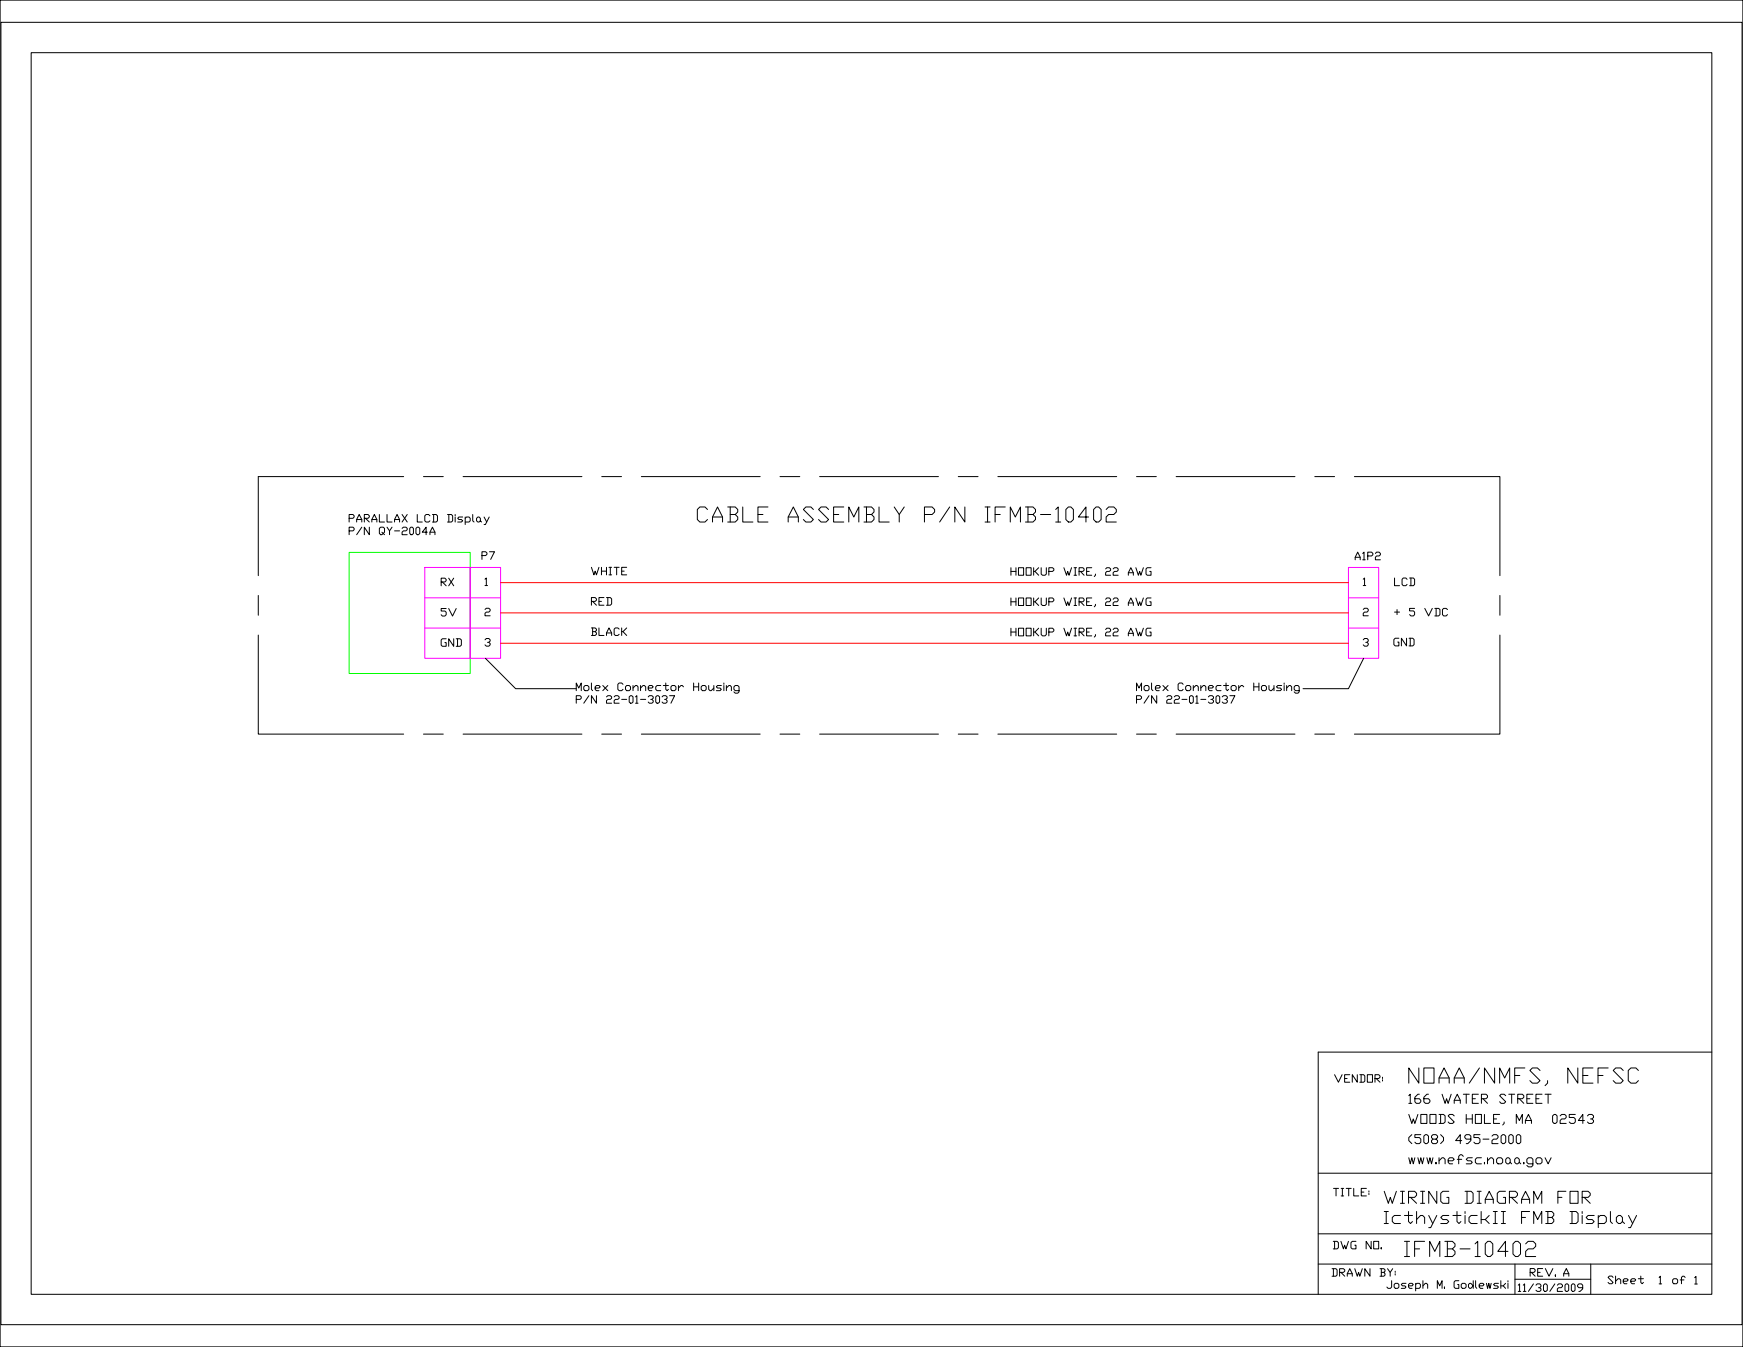
[picture p98: page 1]
