NEFSC/PEMAD-ESB-IchthystickII/Schematics/DisplayDesign_files/DisplayAssy_BlockDiag_IFMB-10400.pdf

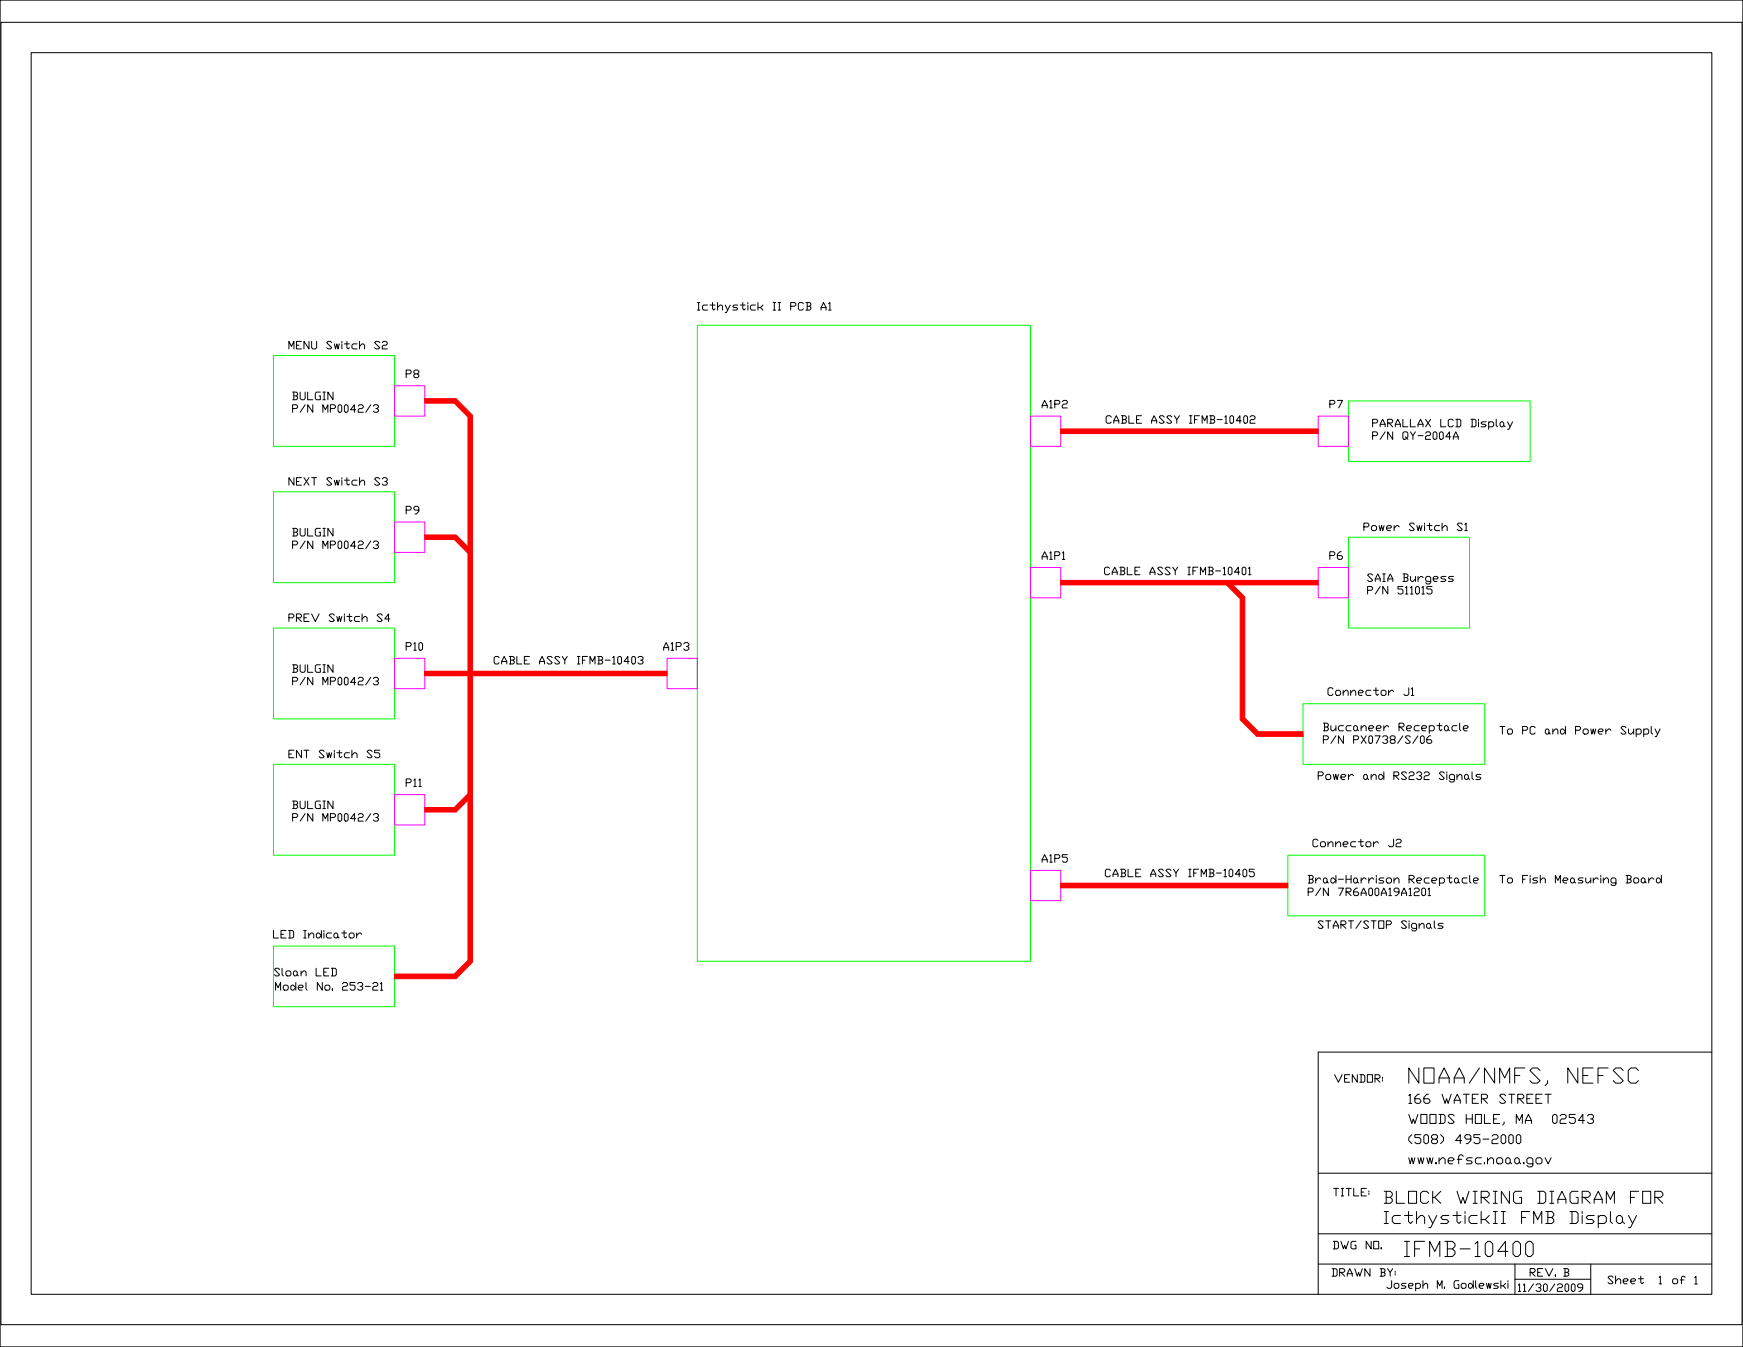
[picture p101: page 1]
