NEFSC/PEMAD-ESB-IchthystickII/Schematics/CircuitBoard_Design/NEFSC_FMB_RevD_schematic.pdf

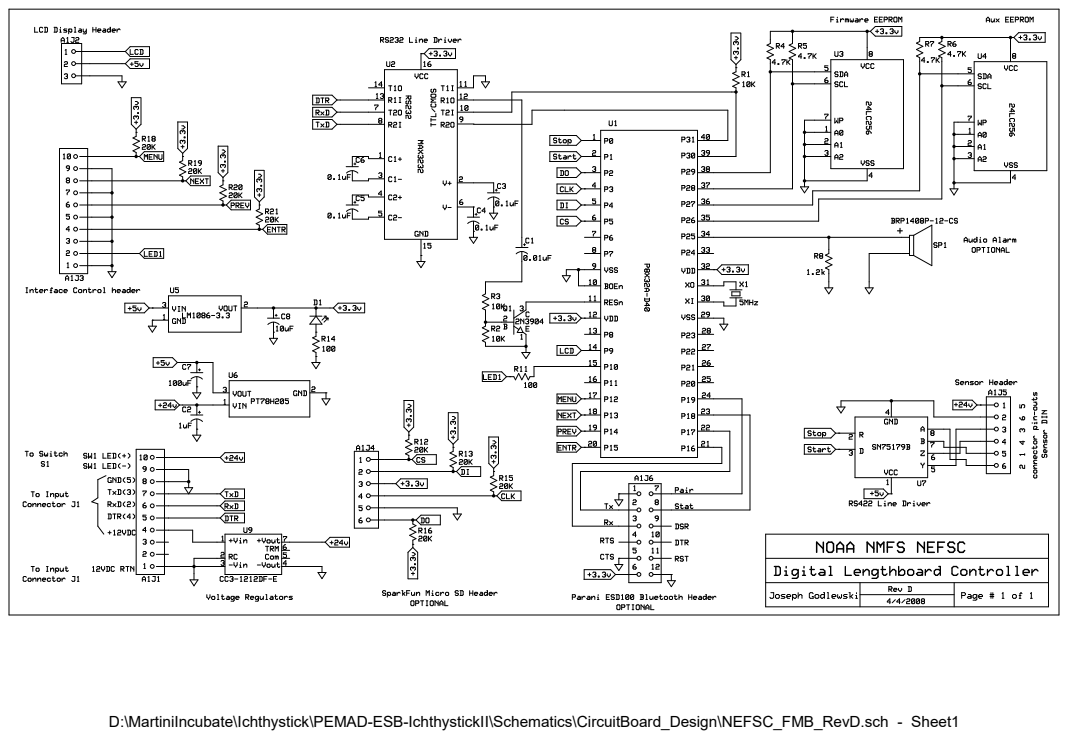
[picture p102: page 1]

D:\MartiniIncubate\Ichthystick\PEMAD-ESB-IchthystickII\Schematics\CircuitBoard_Design\NEFSC_FMB_RevD.sch - Sheet1
