NEFSC/PEMAD-ESB-IchthystickII/Schematics/CircuitBoard_Design/NEFSC_FMB_RevD_board.pdf

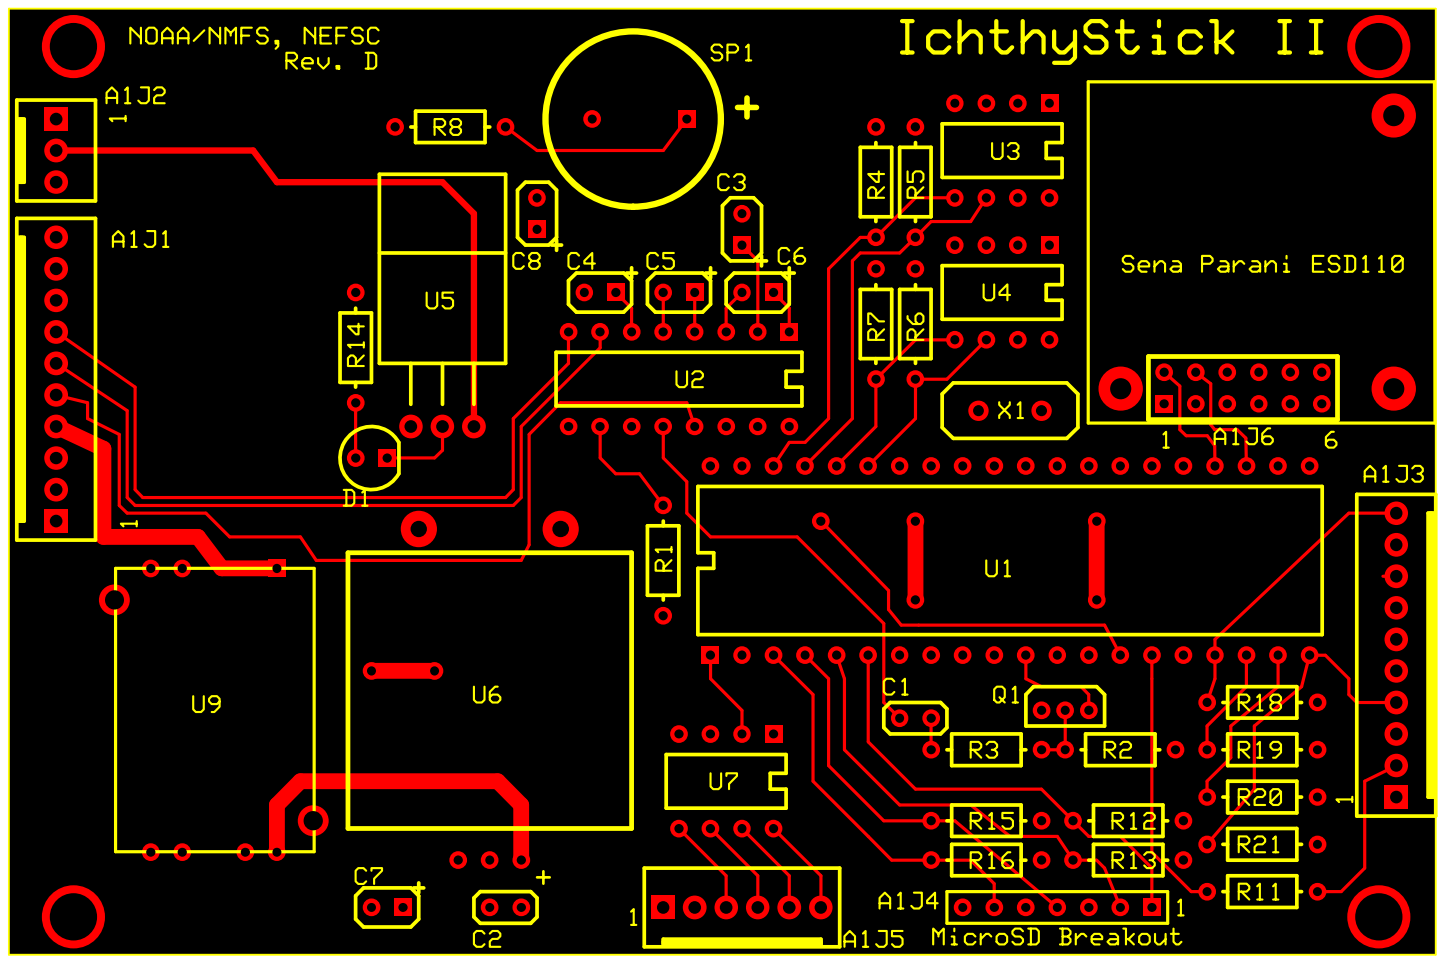
[picture p103: page 1]

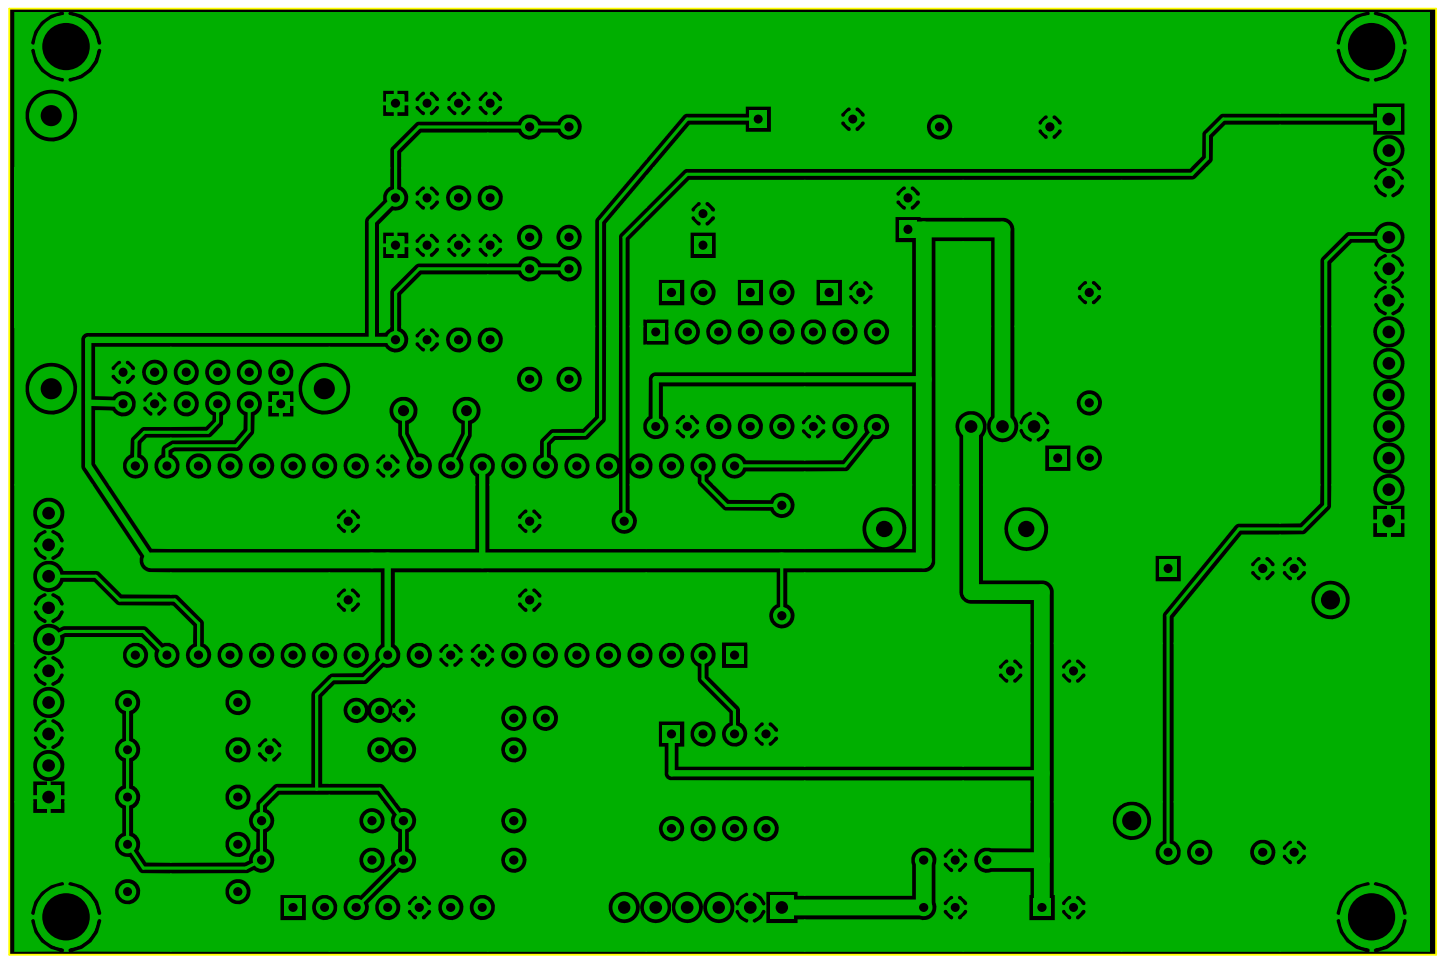
[picture p104: page 2]
