NEFSC/PEMAD-ESB-IchthystickII/(list of files, drawings)

Other design files:
Schematics/CircuitBoard_Design/NEFSC_FMB_RevD.pcb
Schematics/CircuitBoard_Design/NEFSC_FMB_RevF.pcb
