NEFSC/PEMAD-ESB-IchthystickII/(commit log)

2024-04-02 add example of calibration curve, shows ms values for sensor
    [FMB_CalExample.xls]
2025-01-29 Adding the best versions of schematics for the various flavors of fish board display
    [FMB_Display_PartsList.xls, FMB_Display_PartsListRevF.xls, NEFSC_FMB_RevD.pcb, NEFSC_FMB_RevD.sch, NEFSC_FMB_RevF.pcb, NEFSC_FMB_RevF.sch]
